MarcosAsh/protocol-emulator/docs/index.md

# protocol-emulator

A small chip that bit-bangs protocols from firmware, and a checker that proves the firmware's
timing before it ever runs. Written in Hardcaml for Jane Street's protocol emulator ASIC
competition, built on IHP CMOS5L through Tiny Tapeout, in 8 x 4 tiles at 48 MHz.

<!-- numbers from files the site already serves: info.yaml, the results page's tally, the
     corpus table; a missing source leaves its number out -->
<style>
  .stats { list-style: none; padding: 0; margin: 0 0 4px; }
  .stats li { display: inline; }
  .stats li + li::before { content: " \00b7\00a0"; color: var(--pst-color-text-muted); }
  .stats span::before { content: " "; }
</style>
<ul class="stats" id="stats" hidden></ul>
<p id="tally" hidden></p>
<script>
  (() => {
    const stats = document.getElementById("stats");
    const stat = (value, label) => {
      const li = document.createElement("li");
      const b = document.createElement("b");
      const span = document.createElement("span");
      b.textContent = value;
      span.textContent = label;
      li.append(b, span);
      stats.append(li);
      stats.hidden = false;
    };
    const text = (path) => fetch(path).then((r) => (r.ok ? r.text() : ""), () => "");
    const page = (path) => text(path).then((t) => new DOMParser().parseFromString(t, "text/html"));
    const results = page("results/").then((d) => {
      const tally = d.getElementById("tally");
      return tally ? tally.textContent.replace(/\.$/, "") : "";
    });
    const corpus = page("corpus/").then((d) => d.querySelectorAll('table a[href$=".html"]').length);
    Promise.all([text("info.yaml"), results, corpus]).then(([yaml, tally, protocols]) => {
      const hz = /^\s*clock_hz:\s*(\d+)/m.exec(yaml);
      const tiles = /^\s*tiles:\s*"?(\d+x\d+)/m.exec(yaml);
      const viewer = document.getElementById("viewer");
      const pdk = viewer ? new URL(viewer.href).searchParams.get("pdk") || "" : "";
      const proof = /(\d+) proved for all time/.exec(tally);
      if (protocols) stat(protocols, "in the corpus");
      if (proof) stat(proof[1], "claims proved for all time");
      if (hz) stat(Number(hz[1]) / 1e6, "MHz clock");
      if (tiles) stat(tiles[1], "tiles, IHP " + pdk.replace(/^ihp-sg13/, ""));
      if (tally) {
        const p = document.getElementById("tally");
        p.firstChild.textContent = tally;
        p.hidden = false;
      }
    });
  })();
</script>

from firmware to silicon

Two small cores drive the pins from firmware, much like the RP2040's PIO. The difference is
time. Each core has a 24-bit clock, a deadline register `t` and a period `p`. `wait t+`
releases on the exact cycle of the deadline and moves it on by one period, so a frame never
drifts. A UART bit or an I2C hold time is a deadline written in the program, not a count of
instructions you hope adds up.

A small kernel checks a certificate of each program's timing and refuses anything it can't
check. The kernel is proved against the RTL. If it accepts a program, that program never
misses a deadline on the chip, under the assumptions in
[What is not proved](verification.md#what-is-not-proved). The chip runs that check itself
and refuses to start an engine whose walk fails. If a deadline is ever missed anyway, the
engine lets go of its pins and halts, and that is proved too.

Start with [Getting started](getting-started.md), or paste firmware into the playground.

## Elsewhere on the site

<ul>
<li><a href="playground/">Firmware timing playground</a>: the assembler, the timing analyser and the kernel, compiled to JavaScript with js_of_ocaml.</li>
<li><a href="die/">Live die</a>: the hardened die, cells and wires lit as they switch.</li>
<!-- results -->
<li><a href="results/">Results</a>: the claims CI checks, the job that checks each, and its last run on main.</li>
<!-- /results -->
<!-- corpus -->
<li><a href="corpus/">Protocol corpus</a>: each protocol's limits, firmware, certificate and board runs, failures included.</li>
<!-- /corpus -->
<li><a id="viewer" href="https://gds-viewer.tinytapeout.com/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">3D viewer</a>: the last green gds run on main in Tiny Tapeout's GDS viewer, also as <a href="tinytapeout.gds">GDS</a> and <a href="tinytapeout.oas">OASIS</a>, and its <a href="gds_render.png">render</a>.</li>
</ul>

```{toctree}
:hidden:
:caption: Start
:maxdepth: 1

getting-started
```

```{toctree}
:hidden:
:caption: Design
:maxdepth: 1

architecture
datasheet
comparison
protocols
```

```{toctree}
:hidden:
:caption: Evidence
:maxdepth: 1

verification
flexibility
ai-use
```

```{toctree}
:hidden:
:caption: Hardware
:maxdepth: 1

hardware
lab
```

```{toctree}
:hidden:
:caption: Site
:maxdepth: 1

Playground <https://marcosash.github.io/protocol-emulator/playground/>
Results <https://marcosash.github.io/protocol-emulator/results/>
Live die <https://marcosash.github.io/protocol-emulator/die/>
Repository <https://github.com/MarcosAsh/protocol-emulator>
```
