MarcosAsh/protocol-emulator/test/board/kernel_vs_board/verdicts.tsv

uart_tx | 0 | 8 | 4 | 1 | accepted
uart_tx | 1 | 8 | 4 | 1 | accepted
uart_tx | 2 | 8 | 4 | 1 | accepted
uart_tx | 3 | 8 | 4 | 1 | accepted
uart_tx | 4 | 8 | 4 | 1 | accepted
uart_tx | 5 | 8 | 4 | 0 | refused: pc 9: in time
uart_tx | 6 | 8 | 4 | 0 | refused: pc 9: in time
uart_tx | 7 | 8 | 4 | 0 | refused: pc 9: in time
uart_tx16 | 0 | 8 | 12 | 1 | accepted
uart_tx16 | 1 | 8 | 12 | 1 | accepted
uart_tx16 | 2 | 8 | 12 | 1 | accepted
uart_tx16 | 3 | 8 | 12 | 1 | accepted
uart_tx16 | 4 | 8 | 12 | 1 | accepted
uart_tx16 | 5 | 8 | 12 | 1 | accepted
uart_tx16 | 6 | 8 | 12 | 1 | accepted
uart_tx16 | 7 | 8 | 12 | 1 | accepted
uart_tx16 | 8 | 8 | 12 | 1 | accepted
uart_tx16 | 9 | 8 | 12 | 1 | accepted
uart_tx16 | 10 | 8 | 12 | 1 | accepted
uart_tx16 | 11 | 8 | 12 | 1 | accepted
uart_tx16 | 12 | 8 | 12 | 1 | accepted
uart_tx16 | 13 | 8 | 12 | 0 | refused: pc 9: in time
uart_tx16 | 14 | 8 | 12 | 0 | refused: pc 9: in time
uart_tx16 | 15 | 8 | 12 | 0 | refused: pc 9: in time
uart_tx_host_rate | 0 | 10 | 430 | 1 | accepted
uart_tx_host_rate | 1 | 10 | 430 | 1 | accepted
uart_tx_host_rate | 2 | 10 | 430 | 1 | accepted
uart_tx_host_rate | 3 | 10 | 430 | 1 | accepted
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
