MarcosAsh/protocol-emulator/icepi/icepi_top.v

/*
 * Copyright (c) 2026 Marcos Ashton
 * SPDX-License-Identifier: Apache-2.0
 */

`default_nettype none

// The chip on an Icepi Zero. The 50 MHz oscillator goes through the PLL to MHZ (48, or 40
// for 10BASE-T, whose bit is four cycles) and the pins sit on the 40-pin header. With
// USB_UIO set, uio[1:0] are D+/D- on the first USB-C port, with the board's pull-up on D-
// for low speed or on D+ for full speed (FULL_SPEED). Their header pins mirror the bus so
// a host can see a bus reset. USB_PROBE moves the bus to header 8 (D+) and 12 (D-), in
// place of OUT0 and OUT2, where the bench carrier's analyser A reads D4 and D6. The
// button is reset.
module icepi_top #(
    parameter USB_UIO = 1,
    parameter MHZ = 48,
    parameter FULL_SPEED = 0,
    parameter USB_PROBE = 0
) (
    input  wire       clk,
    input  wire       button_n,
    input  wire [7:0] ui,
    output wire [7:0] uo,
    inout  wire [7:0] uio,
    inout  wire       usb_dp,
    inout  wire       usb_dn,
    output wire       usb_pull_dp,
    output wire       usb_pull_dn,
    input  wire       usb_detach
);

  wire clk_chip;
  wire clk_feedback;
  wire locked;

  // ecppll -i 50 -o 48 --highres: 50 / 5 = 10 MHz at the phase detector, VCO 480 MHz,
  // and CLKOS divides that by 10 for 48 MHz or 12 for 40.
  localparam CLKOS_MHZ = MHZ == 40 ? "40" : "48";
  (* FREQUENCY_PIN_CLKI = "50" *)
  (* FREQUENCY_PIN_CLKOS = CLKOS_MHZ *)
  (* ICP_CURRENT = "12" *)
  (* LPF_RESISTOR = "8" *)
  (* MFG_ENABLE_FILTEROPAMP = "1" *)
  (* MFG_GMCREF_SEL = "2" *)
  EHXPLLL #(
      .PLLRST_ENA("DISABLED"),
      .INTFB_WAKE("DISABLED"),
      .STDBY_ENABLE("DISABLED"),
      .DPHASE_SOURCE("DISABLED"),
      .OUTDIVIDER_MUXA("DIVA"),
      .OUTDIVIDER_MUXB("DIVB"),
      .OUTDIVIDER_MUXC("DIVC"),
      .OUTDIVIDER_MUXD("DIVD"),
      .CLKI_DIV(5),
      .CLKOP_ENABLE("ENABLED"),
      .CLKOP_DIV(48),
      .CLKOP_CPHASE(9),
      .CLKOP_FPHASE(0),
      .CLKOS_ENABLE("ENABLED"),
      .CLKOS_DIV(480 / MHZ),
      .CLKOS_CPHASE(0),
      .CLKOS_FPHASE(0),
      .FEEDBK_PATH("CLKOP"),
      .CLKFB_DIV(1)
  ) pll (
      .RST(1'b0),
      .STDBY(1'b0),
      .CLKI(clk),
      .CLKOP(clk_feedback),
      .CLKOS(clk_chip),
      .CLKFB(clk_feedback),
      .CLKINTFB(),
      .PHASESEL0(1'b0),
      .PHASESEL1(1'b0),
      .PHASEDIR(1'b1),
      .PHASESTEP(1'b1),
      .PHASELOADREG(1'b1),
      .PLLWAKESYNC(1'b0),
      .ENCLKOP(1'b0),
      .LOCK(locked)
  );

  wire [7:0] uio_in;
  wire [7:0] uio_out;
  wire [7:0] uio_oe;
  wire [7:0] uo_out;
  wire [7:0] header_in;
  wire [1:0] usb_in;

  wire [7:0] header_out = USB_UIO ? {uio_out[7:2], usb_in} : uio_out;
  wire [7:0] header_oe = USB_UIO ? {uio_oe[7:2], 2'b11} : uio_oe;
  wire [1:0] usb_oe = USB_UIO ? uio_oe[1:0] : 2'b00;

  BB uio_pad[7:0] (
      .B(uio),
      .I(header_out),
      .T(~header_oe),
      .O(header_in)
  );

  BB usb_pad[1:0] (
      .B({usb_dn, usb_dp}),
      .I(uio_out[1:0]),
      .T(~usb_oe),
      .O(usb_in)
  );

  assign uio_in = USB_UIO ? {header_in[7:2], usb_in} : header_in;

  // A pull pin driven high pulls its line up through a diode and 1.1 k. Floating, it
  // leaves the line alone. Driven low it would add a 15 k pull-down like the host's.
  OBZ pull_dp_pad (
      .I(1'b1),
      .T(!USB_UIO || !FULL_SPEED || usb_detach),
      .O(usb_pull_dp)
  );

  OBZ pull_dn_pad (
      .I(1'b1),
      .T(!USB_UIO || FULL_SPEED || usb_detach),
      .O(usb_pull_dn)
  );

  // no synchroniser here, the core does that itself
  assign uo = USB_PROBE ? {uo_out[7:4], usb_in[1], uo_out[2], usb_in[0], uo_out[0]} : uo_out;

  tt_um_marcosash_protocol_emulator chip (
      .ui_in(ui),
      .uo_out(uo_out),
      .uio_in(uio_in),
      .uio_out(uio_out),
      .uio_oe(uio_oe),
      .ena(1'b1),
      .clk(clk_chip),
      .rst_n(locked & button_n)
  );

endmodule
