MarcosAsh/protocol-emulator/python/learn_record.py

# SPDX-License-Identifier: Apache-2.0
# The chip records a transmitter it was never told about (MicroPython, Pico A). Each engine
# runs the edge logger on its line and stamps every edge with its own 16-bit clock. This
# script drains the stamps and reads the clock after each drain to extend every stamp to
# whole cycles, using the Pico's microseconds to count the clock's wraps between reads.
# If a drain finds stamps more than 65536 cycles (1.4 ms at 48 MHz) after the last, it marks
# the recording broken rather than guess. With two lines, engine 1 starts first and stamps
# the wire engine 0 raises as it starts, which puts both on one clock. record.json
# (demo/learn_prepare.py) has the loggers; record.edges and record.log are kept.

import array
import gc
import json
import os
import time

import micropython

import pico_board
import protocol_emulator as pe

CLOCK_HZ = 48_000_000
# cycles from engine 0 raising the wire to engine 1 stamping it: the same path as an edge
# on a pin, minus its two synchronizer flops
SYNC_CYCLES = 2
LATE_US = 1000


def load(host, engine):
    """Load and certify the logger. Every engine must be halted for the certificate."""
    host.select(engine["engine"])
    host.stop()
    host.flush()
    host.configure(dict(pe.DEFAULT_CONFIG, **engine["config"]))
    host.load(engine["words"])
    host.certify(engine["certificate"])


SELECTS = [bytes((0x80 | pe.SELECT, 0, engine)) for engine in range(2)]
# stamps an engine can hold, enough for a recording
MOST = 3000
NOW = array.array("i", [0])
# progress of a recording: the step of the loop, and the polls done
AT = array.array("i", [0, 0])


@micropython.native
def poll(spi, engine, words, count):
    """Select engine, put its waiting words in words from count, and return the new count.
    The low half of its clock, read after the drain, goes in NOW. Nothing here allocates,
    since the heap is locked while recording."""
    # one name per line, since assigning four names at once would build a tuple
    cs_n = spi.cs_n
    bus = spi.spi
    status = spi.status
    rx_in = spi.rx_in
    cs_n(0)
    bus.write(SELECTS[engine])
    cs_n(1)
    cs_n(0)
    bus.write_readinto(spi.reads[pe.STATUS], status)
    cs_n(1)
    level = (status[1] >> 2) & 15
    if level:
        out, into = spi.rx_frames[level]
        cs_n(0)
        bus.write_readinto(out, into)
        cs_n(1)
        for i in range(1, 1 + 2 * level, 2):
            if count < MOST:
                words[count] = rx_in[i] << 8 | rx_in[i + 1]
                count += 1
    cs_n(0)
    bus.write_readinto(spi.reads[pe.NOW_LO], status)
    cs_n(1)
    NOW[0] = status[1] << 8 | status[2]
    return count


def record(spi, host, engines, ms):
    # start engine 1 first if there are two; it waits for engine 0's wire
    for e in sorted(engines, key=lambda e: -e["engine"]):
        load(host, e)
    n = len(engines)
    ids = [e["engine"] for e in engines]
    words = [array.array("H", (0 for _ in range(MOST))) for _ in range(n)]
    times = [array.array("i", (0 for _ in range(MOST))) for _ in range(n)]
    counts = [0] * n
    last = [0] * n
    clock = [0] * n
    late = 0
    # a collection mid-recording would make a poll late
    gc.collect()
    # the clocks start here, so the first poll's wraps count from now and not from before
    # the arrays were made
    for e in sorted(engines, key=lambda e: -e["engine"]):
        host.select(e["engine"])
        host.start()
    then = [time.ticks_us()] * n
    start = time.ticks_ms()
    AT[0] = 0
    # a locked heap raises MemoryError at the first allocation instead of running out
    # seconds later
    micropython.heap_lock()
    try:
        while time.ticks_diff(time.ticks_ms(), start) < ms:
            for k in range(n):
                AT[0] = 1
                before = counts[k]
                count = poll(spi, ids[k], words[k], before)
                AT[0] = 2
                now = NOW[0]
                counts[k] = count
                t = time.ticks_us()
                gap = time.ticks_diff(t, then[k])
                then[k] = t
                AT[0] = 3
                # the whole 65536s of the clock come from the Pico's microseconds, the rest
                # from the clock itself
                low = (now - last[k]) & 0xFFFF
                wraps = (gap * (CLOCK_HZ // 1_000_000) - low + 32768) >> 16
                clock[k] += low + (wraps << 16 if wraps > 0 else 0)
                last[k] = now
                AT[0] = 4
                if count > before and gap > LATE_US:
                    # a stamp could be one wrap older than it reads
                    late += 1
                AT[0] = 5
                for i in range(before, count):
                    times[k][i] = clock[k] - ((now - words[k][i]) & 0xFFFF)
                AT[1] += 1
    finally:
        micropython.heap_unlock()
    words = [list(w[:c]) for w, c in zip(words, counts)]
    times = [list(t[:c]) for t, c in zip(times, counts)]
    faults = []
    for e in engines:
        host.select(e["engine"])
        faults.append(host.read(pe.STATUS)[0] & 0x3C)
        host.stop()
    return words, times, late, faults


def run(log=print):
    # drop any recording left by an earlier run
    try:
        os.remove("record.edges")
    except OSError:
        pass
    settings = json.load(open("record.json"))
    engines = settings["engines"]
    spi = pico_board.PicoSpi()
    host = pe.Host(spi.transfer)
    words, times, late, faults = record(spi, host, engines, settings["ms"])
    lines = []
    offset = 0
    for k, e in enumerate(engines):
        # the sync stamp, then the line's level, then one edge per word
        skip = 1 + (1 if e.get("sync") else 0)
        if e.get("sync"):
            offset = times[k][0] - SYNC_CYCLES
        lines.append((e, words[k][skip - 1] if len(words[k]) >= skip else None, times[k][skip:]))
    out = ["rate %d" % CLOCK_HZ]
    pins = []
    length = 0
    for e, level, edges in lines:
        # engine 0's clock started at its own start, which engine 1 saw at offset
        shift = 0 if e.get("sync") else offset
        edges = [t + shift for t in edges]
        if edges:
            length = max(length, edges[-1] + 1)
        pins.append("pin %s %d %s" % (e["name"], level or 0, " ".join(str(t) for t in edges)))
    out.append("length %d" % length)
    with open("record.edges", "w") as f:
        f.write("\n".join(out + pins) + "\n")
    for (e, _, edges), fault in zip(lines, faults):
        log("%s: %d edges stamped by engine %d, faults 0x%x" % (e["name"], len(edges), e["engine"], fault))
    log("drains with stamps more than %d us apart: %d" % (LATE_US, late))
    ok = not late and not any(faults) and all(len(edges) for _, _, edges in lines)
    log("PASS" if ok else "FAIL")
    return ok


if __name__ == "__main__":
    lines = []

    def log(text):
        print(text)
        lines.append(text)

    try:
        run(log)
    except Exception as e:
        log("stopped: %r at step %d of poll %d, %d bytes free" % (e, AT[0], AT[1], gc.mem_free()))
        log("FAIL")
    with open("record.log", "w") as f:
        f.write("\n".join(lines) + "\n")
