MarcosAsh/protocol-emulator/python/learn_replay.py

# SPDX-License-Identifier: Apache-2.0
# Pico B plays a transmitter the chip was never told about (MicroPython). Plays replay.json's
# segments, each giving which lines are pulled low and for how many microseconds, from a PIO
# machine at 1 MHz on GP2 (IO3) and GP3 (IO2). The pins are open drain against the
# carrier's pull-ups, like an IR receiver module's output. Segments come from public
# recordings (demo/learn_prepare.py).

import array
import json
import time

import rp2
from machine import Pin

# pull, out and out before the count's first pass, then the count's last pass
OVERHEAD = 4
# demo/capture.sh starts the analyser after mpremote returns, and that takes up to 3 s
START_MS = 3000
# the lines stay at the recording's idle level this long afterwards, past the end of the
# chip's recording, so a line that idles low is low at both ends of the recording
HOLD_MS = 5000


@rp2.asm_pio(set_init=(rp2.PIO.IN_LOW,) * 2, out_init=(rp2.PIO.IN_LOW,) * 2,
             out_shiftdir=rp2.PIO.SHIFT_RIGHT)
def segments():
    # pin values stay low, so pulling a line low only changes its direction
    set(pins, 0)  # noqa: F821
    wrap_target()  # noqa: F821
    pull(block)  # noqa: F821
    out(pindirs, 2)  # noqa: F821
    out(x, 30)  # noqa: F821
    label("count")  # noqa: F821
    jmp(x_dec, "count")  # noqa: F821
    wrap()  # noqa: F821


def words(segs):
    return [low | ((max(us, OVERHEAD + 1) - OVERHEAD) << 2) for low, us in segs]


def send(segs):
    sm = rp2.StateMachine(0, segments, freq=1_000_000, set_base=Pin(2), out_base=Pin(2))
    sm.active(1)
    sm.put(array.array("I", words(segs)))
    # the last segment is idle, so the lines are released when it starts
    total_ms = sum(us for _, us in segs) // 1000
    time.sleep_ms(total_ms + 20)
    sm.active(0)
    Pin(2, Pin.IN)
    Pin(3, Pin.IN)


if __name__ == "__main__":
    replay = json.load(open("replay.json"))
    segs = replay["segments"]
    send([[segs[0][0], START_MS * 1000]] + segs + [[segs[-1][0], HOLD_MS * 1000], [0, 1000]])
    print("sent %d segments" % len(replay["segments"]))
