MarcosAsh/protocol-emulator/formal/usb_roundtrip.sv

// Round trip: a host sends one packet (any PID byte) from any sampling phase, at exactly
// 8 samples a bit, into usb_frame_rx with may_write free. The packet is data of up to BYTES
// bytes with its CRC-16, a token with its CRC-5, or a handshake. Each word written is the
// bytes sent as the receiver packs them, at base + its index. At finished, the counts,
// half, aligned and CRC are right. With SEVEN, any bits after SYNC that contain seven 1s
// end in stuff_error. With TWICE, the receiver is armed once with rearm held, and a packet
// of its own follows the first once that has landed. finished falls as the second starts,
// its words land from base as the first's did, and the same checks hold for it.

`ifndef BYTES
`define BYTES 8
`endif

module usb_roundtrip (input clk);
  localparam N = `BYTES;
  localparam M = 8 * N + 24;
  localparam DATA = 2'd0, TOKEN = 2'd1, HANDSHAKE = 2'd2;
  localparam [1:0] J = 2'b10, K = 2'b01, SE0 = 2'b00;
  localparam GAP = 3'd0, SYNC = 3'd1, MESSAGE = 3'd2, EOP = 3'd3, DONE = 3'd4;
  localparam IDLE = 2'd0, HUNT = 2'd1, PACKET = 2'd2;

  (* anyconst *) wire [1:0] kind_1;
  (* anyconst *) wire [7:0] pid_1;
  (* anyconst *) wire [7:0] len_1;
  (* anyconst *) wire [8*N-1:0] payload_1;
  (* anyconst *) wire [10:0] token_1;
  // which packet is on the line: the first, or with TWICE the second once its gap starts
  reg round = 0;
`ifdef TWICE
  (* anyconst *) wire [1:0] kind_2;
  (* anyconst *) wire [7:0] pid_2;
  (* anyconst *) wire [7:0] len_2;
  (* anyconst *) wire [8*N-1:0] payload_2;
  (* anyconst *) wire [10:0] token_2;
  wire [1:0] kind = round ? kind_2 : kind_1;
  wire [7:0] pid = round ? pid_2 : pid_1;
  wire [7:0] len = round ? len_2 : len_1;
  wire [8*N-1:0] payload = round ? payload_2 : payload_1;
  wire [10:0] token = round ? token_2 : token_1;
  always @(*) assume(kind_2 != 3 && len_2 <= N);
  wire rearm = 1;
`else
  wire [1:0] kind = kind_1;
  wire [7:0] pid = pid_1;
  wire [7:0] len = len_1;
  wire [8*N-1:0] payload = payload_1;
  wire [10:0] token = token_1;
  wire rearm = 0;
`endif
  (* anyconst *) wire [2:0] offset;
  (* anyconst *) wire [1:0] gap;
  (* anyconst *) wire [8:0] base;
  (* anyseq *) wire may_write;
  // SEVEN: any bits after SYNC, unstuffed
  (* anyseq *) wire raw;

  always @(*) begin
    assume(kind_1 != 3);
    assume(len_1 <= N);
  end

`ifdef SHORT
  // a tooth's packet, short enough to fail fast
  always @(*) assume(gap == 0 && offset == 0 && len == 0);
`endif
`ifdef SHORT_TWICE
  // a tooth's two packets: a handshake, then a token
  always @(*) assume(gap == 0 && offset == 0 && kind_1 == HANDSHAKE && kind_2 == TOKEN);
`endif
`ifdef PINNED
  // each cover starts from the bus idle as soon as it can, with DATA0 and all 1s to stuff
  // the most, so the solver only has to choose the kind and may_write
  always @(*) begin
    assume(gap == 0 && offset == 0 && pid == 8'hc3);
    assume(payload == {8*N{1'b1}} && token == 11'h7ff);
`ifdef LONG
    assume(kind == DATA && len == N);
`else
    assume(len == 0);
`endif
  end
`endif

  // cleared, then armed, then left alone
  reg [1:0] age = 0;
  always @(posedge clk) if (age != 3) age <= age + 2'd1;
  wire clear = age == 0;
  wire arm = age == 1;

  // the message after SYNC, first bit lowest: the PID, then either the payload and its
  // CRC-16, or the address, endpoint and their CRC-5. Each CRC is complemented as USB sends it.
  reg [15:0] crc16 = 16'hffff;
  reg [4:0] crc5 = 5'h1f;
`ifdef CRC_RAW
  wire [15:0] crc16_sent = crc16;
  wire [4:0] crc5_sent = crc5;
`else
  wire [15:0] crc16_sent = ~crc16;
  wire [4:0] crc5_sent = ~crc5;
`endif
  wire [9:0] covered = kind == DATA ? {len, 3'd0} : kind == TOKEN ? 10'd11 : 10'd0;
  wire [9:0] message_bits = 10'd8 + covered
    + (kind == DATA ? 10'd16 : kind == TOKEN ? 10'd5 : 10'd0);
  wire [7:0] bytes = message_bits[9:3];
  wire [8*N-1:0] shown = payload & ~({8*N{1'b1}} << covered);
  wire [M-1:0] message = kind == DATA
      ? {{M-8*N-8{1'b0}}, shown, pid} | ({{M-16{1'b0}}, crc16_sent} << (covered + 10'd8))
    : kind == TOKEN ? {{M-24{1'b0}}, crc5_sent, token, pid} : {{M-8{1'b0}}, pid};

  reg [2:0] state = GAP;
  // cycles idle after the packet, until may_write comes
  reg [1:0] idle = 0;
  reg [9:0] count = 0;
  reg [2:0] ones = 0;
  reg seven = 0;
  reg stuffed = 0;
  reg [1:0] line = J;
  reg [2:0] sub = 0;

  wire [M-1:0] message_at = message >> count;
`ifdef SEVEN
  // chosen a bit ahead, so it holds while the bit is on the wire
  reg raw_bit = 0;
  always @(posedge clk) if (sub == 3 || sub == 4) raw_bit <= raw;
  wire data_bit = raw_bit;
`else
  wire data_bit = message_at[0];
`endif
`ifdef NO_STUFF
  wire stuff = 0;
`else
  wire stuff = ones == 6;
`endif
  wire [1:0] toggled = line == J ? K : J;

  // the encoder after one more bit, and that bit's line state
  reg [1:0] next_line;
  reg [2:0] next_state;
  reg [9:0] next_count;
  reg [2:0] next_ones;
  reg [15:0] next_crc16;
  reg [4:0] next_crc5;
  always @(*) begin
    next_line = line;
    next_state = state;
    next_count = count + 10'd1;
    next_ones = ones;
    next_crc16 = crc16;
    next_crc5 = crc5;
    case (state)
      GAP: begin
        next_line = J;
        if (count == gap) begin
          next_state = SYNC;
          next_count = 0;
        end
      end
      SYNC: begin
        // KJKJKJKK: seven 0s and a 1, which starts the run
        next_line = count == 7 ? line : toggled;
        if (count == 7) begin
          next_state = MESSAGE;
          next_count = 0;
          next_ones = 1;
        end
      end
      MESSAGE:
        if (stuff) begin
          next_line = toggled;
          next_count = count;
          next_ones = 0;
        end else if (count < message_bits) begin
          next_line = data_bit ? line : toggled;
          next_ones = data_bit ? (ones == 7 ? ones : ones + 3'd1) : 3'd0;
          if (count >= 8 && count < 8 + covered) begin
            next_crc16 = {1'b0, crc16[15:1]} ^ (crc16[0] ^ data_bit ? 16'ha001 : 16'd0);
            next_crc5 = {1'b0, crc5[4:1]} ^ (crc5[0] ^ data_bit ? 5'h14 : 5'd0);
          end
        end else begin
          next_line = SE0;
          next_state = EOP;
          next_count = 1;
        end
      EOP: begin
        next_line = count == 1 ? SE0 : J;
        if (count == 2) next_state = DONE;
      end
      default: begin
        next_line = J;
        next_count = count;
`ifdef TWICE
        if (!round && idle == 3) begin
          next_state = GAP;
          next_count = 0;
        end
`endif
      end
    endcase
  end

  // The bit on the wire is decided at its centre, sample 4 of 8. line and the state are
  // the encoder's as of the last bit decided. There are two samples per cycle; sub is the
  // place of the first.
  wire decide = sub == 3 || sub == 4;
  wire [1:0] first = sub <= 4 ? next_line : line;
  wire [1:0] second = sub == 5 || sub == 6 ? line : next_line;
  always @(posedge clk) begin
    sub <= clear ? offset : sub + 3'd2;
    if (!clear && decide) begin
      line <= next_line;
      state <= next_state;
      count <= next_count;
      ones <= next_ones;
      crc16 <= next_crc16;
      crc5 <= next_crc5;
      if (state == MESSAGE && !stuff && count < message_bits && ones == 6 && data_bit)
        seven <= 1;
      if (state == MESSAGE && stuff) stuffed <= 1;
      if (state == DONE && next_state == GAP) begin
        round <= 1;
        crc16 <= 16'hffff;
        crc5 <= 5'h1f;
      end
    end
  end

  wire write_valid;
  wire [8:0] write_addr;
  wire [15:0] write_data;
  wire [9:0] words;
  wire finished, crc5_ok, crc16_ok, half, aligned, stuff_error, dropped, receiving, armed;
  // the receiver's state, which the lemmas below tie to the encoder's
  wire [2:0] rx_phase, rx_ones, pid_bits;
  wire [1:0] rx_sm, rx_zeros;
  wire [15:0] rx_word, frame_crc16;
  wire [3:0] rx_word_bits;
  wire [4:0] frame_crc5;
  wire rx_last_dp, rx_was_low, pending, ended, past_pid;

  usb_frame_rx_top dut (
    .clock(clk), .clear(clear),
    .dp({second[1], first[1]}), .dm({second[0], first[0]}),
    .control$arm(arm), .control$base(base), .control$rearm(rearm),
    .may_write(may_write),
    .write$valid(write_valid), .write$addr(write_addr), .write$data(write_data),
    .status$words(words), .status$finished(finished), .status$crc5_ok(crc5_ok),
    .status$crc16_ok(crc16_ok), .status$half(half), .status$aligned(aligned),
    .status$stuff_error(stuff_error), .status$dropped(dropped),
    .status$receiving(receiving), .status$armed(armed),
    .rx_phase(rx_phase), .rx_last_dp(rx_last_dp), .rx_was_low(rx_was_low), .rx_sm(rx_sm),
    .rx_zeros(rx_zeros), .rx_ones(rx_ones), .rx_word(rx_word),
    .rx_word_bits(rx_word_bits), .pending(pending), .ended(ended), .pid_bits(pid_bits),
    .past_pid(past_pid), .frame_crc16(frame_crc16), .frame_crc5(frame_crc5));

  // the message packed two bytes to a word, as the receiver packs it; 0 past its end
  wire [9:0] expected_words = (message_bits + 10'd15) >> 4;
  wire [8:0] index = write_addr - base;
  wire [M+15:0] message_word = {16'd0, message} >> {index, 4'd0};
  wire [15:0] expected = message_word[15:0];

  reg [9:0] wrote = 0;
  always @(posedge clk)
    if (state == DONE && next_state == GAP && decide) wrote <= 0;
    else if (!clear && write_valid) wrote <= wrote + 10'd1;

  // may_write only comes once the line is idle, so the last word lands
  always @(posedge clk)
    if (state != DONE || (decide && next_state != DONE)) idle <= 0;
    else if (idle != 3) idle <= idle + 2'd1;
  always @(*) if (state == DONE) assume(may_write);

  always @(*) if (!clear) begin
`ifndef SEVEN
    if (write_valid) begin
      assert(index < expected_words);
      assert(write_data == expected);
      assert(dropped || index == wrote);
    end
    assert(!stuff_error);
    if (finished && (!round || state >= EOP)) begin
      assert(words == expected_words);
      assert(half == bytes[0]);
      assert(aligned);
      assert(dropped || wrote == expected_words);
      if (kind == DATA) assert(crc16_ok);
      if (kind == TOKEN) assert(crc5_ok);
    end
    if (idle >= 2) assert(finished);
`ifdef TWICE
    if (round) assert(armed);
    if (round && state == MESSAGE && count != 0) assert(!finished);
`endif
`else
    // seven 1s in a row is a stuffing error, never a good packet
    if (finished && seven) assert(stuff_error);
    if (idle >= 2 && seven) assert(finished && stuff_error);
`endif
  end

  // the CRC register after n of the bits sent, starting from its frozen value r
  function [15:0] crc16_tail(input [15:0] r, input [15:0] sent, input [4:0] n);
    integer i;
    reg [15:0] c;
    begin
      c = r;
      for (i = 0; i < 16; i = i + 1)
        if (i < n) c = {1'b0, c[15:1]} ^ (c[0] ^ sent[i] ? 16'ha001 : 16'd0);
      crc16_tail = c;
    end
  endfunction
  function [4:0] crc5_tail(input [4:0] r, input [4:0] sent, input [2:0] n);
    integer i;
    reg [4:0] c;
    begin
      c = r;
      for (i = 0; i < 5; i = i + 1)
        if (i < n) c = {1'b0, c[4:1]} ^ (c[0] ^ sent[i] ? 5'h14 : 5'd0);
      crc5_tail = c;
    end
  endfunction

  wire taking = sub == 5 || sub == 6;
  // until the frame takes its SYNC, the second packet's count is still the first's
  wire stale = round && (state < MESSAGE || (state == MESSAGE && count == 0 && taking));
  wire heard = state > SYNC || (state == SYNC && (count != 0 || (sub >= 1 && sub <= 4)));
  wire [M+15:0] received = {message, 16'd0} >> count;
  wire [15:0] known = count >= 16 ? 16'hffff : ~(16'hffff >> count);
  wire [9:0] crc_bits = count - 10'd8 - covered;

  // Lemmas that make the above inductive. The receiver keeps step with the encoder: it
  // decides each bit in the cycle the encoder does, and the frame takes the receiver's
  // outputs the cycle after, while sub is 5 or 6.
`ifndef NO_LEMMAS
  always @(*) begin
    assert(clear == (age == 0));
    assert(state <= DONE);
    if (age <= 1) assert(state == GAP && line == J);
    if (age == 0) assert(count == 0);
    if (state == GAP) assert(count <= gap && line == J);
    if (state == SYNC) assert(count <= 7 && line == (count[0] ? K : J));
    if (state == MESSAGE) assert(count <= message_bits && (line == J || line == K));
    if (state == EOP) assert((count == 1 || count == 2) && line == SE0);
    if (state == DONE) assert(line == J);
    if (state != DONE) assert(idle == 0);
    if (state < MESSAGE || (state == MESSAGE && count <= 8))
      assert(crc16 == 16'hffff && crc5 == 5'h1f);
`ifndef NO_STUFF
    assert(ones <= 6);
`endif
    if (!seven) assert(!(state == MESSAGE && ones == 7));
`ifndef TWICE
    assert(!round);
`endif
  end

  // the receiver
  always @(*) if (age >= 2) begin
    assert(rx_last_dp == (sub >= 1 && sub <= 4 ? next_line[1] : line[1]));
    assert(rx_was_low == !line[1]);
    if (heard) assert(rx_phase == sub - 3'd1);
    if (state == GAP || (state == SYNC && count == 0)) assert(rx_sm == IDLE);
    if (state == SYNC && count != 0)
      assert(rx_sm == HUNT && rx_zeros == (count >= 3 ? 2'd3 : count[1:0]));
    if (!seven) begin
      if (state == MESSAGE) assert(rx_sm == PACKET && rx_ones == ones);
      if (state >= EOP) assert(rx_sm == IDLE);
`ifndef SEVEN
      if (state == MESSAGE)
        assert(rx_word_bits == count[3:0] && ((rx_word ^ received[15:0]) & known) == 0);
`endif
    end
  end

  // the frame, as of the last bit decided
  always @(*) if (age >= 2 && !taking) begin
    if (rearm) assert(armed);
    else assert(armed == (!seven && state <= MESSAGE));
    assert(receiving == (!seven && state == MESSAGE));
    // the first packet's verdict holds until the second's SYNC
    assert(ended == (seven || state >= EOP || (round && state < MESSAGE)));
    if (state < MESSAGE) assert(!pending && wrote == 0);
    if (state < MESSAGE && !round) assert(words == 0 && !dropped);
    if (seven) assert(stuff_error);
`ifndef SEVEN
    if (state == MESSAGE) begin
      assert(pid_bits == count[2:0] && past_pid == count >= 8 && words == count >> 4);
      if (kind == DATA)
        assert(frame_crc16 == (count <= 8 + covered ? crc16
          : crc16_tail(crc16, crc16_sent, crc_bits)));
      if (kind == TOKEN)
        assert(frame_crc5 == (count <= 8 + covered ? crc5
          : crc5_tail(crc5, crc5_sent, crc_bits)));
    end
    if (state >= EOP) begin
      assert(words == expected_words && half == bytes[0] && aligned);
      if (kind == DATA) assert(crc16_ok);
      if (kind == TOKEN) assert(crc5_ok);
    end
`endif
  end

  // the word waiting for may_write
  always @(*) if (age >= 2) begin
`ifndef SEVEN
    if (pending) assert(index + 9'd1 == words && write_data == expected);
    if (!dropped && !stale) assert(wrote + pending == words);
`endif
    if (idle >= 1) assert(!pending);
  end
`endif

  always @(*) if (!clear) begin
`ifdef SEVEN
    cover(finished && seven && stuff_error);
`elsif TWICE
    cover(round && idle == 3 && kind == DATA && crc16_ok && !dropped);
    cover(round && idle == 3 && kind == TOKEN && crc5_ok && !dropped);
`elsif LONG
    cover(finished && stuffed && !dropped && crc16_ok);
`else
    cover(finished && kind == DATA && len == 0 && crc16_ok);
    cover(finished && kind == TOKEN && crc5_ok);
    cover(finished && kind == HANDSHAKE);
    cover(finished && dropped);
`endif
  end
endmodule
