MarcosAsh/protocol-emulator/python/protocol_emulator.py

# SPDX-License-Identifier: Apache-2.0
# Host side of the core over SPI. Works on CPython and MicroPython.

CONTROL = 0x00
STATUS = 0x01
PC = 0x02
NOW_LO = 0x03
NOW_HI = 0x04
CAPTURE_LO = 0x05
CAPTURE_HI = 0x06
TX = 0x07
RX = 0x08
PROGRAM_ADDR = 0x09
PROGRAM = 0x0A
SELECT = 0x0B
DATA_ADDR = 0x0C
DATA = 0x0D
CONFIG = 0x10
CHECK_BASE = 0x40
CHECK_LOADED = 0x41
CHECK_FLAGS = 0x42
CHECK_STATUS = 0x43
REJECT_PC = 0x44
REJECT_REASON = 0x45
LINE_ADDR = 0x46
LINE = 0x47
FRAME_CONTROL = 0x48
FRAME_BASE = 0x49
FRAME_STATUS = 0x4A
USB_STATUS = 0x4B
STAMP_MASK = 0x4C
STAMP_CONTROL = 0x4D
STAMP_TIME_LO = 0x4E
STAMP_TIME_HI = 0x4F
STAMP_PINS_LO = 0x50
STAMP_PINS_HI = 0x51

# the fault bits of the status word: underflow, overflow, missed deadline, bad decode,
# broken assumption
FAULTS = 0x403C
PROGRAM_WORDS = 512
STAMP_DEPTH = 4

# REJECT_REASON's codes: the first conjunct of the kernel's check that fails, in
# Kernel.Conjuncts order, or one of the checker's own. test/python/write_check_reasons.ml
# prints the same names from the OCaml.
_HOLDS = ["phase", "offset", "period", "x", "y", "arm", "captured", "awaiting", "edge_a",
          "edge_b"]
REASONS = dict(enumerate(["in time", "a spaced", "b spaced"] + ["next " + f for f in _HOLDS]
                         + ["target " + f for f in _HOLDS]))
REASONS.update({29: "aborted", 30: "a table entry out of order", 31: "a table entry left over"})


class Refused(Exception):
    """The chip's load check refused the program. args ends with the pc and the reason's
    code, which REASONS names."""

    def __str__(self):
        pc, reason = self.args[-2:]
        return "refused at pc %d: %s" % (pc, REASONS.get(reason, reason))

# Engine.Config order, the nth at CONFIG + n. None is a reserved register, kept so later
# fields stay where existing hosts write them.
CONFIG_FIELDS = [
    "side_set_count", "side_set_base", "side_set_pindirs", "in_base", "in_count", "out_base",
    "out_count", "set_base", "set_count", "jmp_pin", "capture_pin", "capture_rising",
    "in_shift_right", "out_shift_right", "autopush", "push_threshold", "autopull",
    "pull_threshold", "crc_width", "crc_poly", "crc_init", "crc_reflect",
    "stuff_threshold", "stuff_level", "wrap_bottom", "wrap_top", "period_fraction",
    None, None, "autopull_data", "manchester", "line_code", "route", "crc_poly_high",
    "crc_init_high", "crc_complement",
]

DEFAULT_CONFIG = {
    "side_set_base": 5, "in_count": 16, "out_base": 5, "out_count": 1, "set_base": 5, "set_count": 1,
    "in_shift_right": 1, "out_shift_right": 1, "push_threshold": 16, "pull_threshold": 16,
    "crc_width": 16, "crc_poly": 0xA001, "crc_init": 0xFFFF, "crc_reflect": 1,
    "crc_complement": 1, "stuff_level": 1, "wrap_top": 511,
}


def check_writes(base=0, loaded=None, single_edge=False, floor=False):
    """(register, words) that start the chip's check against the certificate at base."""
    flags = (loaded is not None) | (bool(single_edge) << 1) | (bool(floor) << 2)
    return [
        (CHECK_BASE, [base]),
        (CHECK_LOADED, [0 if loaded is None else loaded]),
        (CHECK_FLAGS, [flags]),
        (CONTROL, [0x10]),
    ]


def certify_writes(certificate, base=0, loaded=None, single_edge=False, floor=False):
    """check_writes after writing the certificate at base."""
    return [(DATA_ADDR, [base]), (DATA, list(certificate))] + check_writes(
        base, loaded, single_edge, floor)


def config_writes(config):
    """(register, word) for every config field, 0 for a field config leaves out."""
    return [(CONFIG + n, int(config.get(name, 0))) for n, name in enumerate(CONFIG_FIELDS) if name]


class Host:
    """transfer(data) exchanges one CS-framed list of bytes and returns the replies."""

    def __init__(self, transfer):
        self.transfer = transfer

    def write(self, reg, words):
        data = [0x80 | reg]
        for w in words:
            data += [(w >> 8) & 0xFF, w & 0xFF]
        self.transfer(data)

    def read(self, reg, count=1):
        reply = self.transfer([reg] + [0] * (2 * count))[1:]
        return [(reply[i] << 8) | reply[i + 1] for i in range(0, 2 * count, 2)]

    def select(self, engine):
        """Route every later call to that engine. A chip with one engine ignores this."""
        self.write(SELECT, [engine])

    def configure(self, config):
        """Write the config. A running core ignores it, so halt the core first."""
        for reg, word in config_writes(config):
            self.write(reg, [word])

    def load(self, words, address=0):
        """Zero-fill the memory after the program, since the kernel reads it as zero and
        the SRAM powers up with arbitrary contents."""
        self.write(PROGRAM_ADDR, [address])
        self.write(PROGRAM, list(words) + [0] * (PROGRAM_WORDS - address - len(words)))

    def load_data(self, words, address=0):
        """Write the shared data memory. Words only land while every core is halted."""
        self.write(DATA_ADDR, [address])
        self.write(DATA, words)

    def certify(self, certificate, base=0, loaded=None, single_edge=False, floor=False):
        """Write the selected engine's certificate at base and have the chip check its
        program against it, which a start requires. Every core must be halted for the
        write, and the certification lasts until the program or configuration changes.
        loaded is the period every run-time load of p is assumed to carry (with floor, it
        is the minimum). The core then faults if p or the capture pin breaks what the check
        assumed."""
        self.load_data(certificate, base)
        self.check(base, loaded, single_edge, floor)

    def check(self, base=0, loaded=None, single_edge=False, floor=False, polls=1000):
        """Like certify, but against a certificate the data memory already holds, e.g. after
        a patch while another core runs and no data write can land. Raises OSError if the
        check still reads busy after polls reads, as it does with MISO stuck high."""
        for reg, words in check_writes(base, loaded, single_edge, floor):
            self.write(reg, words)
        # the longest walk (usb_device, 30545 cycles) is under 200 reads at the fastest SCK
        for _ in range(polls):
            status = self.read(CHECK_STATUS)[0]
            if not status & 1:
                break
        else:
            raise OSError("the load check still reads busy")
        if not status & 4:
            raise Refused(self.read(REJECT_PC)[0], self.read(REJECT_REASON)[0])

    def start(self):
        """Run from address 0; ignored unless the core is halted. Only works once the
        program is certified; otherwise the core stays halted and check_status shows the
        refusal."""
        self.write(CONTROL, [1])

    def start_all(self):
        """Start every engine on the same cycle, whatever the select, but only if all are
        halted and certified."""
        self.write(CONTROL, [0x20])

    def load_line_table(self, words):
        """Load the selected engine's line code table, one word per state. Only while
        halted."""
        self.write(LINE_ADDR, [0])
        self.write(LINE, list(words))

    def stop(self):
        """Halt the core, which program writes require. It only resumes from a start, at 0."""
        self.write(CONTROL, [4])

    def flush(self):
        """Empty both fifos; ignored unless the core is halted."""
        self.write(CONTROL, [8])

    def clear_irq(self):
        self.write(CONTROL, [2])

    def push(self, words):
        self.write(TX, words)

    def pop(self, count=1):
        """Pop count words, padding with zeros past rx_level. Reading RX on an empty fifo
        returns 0 and drops any word the engine pushes meanwhile, so we never do that."""
        level = min(count, self.status()["rx_level"])
        return (self.read(RX, level) if level else []) + [0] * (count - level)

    def status(self):
        s = self.read(STATUS)[0]
        return {
            "halted": s & 1, "irq": (s >> 1) & 1, "underflow": (s >> 2) & 1,
            "overflow": (s >> 3) & 1, "missed_deadline": (s >> 4) & 1,
            "decode": (s >> 5) & 1, "tx_level": (s >> 6) & 15, "rx_level": (s >> 10) & 15,
            "assumption": (s >> 14) & 1, "other_irq": (s >> 15) & 1,
        }

    def arm_frame(self, pin, base=0, fifty=True, owner=0):
        """Capture the next 10BASE-T frame on pin into the data memory from base, sampling
        for a 50 MHz clock (else 40 MHz). One frame per arm. Its words land in engine
        owner's data turns, and only that engine reads the status pins 28-31."""
        for reg, words in arm_frame_writes(pin, base, fifty, owner):
            self.write(reg, words)

    def frame_status(self):
        return frame_fields(self.read(FRAME_STATUS)[0])

    def arm_usb(self, dp_pin, base=0, owner=0, rearm=False):
        """Capture the next USB full speed packet into the data memory from base, with D+ on
        dp_pin and D- on the next pin. One packet per arm, or with rearm every packet from
        base in turn. frame_status reports the last one, and its fcs_ok is the CRC-16. Its
        words land in engine owner's data turns, and only that engine reads the status pins
        28-31."""
        self.write(FRAME_BASE, [base])
        self.write(
            FRAME_CONTROL,
            [(owner << 8) | (1 << 7) | (dp_pin << 2) | (int(rearm) << 1) | 1],
        )

    def usb_status(self):
        s = self.read(USB_STATUS)[0]
        return {
            "crc5_ok": s & 1, "crc16_ok": (s >> 1) & 1, "stuff_error": (s >> 2) & 1,
            "aligned": (s >> 3) & 1,
        }

    def watch_edges(self, pins, engine=0):
        """Stamp edges on the pins (a mask of 20) with engine's time, and empty the queue."""
        self.write(STAMP_MASK, [pins & 0xFFFF])
        self.write(STAMP_CONTROL, [(engine << 4) | (pins >> 16)])

    def edge_stamps(self):
        """Pop the stamps queued when called, at most STAMP_DEPTH, as (time, pads), so a pin
        that keeps moving or a stuck MISO can't hold us here. Also returns whether one was
        lost to a full queue."""
        stamps = []
        hi = self.read(STAMP_TIME_HI)[0]
        for _ in range(min((hi >> 8) & 7, STAMP_DEPTH)):
            lo = self.read(STAMP_TIME_LO)[0]
            pins_lo = self.read(STAMP_PINS_LO)[0]
            pins_hi = self.read(STAMP_PINS_HI)[0]  # pops
            stamps.append((((hi & 0xFF) << 16) | lo, (pins_hi << 16) | pins_lo))
            hi = self.read(STAMP_TIME_HI)[0]
        return stamps, bool(hi >> 15)

    def now(self):
        """The two halves arrive in separate frames, so read the high half before and after
        the low half and retry if it moved."""
        hi = self.read(NOW_HI)[0]
        while True:
            lo = self.read(NOW_LO)[0]
            again = self.read(NOW_HI)[0]
            if again == hi:
                return (hi << 16) | lo
            hi = again


def arm_frame_writes(pin, base=0, fifty=True, owner=0):
    """Host.arm_frame's register writes, for a host that can't call it."""
    control = (owner << 8) | (pin << 2) | (int(fifty) << 1) | 1
    return [(FRAME_BASE, [base]), (FRAME_CONTROL, [control])]


def frame_fields(s):
    """FRAME_STATUS's fields."""
    return {
        "words": s & 0x3FF, "finished": (s >> 10) & 1, "fcs_ok": (s >> 11) & 1,
        "half": (s >> 12) & 1, "dropped": (s >> 13) & 1, "receiving": (s >> 14) & 1,
        "armed": (s >> 15) & 1,
    }


def hex_words(text):
    """Parse the assembler's output: one hex word per line."""
    return [int(line, 16) for line in text.split() if line]
