MarcosAsh/protocol-emulator/formal/edge_step.sv

// Edge lemma, on phase_step.sv's cycles; an entry is the first issue after a start or a
// completion. For any program and any config written while halted, pin_out and pin_dir
// only change the cycle after an entry whose word writes them, and then to its writes in
// order: a Manchester second half owed by the word before, side-set, then set, out or mov.
// A held wait reissues the same side-set and moves nothing. The second half shows (the
// out's delay + 1) after the first, whatever the next word is. A start or clear drops it,
// and a stop holds it until then. The only thing assumed of the host is the config's
// halted window (host_spacing.sv). Out and mov data is the core's value at issue;
// value_step.sv proves that value is the ISA's.

// the timer's width, narrower in the narrow tasks
`ifndef TIMER_BITS
`define TIMER_BITS 24
`endif

module edge_step (input clk);
  // The config as the host port holds it. A write only lands while the core is halted and
  // not in a start's second cycle (host_spacing.sv). Free at the clear. Every field is
  // here, in Engine.Config's order, first field highest.
  (* anyseq *) wire config_write;
  (* anyseq *) wire [176:0] config_value;
  reg [176:0] config_bits;
  wire [1:0] side_set_count = config_bits[176:175];
  wire [4:0] side_set_base = config_bits[174:170];
  wire side_set_pindirs = config_bits[169];
  wire [4:0] in_base = config_bits[168:164];
  wire [4:0] in_count = config_bits[163:159];
  wire [4:0] out_base = config_bits[158:154];
  wire [4:0] out_count = config_bits[153:149];
  wire [4:0] set_base = config_bits[148:144];
  wire [2:0] set_count = config_bits[143:141];
  wire [4:0] jmp_pin = config_bits[140:136];
  wire [4:0] capture_pin = config_bits[135:131];
  wire capture_rising = config_bits[130];
  wire in_shift_right = config_bits[129];
  wire out_shift_right = config_bits[128];
  wire autopush = config_bits[127];
  wire [4:0] push_threshold = config_bits[126:122];
  wire autopull = config_bits[121];
  wire [4:0] pull_threshold = config_bits[120:116];
  wire [5:0] crc_width = config_bits[115:110];
  wire [15:0] crc_poly = config_bits[109:94];
  wire [15:0] crc_init = config_bits[93:78];
  wire crc_reflect = config_bits[77];
  wire [4:0] stuff_threshold = config_bits[76:72];
  wire stuff_level = config_bits[71];
  wire [8:0] wrap_bottom = config_bits[70:62];
  wire [8:0] wrap_top = config_bits[61:53];
  wire [15:0] period_fraction = config_bits[52:37];
  wire autopull_data = config_bits[36];
  wire manchester = config_bits[35];
  wire line_code = config_bits[34];
  wire [15:0] crc_poly_high = config_bits[32:17];
  wire [15:0] crc_init_high = config_bits[16:1];
  wire crc_complement = config_bits[0];
  (* anyseq *) wire [15:0] data_word;
  (* anyseq *) wire stop, flush;
  (* anyseq *) wire start, program_write_valid, tx_valid, rx_pop, clear_irq;
  (* anyseq *) wire [8:0] program_write_addr;
  (* anyseq *) wire [15:0] program_write_data, tx_value;
  (* anyseq *) wire [31:0] inputs;

  // the top clears the engine at power-on and whenever reset comes again
  (* anyseq *) wire reset;
  reg clear = 1;
  always @(posedge clk) clear <= reset;

  wire [31:0] pin_out, pin_dir;
  wire [8:0] pc;
  wire [15:0] x, y, p, osr, isr, rx_head, instruction;
  wire [31:0] crc;
  wire crc_sending;
  wire [`TIMER_BITS-1:0] t, now, capture;
  wire [4:0] osr_count, isr_count, stall, stuff_run;
  wire halted, irq, underflow, overflow, missed_deadline, decode, capture_armed;
  wire flip_pending, flip_bit;
  wire [3:0] tx_level, rx_level;
  wire decode_ok;
  wire [7:0] opcode_onehot;
  wire [31:0] wait_select;
  wire jmp_go, advance;
  wire [15:0] out_value, mov_value;
  wire line_level;

  engine dut (
    .clock(clk), .clear(clear),
    .config$side_set_count(side_set_count), .config$side_set_base(side_set_base),
    .config$side_set_pindirs(side_set_pindirs), .config$in_base(in_base),
    .config$in_count(in_count), .config$out_base(out_base), .config$out_count(out_count),
    .config$set_base(set_base), .config$set_count(set_count), .config$jmp_pin(jmp_pin), .config$capture_pin(capture_pin),
    .config$capture_rising(capture_rising), .config$in_shift_right(in_shift_right),
    .config$out_shift_right(out_shift_right), .config$autopush(autopush),
    .config$push_threshold(push_threshold), .config$autopull(autopull),
    .config$pull_threshold(pull_threshold),
    .config$crc_width(crc_width), .config$crc_poly(crc_poly), .config$crc_init(crc_init),
    .config$crc_reflect(crc_reflect), .config$stuff_threshold(stuff_threshold),
    .config$stuff_level(stuff_level),
    .config$wrap_bottom(wrap_bottom), .config$wrap_top(wrap_top),
    .config$period_fraction(period_fraction),
    .config$autopull_data(autopull_data), .config$manchester(manchester),
    .config$line_code(line_code),
    .config$crc_poly_high(crc_poly_high), .config$crc_init_high(crc_init_high),
    .config$crc_complement(crc_complement),
    .stop(stop), .flush(flush),
    .start(start), .program_write$valid(program_write_valid),
    .program_write$addr(program_write_addr), .program_write$data(program_write_data),
    .data_word(data_word),
    .tx$valid(tx_valid), .tx$value(tx_value), .rx_pop(rx_pop), .clear_irq(clear_irq),
    .inputs(inputs),
    .pin_out(pin_out), .pin_dir(pin_dir), .pc(pc), .x(x), .y(y), .p(p), .t(t), .osr(osr),
    .osr_count(osr_count), .isr(isr), .isr_count(isr_count), .now(now), .stall(stall),
    .halted(halted), .irq(irq), .fault$underflow(underflow), .fault$overflow(overflow),
    .fault$missed_deadline(missed_deadline), .fault$decode(decode), .capture(capture),
    .capture_armed(capture_armed), .tx_level(tx_level), .rx_level(rx_level),
    .rx_head(rx_head), .instruction(instruction), .crc(crc), .crc_sending(crc_sending), .stuff_run(stuff_run),
    .decode_ok(decode_ok), .opcode_onehot(opcode_onehot), .wait_select(wait_select),
    .flip_pending(flip_pending), .flip_bit(flip_bit),
    .eng_jmp_go(jmp_go), .eng_advance(advance), .eng_out_value(out_value),
    .eng_mov_value(mov_value), .eng_line_level(line_level));
  // an instruction completes when a jump issues, or when anything else issues and goes on
  wire completes = jmp_go || advance;

  // an entry, as in phase_step.sv, after a start (which the core only takes while halted)
  wire start_taken = start && halted;
  reg started = 0;
  always @(posedge clk) started <= start_taken;
  always @(posedge clk)
    if (config_write && halted && !started) config_bits <= config_value;
  wire issue = !clear && !halted && stall == 0 && !started;
  reg fresh = 0;
  always @(posedge clk)
    if (clear || start_taken || completes) fresh <= 1;
    else if (issue) fresh <= 0;
  wire entry = issue && fresh;

  // the pin writers; a jump or an undecoded word writes nothing itself
  wire [2:0] opcode = instruction[15:13];
  wire [2:0] dest = instruction[7:5];
  wire [4:0] count = instruction[4:0];
  wire runs = decode_ok && opcode != 0;
  wire side_pins = runs && side_set_count != 0 && !side_set_pindirs;
  wire side_dirs = runs && side_set_count != 0 && side_set_pindirs;
  wire set_pins = runs && opcode == 5 && dest == 0;
  wire set_dirs = runs && opcode == 5 && dest == 3;
  wire out_pins = runs && opcode == 3 && dest == 0;
  wire out_dirs = runs && opcode == 3 && dest == 4;
  wire mov_pins = runs && opcode == 4 && dest == 0;
  wire mov_dirs = runs && opcode == 4 && dest == 3;
  wire manchester_bit = out_pins && manchester && count == 1;
  // a line-coded out drives the table's level, and its complement on the pin above
  wire line_bit = out_pins && line_code && !manchester && count == 1;
  wire writes_out = side_pins || set_pins || out_pins || mov_pins;
  wire writes_dir = side_dirs || set_dirs || out_dirs || mov_dirs;

  // a Manchester second half, owed from the out's entry to the next entry
  reg flip_owed = 0;
  always @(posedge clk)
    if (clear || started) flip_owed <= 0;
    else if (entry) flip_owed <= manchester_bit;
  // and the cycles since, next to the out's step (its delay plus one)
  wire [4:0] ds = instruction[12:8];
  wire [4:0] delay = side_set_count == 0 ? ds : side_set_count == 1 ? ds[3:0] : ds[2:0];
  reg [5:0] since_out = 0, out_step = 0;
  always @(posedge clk)
    if (entry && manchester_bit) begin
      since_out <= 1;
      out_step <= delay + 6'd1;
    end else if (since_out != 63) since_out <= since_out + 6'd1;

  // Pins.write: the low [n] bits of [v] from [base] up, wrapping at 32, on the pins that
  // take them (5 to 27 drive, 12 to 19 turn around)
  localparam [31:0] OUTPUTS = 32'h0fffffe0;
  localparam [31:0] BIDIRS = 32'h000ff000;
  function [31:0] place(input [15:0] v, input [4:0] base);
    reg [63:0] twice;
    begin
      twice = {16'd0, v, 16'd0, v} << base;
      place = twice[63:32];
    end
  endfunction
  function [15:0] mask(input [4:0] n);
    mask = n >= 16 ? 16'hffff : (16'd1 << n) - 16'd1;
  endfunction
  function [31:0] write
    (input [31:0] old, input [4:0] base, input [4:0] n, input [15:0] v, input [31:0] takes);
    reg [31:0] hit;
    begin
      hit = place(mask(n), base) & takes;
      write = old & ~hit | place(v, base) & hit;
    end
  endfunction

  wire [15:0] side_value =
    side_set_count == 1 ? {15'd0, instruction[12]} : {14'd0, instruction[12:11]};
  wire [15:0] set_value = {11'd0, count};
  // a Manchester out drives its bit on the pin above out_base and the complement on it
  wire [15:0] first_half = {14'd0, out_value[0], !out_value[0]};
  wire [31:0] pair = place(16'd3, out_base) & OUTPUTS;
  wire [15:0] line_pair = {14'd0, !line_level, line_level};
  wire [4:0] line_count = out_count >= 2 ? 5'd2 : out_count;

  // the pins the cycle after an entry
`ifdef NO_FLIP
  wire [31:0] flipped = pin_out;
`else
  wire [31:0] flipped = flip_owed ? pin_out ^ pair : pin_out;
`endif
  wire [31:0] sided_out =
      side_pins ? write(flipped, side_set_base, side_set_count, side_value, OUTPUTS)
    : flipped;
  wire [31:0] want_out =
      set_pins ? write(sided_out, set_base, set_count, set_value, OUTPUTS)
    : manchester_bit ? write(sided_out, out_base, 5'd2, first_half, OUTPUTS)
    : line_bit ? write(sided_out, out_base, line_count, line_pair, OUTPUTS)
    : out_pins ? write(sided_out, out_base, count, out_value, OUTPUTS)
    : mov_pins ? write(sided_out, out_base, out_count, mov_value, OUTPUTS)
    : sided_out;
  wire [31:0] sided_dir =
      side_dirs ? write(pin_dir, side_set_base, side_set_count, side_value, BIDIRS)
    : pin_dir;
  wire [31:0] want_dir =
      set_dirs ? write(sided_dir, set_base, set_count, set_value, BIDIRS)
    : out_dirs ? write(sided_dir, out_base, count, out_value, BIDIRS)
    : mov_dirs ? write(sided_dir, out_base, out_count, mov_value, BIDIRS)
    : sided_dir;

  reg last_clear = 1, last_entry = 0, last_flip_owed = 0;
  reg last_writes_out, last_writes_dir, last_side_pins, last_side_dirs;
  reg last_set_pins, last_set_dirs, last_out_pins, last_out_dirs;
  reg last_mov_pins, last_mov_dirs, last_manchester_bit;
  reg [31:0] last_out, last_dir, last_want_out, last_want_dir;
  always @(posedge clk) begin
    last_clear <= clear;
    last_entry <= entry;
    last_flip_owed <= flip_owed;
    last_writes_out <= writes_out;
    last_writes_dir <= writes_dir;
    last_side_pins <= side_pins;
    last_side_dirs <= side_dirs;
    last_set_pins <= set_pins;
    last_set_dirs <= set_dirs;
    last_out_pins <= out_pins;
    last_out_dirs <= out_dirs;
    last_mov_pins <= mov_pins;
    last_mov_dirs <= mov_dirs;
    last_manchester_bit <= manchester_bit;
    last_out <= pin_out;
    last_dir <= pin_dir;
    last_want_out <= want_out;
    last_want_dir <= want_dir;
  end

  // the entry whose writes the pins show now; each teeth task gets one part wrong
`ifdef ONE_CYCLE_LATER
  reg shown_entry = 0, shown_flip_owed = 0, shown_writes_out, shown_writes_dir;
  reg [31:0] shown_want_out, shown_want_dir;
  always @(posedge clk) begin
    shown_entry <= last_entry;
    shown_flip_owed <= last_flip_owed;
    shown_writes_out <= last_writes_out;
    shown_writes_dir <= last_writes_dir;
    shown_want_out <= last_want_out;
    shown_want_dir <= last_want_dir;
  end
`else
  wire shown_entry = last_entry, shown_flip_owed = last_flip_owed;
  wire shown_writes_out = last_writes_out, shown_writes_dir = last_writes_dir;
  wire [31:0] shown_want_out = last_want_out, shown_want_dir = last_want_dir;
`endif
`ifdef PINS_NEVER_CHANGE
  wire moves_out = 0;
  wire moves_dir = 0;
`elsif SIDE_SET_ONLY
  wire moves_out = shown_entry && last_side_pins;
  wire moves_dir = shown_entry && last_side_dirs;
`elsif NO_FLIP
  wire moves_out = shown_entry && shown_writes_out;
  wire moves_dir = shown_entry && shown_writes_dir;
`else
  wire moves_out = shown_entry && (shown_writes_out || shown_flip_owed);
  wire moves_dir = shown_entry && shown_writes_dir;
`endif

  // the lemma
  always @(posedge clk)
    if (!clear) begin
      if (last_clear) assert(pin_out == 0 && pin_dir == 0);
      else begin
        // when
        if (!moves_out) assert(pin_out == last_out);
        if (!moves_dir) assert(pin_dir == last_dir);
        // what
        if (shown_entry) assert(pin_out == shown_want_out && pin_dir == shown_want_dir);
      end
      // the second half comes one step of the out after the first
      if (entry && flip_owed) assert(since_out == out_step);
    end
`ifdef FLIP_OFF_ISSUE
  // teeth: the second half arrives by the clock, whether or not the core issues then
  reg [5:0] last_since_out = 0, last_out_step = 0;
  always @(posedge clk) begin
    last_since_out <= since_out;
    last_out_step <= out_step;
  end
  always @(posedge clk)
    if (!clear && !last_clear && last_flip_owed && last_since_out == last_out_step
        && pair != 0 && !(last_entry && last_writes_out))
      assert((pin_out & pair) == ((last_out & pair) ^ pair));
`endif

  // invariants for induction
  wire [31:0] first_half_held = place({14'd0, flip_bit, !flip_bit}, out_base) & OUTPUTS;
  always @(posedge clk)
    if (!clear) begin
      assert(opcode_onehot == 8'b1 << opcode);
      assert(flip_pending == flip_owed);
      // a stop can leave the half owed, and the start drops it before the next entry
      if (flip_owed && !halted) begin
        assert((pin_out & pair) == first_half_held);
        assert(since_out <= out_step && stall == out_step - since_out);
      end
      if (!fresh && !halted) begin
        assert(opcode == 1 && decode_ok && stall == 0 && !started);
        if (side_pins) assert(sided_out == pin_out);
        if (side_dirs) assert(sided_dir == pin_dir);
      end
    end

  // each writer moves a pin on its own, so no part of the lemma is vacuous
  wire flipless = !last_flip_owed;
  wire moved_out = pin_out != last_out;
  wire moved_dir = pin_dir != last_dir;
  always @(posedge clk)
    if (!clear && !last_clear && last_entry) begin
      cover(last_set_pins && !last_side_pins && flipless && moved_out);
      cover(last_set_dirs && !last_side_dirs && moved_dir);
      cover(last_out_pins && !last_manchester_bit && !last_side_pins && flipless
            && moved_out);
      cover(last_manchester_bit && !last_side_pins && flipless && moved_out);
      cover(last_out_dirs && !last_side_dirs && moved_dir);
      cover(last_mov_pins && !last_side_pins && flipless && moved_out);
      cover(last_mov_dirs && !last_side_dirs && moved_dir);
      cover(last_side_pins && !last_set_pins && !last_out_pins && !last_mov_pins && flipless
            && moved_out);
      cover(last_side_dirs && !last_set_dirs && !last_out_dirs && !last_mov_dirs
            && moved_dir);
      // the second half, at the entry of a word that writes no pins
      cover(last_flip_owed && !last_writes_out && moved_out);
    end
  // the second half after an out with a delay
  always @(posedge clk) cover(entry && flip_owed && out_step >= 3);
  // and a wait that holds does issue again, driving its side-set
  always @(posedge clk) cover(issue && !entry && (side_pins || side_dirs));
endmodule
