MarcosAsh/protocol-emulator/python/bench_firmware.py

# Written by test/python/write_bench_firmware.ml; `dune promote` after a change.
# The outside chip demos' firmware as words and the configuration it runs under,
# at the bench's 48 MHz but for 10BASE-T's 40.

# Uart.tx_host_rate: the host sends the bit period, 5000 cycles for 9.6 kbaud, on OUT0
UART_TX_9600 = {
    "config": {
        "side_set_count": 0,
        "side_set_base": 5,
        "side_set_pindirs": 0,
        "in_base": 0,
        "in_count": 16,
        "out_base": 5,
        "out_count": 1,
        "set_base": 5,
        "set_count": 1,
        "jmp_pin": 0,
        "capture_pin": 0,
        "capture_rising": 1,
        "in_shift_right": 1,
        "out_shift_right": 1,
        "autopush": 0,
        "push_threshold": 16,
        "autopull": 0,
        "pull_threshold": 16,
        "crc_width": 16,
        "crc_poly": 40961,
        "crc_init": 65535,
        "crc_reflect": 1,
        "stuff_threshold": 0,
        "stuff_level": 1,
        "wrap_bottom": 0,
        "wrap_top": 511,
        "period_fraction": 0,
        "autopull_data": 0,
        "manchester": 0,
        "line_code": 0,
        "route": 0,
        "crc_poly_high": 0,
        "crc_init_high": 0,
        "crc_complement": 1,
    },
    "words": [
        0x20E0, 0xE004, 0x80C5, 0xA001, 0x20E0, 0xE004, 0xA027, 0x80E6,
        0xA000, 0xC0CA, 0x20C0, 0x6001, 0x020A, 0x20C0, 0xA001, 0x2040,
        0x0004,
    ],
    "certificate": [
        0x0002, 0x0001, 0x0200, 0x0001, 0x0000, 0x0500, 0x4001, 0x0400,
        0xFF00, 0x0400, 0x0000, 0x0004, 0xFFFF, 0x0000, 0x0007,
    ],
    "loaded": 4,
    "floor": 1,
    "single_edge": 0,
}

# Uart.tx_host_rate: the host sends the bit period, 2500 cycles for 19.2 kbaud, on OUT0
UART_TX_19200 = {
    "config": {
        "side_set_count": 0,
        "side_set_base": 5,
        "side_set_pindirs": 0,
        "in_base": 0,
        "in_count": 16,
        "out_base": 5,
        "out_count": 1,
        "set_base": 5,
        "set_count": 1,
        "jmp_pin": 0,
        "capture_pin": 0,
        "capture_rising": 1,
        "in_shift_right": 1,
        "out_shift_right": 1,
        "autopush": 0,
        "push_threshold": 16,
        "autopull": 0,
        "pull_threshold": 16,
        "crc_width": 16,
        "crc_poly": 40961,
        "crc_init": 65535,
        "crc_reflect": 1,
        "stuff_threshold": 0,
        "stuff_level": 1,
        "wrap_bottom": 0,
        "wrap_top": 511,
        "period_fraction": 0,
        "autopull_data": 0,
        "manchester": 0,
        "line_code": 0,
        "route": 0,
        "crc_poly_high": 0,
        "crc_init_high": 0,
        "crc_complement": 1,
    },
    "words": [
        0x20E0, 0xE004, 0x80C5, 0xA001, 0x20E0, 0xE004, 0xA027, 0x80E6,
        0xA000, 0xC0CA, 0x20C0, 0x6001, 0x020A, 0x20C0, 0xA001, 0x2040,
        0x0004,
    ],
    "certificate": [
        0x0002, 0x0001, 0x0200, 0x0001, 0x0000, 0x0500, 0x4001, 0x0400,
        0xFF00, 0x0400, 0x0000, 0x0004, 0xFFFF, 0x0000, 0x0007,
    ],
    "loaded": 4,
    "floor": 1,
    "single_edge": 0,
}

# Uart.tx_host_rate: the host sends the bit period, 1250 cycles for 38.4 kbaud, on OUT0
UART_TX_38400 = {
    "config": {
        "side_set_count": 0,
        "side_set_base": 5,
        "side_set_pindirs": 0,
        "in_base": 0,
        "in_count": 16,
        "out_base": 5,
        "out_count": 1,
        "set_base": 5,
        "set_count": 1,
        "jmp_pin": 0,
        "capture_pin": 0,
        "capture_rising": 1,
        "in_shift_right": 1,
        "out_shift_right": 1,
        "autopush": 0,
        "push_threshold": 16,
        "autopull": 0,
        "pull_threshold": 16,
        "crc_width": 16,
        "crc_poly": 40961,
        "crc_init": 65535,
        "crc_reflect": 1,
        "stuff_threshold": 0,
        "stuff_level": 1,
        "wrap_bottom": 0,
        "wrap_top": 511,
        "period_fraction": 0,
        "autopull_data": 0,
        "manchester": 0,
        "line_code": 0,
        "route": 0,
        "crc_poly_high": 0,
        "crc_init_high": 0,
        "crc_complement": 1,
    },
    "words": [
        0x20E0, 0xE004, 0x80C5, 0xA001, 0x20E0, 0xE004, 0xA027, 0x80E6,
        0xA000, 0xC0CA, 0x20C0, 0x6001, 0x020A, 0x20C0, 0xA001, 0x2040,
        0x0004,
    ],
    "certificate": [
        0x0002, 0x0001, 0x0200, 0x0001, 0x0000, 0x0500, 0x4001, 0x0400,
        0xFF00, 0x0400, 0x0000, 0x0004, 0xFFFF, 0x0000, 0x0007,
    ],
    "loaded": 4,
    "floor": 1,
    "single_edge": 0,
}

# Uart.tx_host_rate: the host sends the bit period, 833 cycles for 57.62 kbaud, on OUT0
UART_TX_57600 = {
    "config": {
        "side_set_count": 0,
        "side_set_base": 5,
        "side_set_pindirs": 0,
        "in_base": 0,
        "in_count": 16,
        "out_base": 5,
        "out_count": 1,
        "set_base": 5,
        "set_count": 1,
        "jmp_pin": 0,
        "capture_pin": 0,
        "capture_rising": 1,
        "in_shift_right": 1,
        "out_shift_right": 1,
        "autopush": 0,
        "push_threshold": 16,
        "autopull": 0,
        "pull_threshold": 16,
        "crc_width": 16,
        "crc_poly": 40961,
        "crc_init": 65535,
        "crc_reflect": 1,
        "stuff_threshold": 0,
        "stuff_level": 1,
        "wrap_bottom": 0,
        "wrap_top": 511,
        "period_fraction": 0,
        "autopull_data": 0,
        "manchester": 0,
        "line_code": 0,
        "route": 0,
        "crc_poly_high": 0,
        "crc_init_high": 0,
        "crc_complement": 1,
    },
    "words": [
        0x20E0, 0xE004, 0x80C5, 0xA001, 0x20E0, 0xE004, 0xA027, 0x80E6,
        0xA000, 0xC0CA, 0x20C0, 0x6001, 0x020A, 0x20C0, 0xA001, 0x2040,
        0x0004,
    ],
    "certificate": [
        0x0002, 0x0001, 0x0200, 0x0001, 0x0000, 0x0500, 0x4001, 0x0400,
        0xFF00, 0x0400, 0x0000, 0x0004, 0xFFFF, 0x0000, 0x0007,
    ],
    "loaded": 4,
    "floor": 1,
    "single_edge": 0,
}

# Uart.tx_host_rate: the host sends the bit period, 417 cycles for 115.1 kbaud, on OUT0
UART_TX_115200 = {
    "config": {
        "side_set_count": 0,
        "side_set_base": 5,
        "side_set_pindirs": 0,
        "in_base": 0,
        "in_count": 16,
        "out_base": 5,
        "out_count": 1,
        "set_base": 5,
        "set_count": 1,
        "jmp_pin": 0,
        "capture_pin": 0,
        "capture_rising": 1,
        "in_shift_right": 1,
        "out_shift_right": 1,
        "autopush": 0,
        "push_threshold": 16,
        "autopull": 0,
        "pull_threshold": 16,
        "crc_width": 16,
        "crc_poly": 40961,
        "crc_init": 65535,
        "crc_reflect": 1,
        "stuff_threshold": 0,
        "stuff_level": 1,
        "wrap_bottom": 0,
        "wrap_top": 511,
        "period_fraction": 0,
        "autopull_data": 0,
        "manchester": 0,
        "line_code": 0,
        "route": 0,
        "crc_poly_high": 0,
        "crc_init_high": 0,
        "crc_complement": 1,
    },
    "words": [
        0x20E0, 0xE004, 0x80C5, 0xA001, 0x20E0, 0xE004, 0xA027, 0x80E6,
        0xA000, 0xC0CA, 0x20C0, 0x6001, 0x020A, 0x20C0, 0xA001, 0x2040,
        0x0004,
    ],
    "certificate": [
        0x0002, 0x0001, 0x0200, 0x0001, 0x0000, 0x0500, 0x4001, 0x0400,
        0xFF00, 0x0400, 0x0000, 0x0004, 0xFFFF, 0x0000, 0x0007,
    ],
    "loaded": 4,
    "floor": 1,
    "single_edge": 0,
}

# Uart.tx_host_rate: the host sends the bit period, 208 cycles for 230.8 kbaud, on OUT0
UART_TX_230400 = {
    "config": {
        "side_set_count": 0,
        "side_set_base": 5,
        "side_set_pindirs": 0,
        "in_base": 0,
        "in_count": 16,
        "out_base": 5,
        "out_count": 1,
        "set_base": 5,
        "set_count": 1,
        "jmp_pin": 0,
        "capture_pin": 0,
        "capture_rising": 1,
        "in_shift_right": 1,
        "out_shift_right": 1,
        "autopush": 0,
        "push_threshold": 16,
        "autopull": 0,
        "pull_threshold": 16,
        "crc_width": 16,
        "crc_poly": 40961,
        "crc_init": 65535,
        "crc_reflect": 1,
        "stuff_threshold": 0,
        "stuff_level": 1,
        "wrap_bottom": 0,
        "wrap_top": 511,
        "period_fraction": 0,
        "autopull_data": 0,
        "manchester": 0,
        "line_code": 0,
        "route": 0,
        "crc_poly_high": 0,
        "crc_init_high": 0,
        "crc_complement": 1,
    },
    "words": [
        0x20E0, 0xE004, 0x80C5, 0xA001, 0x20E0, 0xE004, 0xA027, 0x80E6,
        0xA000, 0xC0CA, 0x20C0, 0x6001, 0x020A, 0x20C0, 0xA001, 0x2040,
        0x0004,
    ],
    "certificate": [
        0x0002, 0x0001, 0x0200, 0x0001, 0x0000, 0x0500, 0x4001, 0x0400,
        0xFF00, 0x0400, 0x0000, 0x0004, 0xFFFF, 0x0000, 0x0007,
    ],
    "loaded": 4,
    "floor": 1,
    "single_edge": 0,
}

# I2c.master_host_rate: the host sends the quarter, 48 cycles for 250 kHz, SCL on IO2, SDA on IO3
I2C_MASTER = {
    "config": {
        "side_set_count": 1,
        "side_set_base": 14,
        "side_set_pindirs": 1,
        "in_base": 15,
        "in_count": 16,
        "out_base": 15,
        "out_count": 1,
        "set_base": 15,
        "set_count": 1,
        "jmp_pin": 15,
        "capture_pin": 0,
        "capture_rising": 1,
        "in_shift_right": 0,
        "out_shift_right": 0,
        "autopush": 0,
        "push_threshold": 16,
        "autopull": 0,
        "pull_threshold": 16,
        "crc_width": 16,
        "crc_poly": 40961,
        "crc_init": 65535,
        "crc_reflect": 1,
        "stuff_threshold": 0,
        "stuff_level": 1,
        "wrap_bottom": 0,
        "wrap_top": 511,
        "period_fraction": 0,
        "autopull_data": 0,
        "manchester": 0,
        "line_code": 0,
        "route": 0,
        "crc_poly_high": 0,
        "crc_init_high": 0,
        "crc_complement": 1,
    },
    "words": [
        0x20E0, 0xE004, 0x80C5, 0xA028, 0x80E6, 0xC0CA, 0x080E, 0x20C0,
        0xF000, 0x30C0, 0x30C0, 0xE000, 0x20C0, 0x0206, 0x20C0, 0xA061,
        0x20C0, 0xF000, 0x005D, 0x20E0, 0xE004, 0x80E6, 0xC0CA, 0xC0CA,
        0x6021, 0x0223, 0x0031, 0x30E0, 0xF004, 0x90E6, 0xD0CA, 0xD0CA,
        0x7021, 0x0229, 0x0031, 0x20C0, 0xA061, 0x20C0, 0xF000, 0xD0CA,
        0x0031, 0xB060, 0x30C0, 0xE000, 0x20C0, 0xA061, 0x20C0, 0xF000,
        0xD0CA, 0x7041, 0xB027, 0x0447, 0x30C0, 0x7041, 0x906A, 0x30C0,
        0xE000, 0x20C0, 0x20C0, 0xF000, 0x0234, 0x30C0, 0xB060, 0x30C0,
        0xE000, 0x20C0, 0x4001, 0x20C0, 0xF000, 0x7021, 0x005A, 0xB060,
        0x30C0, 0x30C0, 0xE000, 0x20C0, 0x4001, 0x20C0, 0xF000, 0x0248,
        0x7068, 0x7021, 0x30C0, 0x9069, 0x30C0, 0xE000, 0x20C0, 0x20C0,
        0xF000, 0xB060, 0xF003, 0x025D, 0x001B, 0x30C0, 0xB061, 0x30C0,
        0xE000, 0x20C0, 0xA060, 0x20C0, 0x0013,
    ],
    "certificate": [
        0x000C, 0x000A, 0x0300, 0x4002, 0x0200, 0x0700, 0x8002, 0x0000,
        0x0980, 0xC002, 0x0000, 0x0D81, 0x0002, 0x0600, 0x1181, 0x4002,
        0x0000, 0x1481, 0x4002, 0x0000, 0x1881, 0x8002, 0x0000, 0x1A01,
        0xC002, 0x0800, 0x2382, 0x0002, 0x0C14, 0x2402, 0x4002, 0x0814,
        0x2D00, 0x8002, 0x0000, 0x2E82, 0x8002, 0x0000, 0xFF00, 0x03FF,
        0xFFE4, 0xFF00, 0x04FF, 0xFFE6, 0xFF00, 0x04FF, 0xFFE4, 0xFF00,
        0x09FF, 0xFFEB, 0xFE00, 0x08FF, 0xFFC8, 0xFE00, 0x05FF, 0xFFCA,
        0xFE00, 0x09FF, 0xFFE5, 0xFE00, 0x09FF, 0xFFCE, 0xFE00, 0x0AFF,
        0xFFE5, 0xFF00, 0x05FF, 0xFFE9, 0x0000, 0x0008, 0x001F, 0xFFFF,
        0xFFFF, 0xFFFF, 0x0000, 0x0007, 0x0000, 0xFFFE, 0x0007, 0x0007,
    ],
    "loaded": 31,
    "floor": 1,
    "single_edge": 0,
}

# I2c.master_stretch_host_rate: I2c.master waiting on SCL, SCL on IO2, SDA on IO3
I2C_MASTER_STRETCH = {
    "config": {
        "side_set_count": 1,
        "side_set_base": 14,
        "side_set_pindirs": 1,
        "in_base": 15,
        "in_count": 1,
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
        0xFFD0, 0xFE00, 0x0AFF, 0xFFE5, 0xFF00, 0x04FF, 0xFFE6, 0xFF00,
        0x07FF, 0xFFE9, 0x0000, 0x0008, 0x001F, 0xFFFF, 0xFFFF, 0xFFFF,
        0x0000, 0x0007, 0x0000, 0xFFFE, 0x0007, 0x0007,
    ],
    "loaded": 31,
    "floor": 1,
    "single_edge": 0,
}

# I2c.start_hold for engine 1: each START's hold in cycles, SCL on IO2, SDA on IO3, both only listened to
START_HOLD = {
    "config": {
        "side_set_count": 0,
        "side_set_base": 5,
        "side_set_pindirs": 0,
        "in_base": 0,
        "in_count": 16,
        "out_base": 5,
        "out_count": 1,
        "set_base": 5,
        "set_count": 1,
        "jmp_pin": 14,
        "capture_pin": 0,
        "capture_rising": 1,
        "in_shift_right": 1,
        "out_shift_right": 1,
        "autopush": 1,
        "push_threshold": 16,
        "autopull": 0,
        "pull_threshold": 16,
        "crc_width": 16,
        "crc_poly": 40961,
        "crc_init": 65535,
        "crc_reflect": 1,
        "stuff_threshold": 0,
        "stuff_level": 1,
        "wrap_bottom": 0,
        "wrap_top": 511,
        "period_fraction": 0,
        "autopull_data": 0,
        "manchester": 0,
        "line_code": 0,
        "route": 0,
        "crc_poly_high": 0,
        "crc_init_high": 0,
        "crc_complement": 1,
    },
    "words": [
        0x202F, 0x8026, 0x0A00, 0x200E, 0x8046, 0x1600, 0xC058, 0x4050,
        0x0000,
    ],
    "certificate": [
        0x0000, 0x0000,
    ],
    "loaded": None,
    "floor": 0,
    "single_edge": 0,
}

# I2c.master_host_rate_held ~quarters:3: the host sends the quarter, 121 cycles for 99.17 kHz, SCL on IO2, SDA on IO3
I2C_STANDARD = {
    "config": {
        "side_set_count": 1,
        "side_set_base": 14,
        "side_set_pindirs": 1,
        "in_base": 15,
        "in_count": 16,
        "out_base": 15,
        "out_count": 1,
        "set_base": 15,
        "set_count": 1,
        "jmp_pin": 15,
        "capture_pin": 0,
        "capture_rising": 1,
        "in_shift_right": 0,
        "out_shift_right": 0,
        "autopush": 0,
        "push_threshold": 16,
        "autopull": 0,
        "pull_threshold": 16,
        "crc_width": 16,
        "crc_poly": 40961,
        "crc_init": 65535,
        "crc_reflect": 1,
        "stuff_threshold": 0,
        "stuff_level": 1,
        "wrap_bottom": 0,
        "wrap_top": 511,
        "period_fraction": 0,
        "autopull_data": 0,
        "manchester": 0,
        "line_code": 0,
        "route": 0,
        "crc_poly_high": 0,
        "crc_init_high": 0,
        "crc_complement": 1,
    },
    "words": [
        0x20E0, 0xE004, 0x80C5, 0xA028, 0x80E6, 0xC0CA, 0x080E, 0x20C0,
        0xF000, 0x30C0, 0x30C0, 0xE000, 0x20C0, 0x0206, 0x20C0, 0x20C0,
        0x20C0, 0xA061, 0x20C0, 0x20C0, 0x20C0, 0xF000, 0x0067, 0x20E0,
        0xE004, 0x80E6, 0xC0CA, 0xC0CA, 0x6021, 0x0227, 0x003B, 0x30E0,
        0xF004, 0x90E6, 0xD0CA, 0xD0CA, 0x7021, 0x022F, 0x003B, 0x20C0,
        0xA061, 0x20C0, 0x20C0, 0x20C0, 0xF000, 0xD0CA, 0x003B, 0xB060,
        0x30C0, 0xE000, 0x20C0, 0x20C0, 0x20C0, 0xA061, 0x20C0, 0x20C0,
        0x20C0, 0xF000, 0xD0CA, 0x7041, 0xB027, 0x0451, 0x30C0, 0x7041,
        0x906A, 0x30C0, 0xE000, 0x20C0, 0x20C0, 0xF000, 0x023E, 0x30C0,
        0xB060, 0x30C0, 0xE000, 0x20C0, 0x4001, 0x20C0, 0xF000, 0x7021,
        0x0064, 0xB060, 0x30C0, 0x30C0, 0xE000, 0x20C0, 0x4001, 0x20C0,
        0xF000, 0x0252, 0x7068, 0x7021, 0x30C0, 0x9069, 0x30C0, 0xE000,
        0x20C0, 0x20C0, 0xF000, 0xB060, 0xF003, 0x0267, 0x001F, 0x30C0,
        0xB061, 0x30C0, 0xE000, 0x20C0, 0x20C0, 0x20C0, 0xA060, 0x20C0,
        0x0017,
    ],
    "certificate": [
        0x000C, 0x000A, 0x0300, 0x4002, 0x0200, 0x0700, 0x8002, 0x0000,
        0x0B80, 0xC002, 0x0000, 0x0F81, 0x0002, 0x0600, 0x1381, 0x4002,
        0x0000, 0x1781, 0x4002, 0x0000, 0x1D81, 0x8002, 0x0000, 0x1F01,
        0xC002, 0x0800, 0x2882, 0x0002, 0x0C14, 0x2902, 0x4002, 0x0814,
        0x3200, 0x8002, 0x0000, 0x3382, 0x8002, 0x0000, 0xFF00, 0x03FF,
        0xFFE4, 0xFF00, 0x04FF, 0xFFE6, 0xFF00, 0x04FF, 0xFFE4, 0xFF00,
        0x09FF, 0xFFEB, 0xFE00, 0x08FF, 0xFFC8, 0xFE00, 0x05FF, 0xFFCA,
        0xFE00, 0x09FF, 0xFFE5, 0xFE00, 0x09FF, 0xFFCE, 0xFE00, 0x0AFF,
        0xFFE5, 0xFF00, 0x05FF, 0xFFE9, 0x0000, 0x0008, 0x001F, 0xFFFF,
        0xFFFF, 0xFFFF, 0x0000, 0x0007, 0x0000, 0xFFFE, 0x0007, 0x0007,
    ],
    "loaded": 31,
    "floor": 1,
    "single_edge": 0,
}

# I2c.master_host_rate_held ~quarters:2: the host sends the quarter, 32 cycles for 375 kHz, SCL on IO2, SDA on IO3
I2C_FAST = {
    "config": {
        "side_set_count": 1,
        "side_set_base": 14,
        "side_set_pindirs": 1,
        "in_base": 15,
        "in_count": 16,
        "out_base": 15,
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
        0xFFFF, 0xF1FF, 0xFFF2, 0xFFFF, 0xF2FF, 0xFFF3, 0xFFFF, 0xEDFF,
        0xFFF5, 0xFFFF, 0xF0FF, 0xFFF0, 0x0011, 0x0011, 0x0000, 0x0003,
        0x0000, 0x001F, 0x0007, 0xFFFF, 0x000F, 0xFFFF, 0x0007, 0x000F,
        0x000F, 0x000F,
    ],
    "loaded": None,
    "floor": 0,
    "single_edge": 0,
}

# Ethernet.firmware at the Icepi's 40 MHz: the host sends a tenth of the link pulse interval, 64000 cycles for 16 ms, TD+ on IO6, TD- on IO7
ETHERNET = {
    "config": {
        "side_set_count": 0,
        "side_set_base": 5,
        "side_set_pindirs": 0,
        "in_base": 0,
        "in_count": 16,
        "out_base": 18,
        "out_count": 1,
        "set_base": 18,
        "set_count": 2,
        "jmp_pin": 0,
        "capture_pin": 0,
        "capture_rising": 1,
        "in_shift_right": 1,
        "out_shift_right": 1,
        "autopush": 0,
        "push_threshold": 16,
        "autopull": 1,
        "pull_threshold": 16,
        "crc_width": 32,
        "crc_poly": 33568,
        "crc_init": 65535,
        "crc_reflect": 1,
        "stuff_threshold": 0,
        "stuff_level": 1,
        "wrap_bottom": 0,
        "wrap_top": 511,
        "period_fraction": 0,
        "autopull_data": 1,
        "manchester": 1,
        "line_code": 0,
        "route": 0,
        "crc_poly_high": 60856,
        "crc_init_high": 65535,
        "crc_complement": 1,
    },
    "words": [
        0xE004, 0x80C5, 0xA063, 0x80E6, 0xC0CA, 0xA029, 0x20C0, 0x100C,
        0x0206, 0xA301, 0xA000, 0x0005, 0xE004, 0x8045, 0xA020, 0xE008,
        0x6070, 0xA03E, 0x6101, 0x0212, 0x6101, 0xA13E, 0x6101, 0x0216,
        0x6101, 0xE105, 0x6101, 0x041A, 0x6101, 0xE009, 0xA03F, 0x6101,
        0x021F, 0xAA01, 0xA000, 0x80E6, 0xC0CA, 0x0005,
    ],
    "certificate": [
        0x0007, 0x0003, 0x0280, 0x4001, 0x0000, 0x0300, 0x8001, 0x0400,
        0x0600, 0xC001, 0x0400, 0x0900, 0x0001, 0x0600, 0x0B00, 0x0001,
        0x0600, 0x0D00, 0x0001, 0x0800, 0x0F80, 0x0001, 0x0A10, 0xFF06,
        0x02FF, 0x060C, 0xFF06, 0x03FF, 0x060D, 0xFF06, 0x03FF, 0x0603,
        0xFA00, 0xFA00, 0x0000, 0x0009, 0x0000, 0x001E, 0xFFFF, 0xFFFF,
        0x0000, 0x001F,
    ],
    "loaded": 64000,
    "floor": 0,
    "single_edge": 0,
}

# One_wire.firmware with a reset of 84 units: the host sends the unit, 288 cycles for 6 us, so 504 us, on IO4
ONE_WIRE = {
    "config": {
        "side_set_count": 0,
        "side_set_base": 5,
        "side_set_pindirs": 0,
        "in_base": 16,
        "in_count": 16,
        "out_base": 16,
        "out_count": 1,
        "set_base": 16,
        "set_count": 1,
        "jmp_pin": 0,
        "capture_pin": 0,
        "capture_rising": 1,
        "in_shift_right": 1,
        "out_shift_right": 1,
        "autopush": 0,
        "push_threshold": 16,
        "autopull": 0,
        "pull_threshold": 16,
        "crc_width": 16,
        "crc_poly": 40961,
        "crc_init": 65535,
        "crc_reflect": 1,
        "stuff_threshold": 0,
        "stuff_level": 1,
        "wrap_bottom": 0,
        "wrap_top": 511,
        "period_fraction": 0,
        "autopull_data": 0,
        "manchester": 0,
        "line_code": 0,
        "route": 0,
        "crc_poly_high": 0,
        "crc_init_high": 0,
        "crc_complement": 1,
    },
    "words": [
        0x20E0, 0xE004, 0x80C5, 0x20E0, 0xE004, 0x6041, 0x80E6, 0xC0CA,
        0x041A, 0xA027, 0x20C0, 0xA061, 0x6041, 0x20C0, 0x806A, 0x20C0,
        0x4001, 0xA047, 0x20C0, 0x0412, 0x20C0, 0xA060, 0x020A, 0x4068,
        0xE003, 0x0003, 0x20C0, 0xA061, 0xA034, 0x20C0, 0x20C0, 0x20C0,
        0x20C0, 0x021D, 0xA060, 0xA02B, 0x20C0, 0x0224, 0x4001, 0xA030,
        0x20C0, 0x20C0, 0x20C0, 0x20C0, 0x0228, 0x406F, 0xE003, 0x0003,
    ],
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
        0x0000, 0xFF00, 0x06FF, 0xFFFF, 0xFF00, 0x0400, 0x0000, 0x0007,
        0xFFFF, 0x0000, 0x001F, 0x0000, 0x0008, 0x0000, 0x000E, 0xFFFF,
        0xFFFF, 0x0000, 0x000A, 0x0000, 0x0010, 0x0000, 0x0007, 0x0000,
        0x0019, 0x0000, 0x0006, 0x0000, 0x000F,
    ],
    "loaded": 7,
    "floor": 1,
    "single_edge": 0,
}

# Spi_cs.master in mode 0, half period 8: SCK at 3 MHz on OUT5, MOSI on OUT4, MISO on IN0, CS on OUT6 4 cycles before the first edge and 8 after the last, and high 3 us between frames
SPI_CS_MODE0 = {
    "config": {
        "side_set_count": 2,
        "side_set_base": 10,
        "side_set_pindirs": 0,
        "in_base": 0,
        "in_count": 16,
        "out_base": 9,
        "out_count": 1,
        "set_base": 9,
        "set_count": 1,
        "jmp_pin": 0,
        "capture_pin": 0,
        "capture_rising": 1,
        "in_shift_right": 0,
        "out_shift_right": 0,
        "autopush": 1,
        "push_threshold": 8,
        "autopull": 0,
        "pull_threshold": 16,
        "crc_width": 16,
        "crc_poly": 40961,
        "crc_init": 65535,
        "crc_reflect": 1,
        "stuff_threshold": 0,
        "stuff_level": 1,
        "wrap_bottom": 0,
        "wrap_top": 511,
        "period_fraction": 0,
        "autopull_data": 0,
        "manchester": 0,
        "line_code": 0,
        "route": 0,
        "crc_poly_high": 0,
        "crc_init_high": 0,
        "crc_complement": 1,
    },
    "words": [
        0xB088, 0x9083, 0x30E0, 0xF004, 0x7048, 0xB025, 0x90E6, 0xD0C8,
        0x6001, 0xA026, 0x20C0, 0x4801, 0x28C0, 0x6001, 0x020A, 0x20C0,
        0x4801, 0x28C0, 0xE000, 0xA023, 0x041D, 0x20E0, 0xE004, 0x6048,
        0x6001, 0xA026, 0x80E6, 0xC0CA, 0x000A, 0x80E6, 0xC0C8, 0x2040,
        0xF000, 0x90E6, 0xB03C, 0xD0C8, 0xD0C8, 0xD0C8, 0xD0C8, 0xD0C8,
        0xD0C4, 0x3040, 0x0002,
    ],
    "certificate": [
        0x0003, 0x0002, 0x0100, 0x0001, 0x0000, 0x0500, 0x4001, 0x0400,
        0x0E80, 0x8001, 0x080C, 0xFFFF, 0xFCFF, 0xFFFF, 0xFFFF, 0xFDFF,
        0xFFFD, 0x0008, 0x0008, 0x0000, 0x0006, 0x0000, 0xFFFE, 0x0003,
        0x0003,
    ],
    "loaded": None,
    "floor": 0,
    "single_edge": 0,
}

# Spi_cs.master in mode 1, half period 8: SCK at 3 MHz on OUT5, MOSI on OUT4, MISO on IN0, CS on OUT6 4 cycles before the first edge and 8 after the last, and high 3 us between frames
SPI_CS_MODE1 = {
    "config": {
        "side_set_count": 2,
        "side_set_base": 10,
        "side_set_pindirs": 0,
        "in_base": 0,
        "in_count": 16,
        "out_base": 9,
        "out_count": 1,
        "set_base": 9,
        "set_count": 1,
        "jmp_pin": 0,
        "capture_pin": 0,
        "capture_rising": 1,
        "in_shift_right": 0,
        "out_shift_right": 0,
        "autopush": 1,
        "push_threshold": 8,
        "autopull": 0,
        "pull_threshold": 16,
        "crc_width": 16,
        "crc_poly": 40961,
        "crc_init": 65535,
        "crc_reflect": 1,
        "stuff_threshold": 0,
        "stuff_level": 1,
        "wrap_bottom": 0,
        "wrap_top": 511,
        "period_fraction": 0,
        "autopull_data": 0,
        "manchester": 0,
        "line_code": 0,
        "route": 0,
        "crc_poly_high": 0,
        "crc_init_high": 0,
        "crc_complement": 1,
    },
    "words": [
        0xB088, 0x9083, 0x30E0, 0xF004, 0x7048, 0xB025, 0x90E6, 0xD0C8,
        0xE000, 0xA026, 0x20C0, 0x6801, 0x28C0, 0x4001, 0x020A, 0x20C0,
        0x6801, 0x28C0, 0x4001, 0xA023, 0x041D, 0x20E0, 0xE004, 0x6048,
        0xE000, 0xA026, 0x80E6, 0xC0CA, 0x000A, 0x80E6, 0xC0C8, 0x2040,
        0xF000, 0x90E6, 0xB03C, 0xD0C8, 0xD0C8, 0xD0C8, 0xD0C8, 0xD0C8,
        0xD0C4, 0x3040, 0x0002,
    ],
    "certificate": [
        0x0003, 0x0002, 0x0100, 0x0001, 0x0000, 0x0500, 0x4001, 0x0400,
        0x0E80, 0x8001, 0x080C, 0xFFFF, 0xFCFF, 0xFFFF, 0xFFFF, 0xFDFF,
        0xFFFD, 0x0008, 0x0008, 0x0000, 0x0006, 0x0000, 0xFFFE, 0x0003,
        0x0003,
    ],
    "loaded": None,
    "floor": 0,
    "single_edge": 0,
}

# Spi_cs.master in mode 2, half period 8: SCK at 3 MHz on OUT5, MOSI on OUT4, MISO on IN0, CS on OUT6 4 cycles before the first edge and 8 after the last, and high 3 us between frames
SPI_CS_MODE2 = {
    "config": {
        "side_set_count": 2,
        "side_set_base": 10,
        "side_set_pindirs": 0,
        "in_base": 0,
        "in_count": 16,
        "out_base": 9,
        "out_count": 1,
        "set_base": 9,
        "set_count": 1,
        "jmp_pin": 0,
        "capture_pin": 0,
        "capture_rising": 1,
        "in_shift_right": 0,
        "out_shift_right": 0,
        "autopush": 1,
        "push_threshold": 8,
        "autopull": 0,
        "pull_threshold": 16,
        "crc_width": 16,
        "crc_poly": 40961,
        "crc_init": 65535,
        "crc_reflect": 1,
        "stuff_threshold": 0,
        "stuff_level": 1,
        "wrap_bottom": 0,
        "wrap_top": 511,
        "period_fraction": 0,
        "autopull_data": 0,
        "manchester": 0,
        "line_code": 0,
        "route": 0,
        "crc_poly_high": 0,
        "crc_init_high": 0,
        "crc_complement": 1,
    },
    "words": [
        0xB888, 0x9883, 0x38E0, 0xF804, 0x7848, 0xB825, 0x98E6, 0xD8C8,
        0x6801, 0xA826, 0x28C0, 0x4001, 0x20C0, 0x6801, 0x020A, 0x28C0,
        0x4001, 0x20C0, 0xE800, 0xA823, 0x041D, 0x28E0, 0xE804, 0x6848,
        0x6801, 0xA826, 0x88E6, 0xC8CA, 0x000A, 0x88E6, 0xC8C8, 0x2840,
        0xF800, 0x98E6, 0xB83C, 0xD8C8, 0xD8C8, 0xD8C8, 0xD8C8, 0xD8C8,
        0xD8C4, 0x3840, 0x0002,
    ],
    "certificate": [
        0x0003, 0x0002, 0x0100, 0x0001, 0x0000, 0x0500, 0x4001, 0x0400,
        0x0E80, 0x8001, 0x080C, 0xFFFF, 0xFCFF, 0xFFFF, 0xFFFF, 0xFDFF,
        0xFFFD, 0x0008, 0x0008, 0x0000, 0x0006, 0x0000, 0xFFFE, 0x0003,
        0x0003,
    ],
    "loaded": None,
    "floor": 0,
    "single_edge": 0,
}

# Spi_cs.master in mode 3, half period 8: SCK at 3 MHz on OUT5, MOSI on OUT4, MISO on IN0, CS on OUT6 4 cycles before the first edge and 8 after the last, and high 3 us between frames
SPI_CS_MODE3 = {
    "config": {
        "side_set_count": 2,
        "side_set_base": 10,
        "side_set_pindirs": 0,
        "in_base": 0,
        "in_count": 16,
        "out_base": 9,
        "out_count": 1,
        "set_base": 9,
        "set_count": 1,
        "jmp_pin": 0,
        "capture_pin": 0,
        "capture_rising": 1,
        "in_shift_right": 0,
        "out_shift_right": 0,
        "autopush": 1,
        "push_threshold": 8,
        "autopull": 0,
        "pull_threshold": 16,
        "crc_width": 16,
        "crc_poly": 40961,
        "crc_init": 65535,
        "crc_reflect": 1,
        "stuff_threshold": 0,
        "stuff_level": 1,
        "wrap_bottom": 0,
        "wrap_top": 511,
        "period_fraction": 0,
        "autopull_data": 0,
        "manchester": 0,
        "line_code": 0,
        "route": 0,
        "crc_poly_high": 0,
        "crc_init_high": 0,
        "crc_complement": 1,
    },
    "words": [
        0xB888, 0x9883, 0x38E0, 0xF804, 0x7848, 0xB825, 0x98E6, 0xD8C8,
        0xE800, 0xA826, 0x28C0, 0x6001, 0x20C0, 0x4801, 0x020A, 0x28C0,
        0x6001, 0x20C0, 0x4801, 0xA823, 0x041D, 0x28E0, 0xE804, 0x6848,
        0xE800, 0xA826, 0x88E6, 0xC8CA, 0x000A, 0x88E6, 0xC8C8, 0x2840,
        0xF800, 0x98E6, 0xB83C, 0xD8C8, 0xD8C8, 0xD8C8, 0xD8C8, 0xD8C8,
        0xD8C4, 0x3840, 0x0002,
    ],
    "certificate": [
        0x0003, 0x0002, 0x0100, 0x0001, 0x0000, 0x0500, 0x4001, 0x0400,
        0x0E80, 0x8001, 0x080C, 0xFFFF, 0xFCFF, 0xFFFF, 0xFFFF, 0xFDFF,
        0xFFFD, 0x0008, 0x0008, 0x0000, 0x0006, 0x0000, 0xFFFE, 0x0003,
        0x0003,
    ],
    "loaded": None,
    "floor": 0,
    "single_edge": 0,
}

# Swd.firmware: the host sends the half period, 24 cycles for a 1 MHz SWCLK, SWCLK on OUT2, SWDIO on IO5
SWD = {
    "config": {
        "side_set_count": 1,
        "side_set_base": 7,
        "side_set_pindirs": 0,
        "in_base": 17,
        "in_count": 1,
        "out_base": 17,
        "out_count": 1,
        "set_base": 17,
        "set_count": 1,
        "jmp_pin": 0,
        "capture_pin": 0,
        "capture_rising": 1,
        "in_shift_right": 1,
        "out_shift_right": 1,
        "autopush": 0,
        "push_threshold": 16,
        "autopull": 0,
        "pull_threshold": 16,
        "crc_width": 1,
        "crc_poly": 1,
        "crc_init": 0,
        "crc_reflect": 1,
        "stuff_threshold": 0,
        "stuff_level": 1,
        "wrap_bottom": 0,
        "wrap_top": 511,
        "period_fraction": 0,
        "autopull_data": 0,
        "manchester": 0,
        "line_code": 0,
        "route": 0,
        "crc_poly_high": 0,
        "crc_init_high": 0,
        "crc_complement": 1,
    },
    "words": [
        0xA060, 0xA000, 0x20E0, 0xE004, 0x80C5, 0x80E6, 0xC0CA, 0xA03F,
        0x20C0, 0x0208, 0x4001, 0x406F, 0xE003, 0x20E0, 0xE004, 0xA061,
        0x80E6, 0xC0CA, 0x2040, 0x0016, 0x30E0, 0xF004, 0x7041, 0x042E,
        0x704E, 0x7021, 0x022C, 0x90E6, 0xD0CA, 0x1227, 0xF004, 0xB02F,
        0x30C0, 0x6001, 0x20C0, 0xF000, 0x0220, 0x041D, 0x0014, 0x30E0,
        0xF004, 0x90E6, 0xD0CA, 0x001F, 0xA060, 0x000D, 0x90E6, 0xD0CA,
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
        0x04FF, 0xFFFA, 0xFF00, 0x05FF, 0xFFF9, 0x000B, 0xFFFF, 0x0000,
        0x000E, 0x0000, 0x0006, 0xFFFF, 0xFFFF, 0x0000, 0x0002, 0x0000,
        0x0009, 0x0000, 0x0010,
    ],
    "loaded": 11,
    "floor": 1,
    "single_edge": 0,
}

# Nec.rx: frames and repeat codes read at 13500 cycles a half unit, on IO3, where Pico B's GP2 can send them
NEC_RX = {
    "config": {
        "side_set_count": 0,
        "side_set_base": 5,
        "side_set_pindirs": 0,
        "in_base": 15,
        "in_count": 16,
        "out_base": 5,
        "out_count": 1,
        "set_base": 5,
        "set_count": 1,
        "jmp_pin": 15,
        "capture_pin": 15,
        "capture_rising": 0,
        "in_shift_right": 1,
        "out_shift_right": 1,
        "autopush": 1,
        "push_threshold": 16,
        "autopull": 0,
        "pull_threshold": 16,
        "crc_width": 16,
        "crc_poly": 40961,
        "crc_init": 65535,
        "crc_reflect": 1,
        "stuff_threshold": 0,
        "stuff_level": 1,
        "wrap_bottom": 0,
        "wrap_top": 511,
        "period_fraction": 0,
        "autopull_data": 0,
        "manchester": 0,
        "line_code": 0,
        "route": 0,
        "crc_poly_high": 0,
        "crc_init_high": 0,
        "crc_complement": 1,
    },
    "words": [
        0x20E0, 0xE004, 0x80C5, 0x208F, 0xE007, 0x200F, 0x80E7, 0xC0CA,
        0xA02F, 0x20C0, 0x0209, 0x0803, 0x208F, 0x80E6, 0xC0CA, 0xA028,
        0x20C0, 0x0210, 0x0816, 0x808B, 0xE003, 0x0003, 0xA03F, 0xE007,
        0x200F, 0x80E7, 0xC0CA, 0xC0CA, 0xC0CA, 0x20C0, 0xE007, 0xC0CA,
        0x2040, 0x4001, 0x200F, 0x0219, 0x0003,
    ],
    "certificate": [
        0x0005, 0x0004, 0x0180, 0x0001, 0x0000, 0x04C0, 0x4001, 0x0400,
        0x0840, 0x8001, 0x0600, 0x0B40, 0xC001, 0x0800, 0x0CC0, 0x0201,
        0x0A00, 0xFFCB, 0x47FF, 0xCB48, 0xFFCB, 0x47FF, 0xCB47, 0xFFCB,
        0x49FF, 0xCB49, 0x0000, 0x0100, 0x697C, 0x34BC, 0x34BC, 0x0000,
        0x000F, 0x0000, 0x0008, 0xFFFF, 0xFFFF, 0x0000, 0x001F,
    ],
    "loaded": 13500,
    "floor": 0,
    "single_edge": 1,
}

# Snorble.firmware: SIG on OUT0, sync 8.0 us, lows 1.208 and 3.0 us, gaps 2.0 us, frames 214 us apart at least
SNORBLE = {
    "config": {
        "side_set_count": 0,
        "side_set_base": 5,
        "side_set_pindirs": 0,
        "in_base": 0,
        "in_count": 16,
        "out_base": 5,
        "out_count": 1,
        "set_base": 5,
        "set_count": 1,
        "jmp_pin": 0,
        "capture_pin": 0,
        "capture_rising": 1,
        "in_shift_right": 0,
        "out_shift_right": 0,
        "autopush": 0,
        "push_threshold": 16,
        "autopull": 0,
        "pull_threshold": 16,
        "crc_width": 1,
        "crc_poly": 1,
        "crc_init": 1,
        "crc_reflect": 0,
        "stuff_threshold": 0,
        "stuff_level": 1,
        "wrap_bottom": 0,
        "wrap_top": 511,
        "period_fraction": 0,
        "autopull_data": 0,
        "manchester": 0,
        "line_code": 0,
        "route": 0,
        "crc_poly_high": 0,
        "crc_init_high": 0,
        "crc_complement": 1,
    },
    "words": [
        0xA001, 0xA098, 0x80E6, 0xC0C2, 0xA03F, 0xC0CA, 0xC0CA, 0xC0CA,
        0xC0CA, 0xC0CA, 0xC0CA, 0xC0CA, 0xC0CA, 0xC0CA, 0xC0CA, 0xC0CA,
        0x2040, 0x0205, 0x20E0, 0xE004, 0xE005, 0x8083, 0x40A8, 0x6068,
        0x6061, 0x6061, 0x6061, 0x6061, 0x6061, 0x6061, 0x6061, 0x6061,
        0x40C1, 0x4067, 0x80A4, 0x80E6, 0xC0C2, 0x2040, 0xA000, 0xC0CA,
        0xC0CA, 0xC0CA, 0xC0CA, 0xC0CA, 0xC0CA, 0xC0CA, 0xC0CA, 0xC0CA,
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
        0x0010, 0xFFFF, 0x0000, 0x0008, 0xFFFF, 0xFFFF, 0x0000, 0x000F,
        0x0000, 0x0007, 0x0000, 0x0012, 0x0000, 0x0009, 0x0000, 0x000E,
        0x0000, 0x0006,
    ],
    "loaded": 16,
    "floor": 1,
    "single_edge": 0,
}

# Xy2_100.firmware: SENDCK at 2 MHz on OUT3, SYNC on OUT4 and DATA on OUT6, a 20-bit word every 10 us
XY2_100 = {
    "config": {
        "side_set_count": 2,
        "side_set_base": 8,
        "side_set_pindirs": 0,
        "in_base": 0,
        "in_count": 16,
        "out_base": 11,
        "out_count": 1,
        "set_base": 11,
        "set_count": 1,
        "jmp_pin": 0,
        "capture_pin": 0,
        "capture_rising": 1,
        "in_shift_right": 1,
        "out_shift_right": 0,
        "autopush": 0,
        "push_threshold": 16,
        "autopull": 0,
        "pull_threshold": 16,
        "crc_width": 1,
        "crc_poly": 1,
        "crc_init": 1,
        "crc_reflect": 0,
        "stuff_threshold": 0,
        "stuff_level": 1,
        "wrap_bottom": 0,
        "wrap_top": 511,
        "period_fraction": 0,
        "autopull_data": 0,
        "manchester": 0,
        "line_code": 0,
        "route": 0,
        "crc_poly_high": 0,
        "crc_init_high": 0,
        "crc_complement": 1,
    },
    "words": [
        0xA08C, 0x20E0, 0xE004, 0x80E6, 0xC0CA, 0x8045, 0xE005, 0xA02F,
        0x20C0, 0xB800, 0x38C0, 0xF000, 0x30C0, 0xB800, 0x38C0, 0xF000,
        0x30C0, 0xB801, 0x38C0, 0xF000, 0x30C0, 0x7801, 0x38C0, 0xF000,
        0x0214, 0x50D0, 0x30C0, 0x8804, 0x28C0, 0xE000, 0x1021, 0x80A2,
        0x0005, 0xE004, 0x0005,
    ],
    "certificate": [
        0x0003, 0x0003, 0x0280, 0x4001, 0x0000, 0x0A00, 0x8001, 0x0400,
        0x1080, 0xC001, 0x0600, 0xFFFF, 0xF6FF, 0xFFFB, 0xFFFF, 0xF6FF,
        0xFFF8, 0xFFFF, 0xF8FF, 0xFFF8, 0x000C, 0x000C, 0x0000, 0x000F,
        0xFFFF, 0xFFFF,
    ],
    "loaded": None,
    "floor": 0,
    "single_edge": 0,
}

# Lfast.firmware: LFAST frames at 4.8 Mb/s, a payload byte each, on OUT0
LFAST = {
    "config": {
        "side_set_count": 0,
        "side_set_base": 5,
        "side_set_pindirs": 0,
        "in_base": 0,
        "in_count": 16,
        "out_base": 5,
        "out_count": 1,
        "set_base": 5,
        "set_count": 1,
        "jmp_pin": 0,
        "capture_pin": 0,
        "capture_rising": 1,
        "in_shift_right": 1,
        "out_shift_right": 0,
        "autopush": 0,
        "push_threshold": 16,
        "autopull": 0,
        "pull_threshold": 16,
        "crc_width": 16,
        "crc_poly": 40961,
        "crc_init": 65535,
        "crc_reflect": 1,
        "stuff_threshold": 0,
        "stuff_level": 1,
        "wrap_bottom": 0,
        "wrap_top": 511,
        "period_fraction": 0,
        "autopull_data": 0,
        "manchester": 0,
        "line_code": 0,
        "route": 0,
        "crc_poly_high": 0,
        "crc_init_high": 0,
        "crc_complement": 1,
    },
    "words": [
        0xA08A, 0xA000, 0x20E0, 0xE004, 0x6068, 0x80E6, 0xC0CA, 0x20C0,
        0xA001, 0x20C0, 0xA000, 0x20C0, 0xA001, 0x20C0, 0xA000, 0x20C0,
        0xA001, 0x20C0, 0xA000, 0x20C0, 0xA000, 0x20C0, 0xA000, 0x20C0,
        0xA000, 0x20C0, 0xA001, 0x20C0, 0xA000, 0x20C0, 0xA000, 0x20C0,
        0xA001, 0x20C0, 0xA000, 0x20C0, 0xA001, 0x20C0, 0xA001, 0x20C0,
        0xA000, 0x20C0, 0xA000, 0x20C0, 0xA000, 0x20C0, 0xA000, 0x20C0,
        0xA001, 0x20C0, 0xA000, 0x20C0, 0xA000, 0x20C0, 0xA001, 0xA027,
        0x20C0, 0x6001, 0x0238, 0x20C0, 0xA001, 0x20C0, 0xA000, 0x0002,
    ],
    "certificate": [
        0x0002, 0x0001, 0x0100, 0x0001, 0x0000, 0x1C00, 0x4001, 0x0400,
        0xFFFF, 0xF9FF, 0xFFFA, 0x000A, 0x000A, 0x0000, 0x0007,
    ],
    "loaded": None,
    "floor": 0,
    "single_edge": 0,
}

# Tdm_audio.firmware: SCLK at 8 MHz on OUT3, FSYNC on OUT4 and SDATA on OUT6, eight 32-bit channel blocks every 32 us
TDM_AUDIO = {
    "config": {
        "side_set_count": 2,
        "side_set_base": 8,
        "side_set_pindirs": 0,
        "in_base": 0,
        "in_count": 16,
        "out_base": 11,
        "out_count": 1,
        "set_base": 11,
        "set_count": 1,
        "jmp_pin": 0,
        "capture_pin": 0,
        "capture_rising": 1,
        "in_shift_right": 1,
        "out_shift_right": 0,
        "autopush": 0,
        "push_threshold": 16,
        "autopull": 0,
        "pull_threshold": 16,
        "crc_width": 16,
        "crc_poly": 40961,
        "crc_init": 65535,
        "crc_reflect": 1,
        "stuff_threshold": 0,
        "stuff_level": 1,
        "wrap_bottom": 0,
        "wrap_top": 511,
        "period_fraction": 0,
        "autopull_data": 0,
        "manchester": 0,
        "line_code": 0,
        "route": 0,
        "crc_poly_high": 0,
        "crc_init_high": 0,
        "crc_complement": 1,
    },
    "words": [
        0xA000, 0x20E0, 0xB22F, 0xFA04, 0x6201, 0xE800, 0x0204, 0xA000,
        0xA12D, 0xEA00, 0xE200, 0xE800, 0x020A, 0xA02F, 0x1011, 0x88A3,
        0x0012, 0xEA04, 0x6201, 0xE800, 0x0212, 0xA000, 0xA12D, 0xEA00,
        0xE200, 0xE800, 0x0218, 0xA02F, 0x101F, 0x88A3, 0x0020, 0xEA04,
        0x6201, 0xE800, 0x0220, 0xA000, 0xA12D, 0xEA00, 0xE200, 0xE800,
        0x0226, 0xA02F, 0x102D, 0x88A3, 0x002E, 0xEA04, 0x6201, 0xE800,
        0x022E, 0xA000, 0xA12D, 0xEA00, 0xE200, 0xE800, 0x0234, 0xA02F,
        0x103B, 0x88A3, 0x003C, 0xEA04, 0x6201, 0xE800, 0x023C, 0xA000,
        0xA12D, 0xEA00, 0xE200, 0xE800, 0x0242, 0xA02F, 0x1049, 0x88A3,
        0x004A, 0xEA04, 0x6201, 0xE800, 0x024A, 0xA000, 0xA12D, 0xEA00,
        0xE200, 0xE800, 0x0250, 0xA02F, 0x1057, 0x88A3, 0x0058, 0xEA04,
        0x6201, 0xE800, 0x0258, 0xA000, 0xA12D, 0xEA00, 0xE200, 0xE800,
        0x025E, 0xA02F, 0x1065, 0x88A3, 0x0066, 0xEA04, 0x6201, 0xE800,
        0x0266, 0xA000, 0xA12D, 0xEA00, 0xE200, 0xE800, 0x026C, 0xB02F,
        0x1073, 0x98A3, 0x0004, 0xF804, 0x0004,
    ],
    "certificate": [
        0x0018, 0x0000, 0x0200, 0x0000, 0x0200, 0x0500, 0x0000, 0x0400,
        0x0880, 0x0000, 0x0600, 0x0900, 0x0000, 0x0200, 0x0C00, 0x0000,
        0x0400, 0x0F80, 0x0000, 0x0600, 0x1000, 0x0000, 0x0200, 0x1300,
        0x0000, 0x0400, 0x1680, 0x0000, 0x0600, 0x1700, 0x0000, 0x0200,
        0x1A00, 0x0000, 0x0400, 0x1D80, 0x0000, 0x0600, 0x1E00, 0x0000,
        0x0200, 0x2100, 0x0000, 0x0400, 0x2480, 0x0000, 0x0600, 0x2500,
        0x0000, 0x0200, 0x2800, 0x0000, 0x0400, 0x2B80, 0x0000, 0x0600,
        0x2C00, 0x0000, 0x0200, 0x2F00, 0x0000, 0x0400, 0x3280, 0x0000,
        0x0600, 0x3300, 0x0000, 0x0200, 0x3600, 0x0000, 0x0400, 0x3980,
        0x0000, 0x0600, 0x0000, 0x000F, 0x0000, 0x000D, 0x000F, 0x000F,
    ],
    "loaded": None,
    "floor": 0,
    "single_edge": 0,
}

# Dali.firmware: forward and backward frames at 1200 bit/s, 20000 cycles a half bit, the line high when idle, on OUT0
DALI = {
    "config": {
        "side_set_count": 0,
        "side_set_base": 5,
        "side_set_pindirs": 0,
        "in_base": 0,
        "in_count": 16,
        "out_base": 5,
        "out_count": 1,
        "set_base": 5,
        "set_count": 1,
        "jmp_pin": 0,
        "capture_pin": 0,
        "capture_rising": 1,
        "in_shift_right": 1,
        "out_shift_right": 0,
        "autopush": 0,
        "push_threshold": 16,
        "autopull": 0,
        "pull_threshold": 16,
        "crc_width": 16,
        "crc_poly": 40961,
        "crc_init": 65535,
        "crc_reflect": 1,
        "stuff_threshold": 0,
        "stuff_level": 1,
        "wrap_bottom": 0,
        "wrap_top": 511,
        "period_fraction": 0,
        "autopull_data": 0,
        "manchester": 0,
        "line_code": 0,
        "route": 0,
        "crc_poly_high": 0,
        "crc_init_high": 0,
        "crc_complement": 1,
    },
    "words": [
        0xA001, 0x20E0, 0xE004, 0x80C5, 0x20E0, 0xE004, 0x8045, 0x20E0,
        0xE004, 0x80E6, 0xC0CA, 0x20C0, 0xA000, 0x20C0, 0xA001, 0x6021,
        0x0217, 0x20C0, 0xA001, 0x20C0, 0xA000, 0x040F, 0x001C, 0x20C0,
        0xA000, 0x20C0, 0xA001, 0x040F, 0x20C0, 0xA001, 0xA039, 0x20C0,
        0x021F, 0x0004,
    ],
    "certificate": [
        0x0005, 0x0004, 0x0200, 0x0001, 0x0000, 0x0780, 0x4001, 0x0000,
        0x0B80, 0x8001, 0x0000, 0x0E00, 0xC001, 0x0008, 0x0F81, 0x0001,
        0x0608, 0xFF00, 0x03FF, 0xFFFC, 0xFF00, 0x06FF, 0xFFFF, 0xFF00,
        0x05FF, 0xFFFE, 0xFF00, 0x04FF, 0xFFFB, 0x0008, 0xFFFF, 0xFFFF,
        0xFFFF, 0x0000, 0x0019,
    ],
    "loaded": 8,
    "floor": 1,
    "single_edge": 0,
}

# Lin.firmware: a master's header, 1250 cycles a half bit for 19.2 kbaud, on IO5
LIN = {
    "config": {
        "side_set_count": 0,
        "side_set_base": 5,
        "side_set_pindirs": 0,
        "in_base": 17,
        "in_count": 1,
        "out_base": 17,
        "out_count": 1,
        "set_base": 17,
        "set_count": 1,
        "jmp_pin": 17,
        "capture_pin": 0,
        "capture_rising": 1,
        "in_shift_right": 1,
        "out_shift_right": 1,
        "autopush": 0,
        "push_threshold": 16,
        "autopull": 0,
        "pull_threshold": 16,
        "crc_width": 16,
        "crc_poly": 40961,
        "crc_init": 65535,
        "crc_reflect": 1,
        "stuff_threshold": 0,
        "stuff_level": 1,
        "wrap_bottom": 0,
        "wrap_top": 511,
        "period_fraction": 0,
        "autopull_data": 0,
        "manchester": 0,
        "line_code": 0,
        "route": 0,
        "crc_poly_high": 0,
        "crc_init_high": 0,
        "crc_complement": 1,
    },
    "words": [
        0x20E0, 0xE004, 0x80C5, 0xA000, 0xA060, 0x20E0, 0xE004, 0x8045,
        0x20E0, 0xE004, 0x80AD, 0x80E6, 0xC0CA, 0x20C0, 0xA061, 0xA039,
        0x20C0, 0x0210, 0x20C0, 0xA060, 0x20C0, 0x20C0, 0xA024, 0x20C0,
        0xA061, 0x20C0, 0x20C0, 0xA060, 0x20C0, 0x0217, 0x20C0, 0xA061,
        0x20C0, 0xA027, 0x20C0, 0x6081, 0x20C0, 0x0222, 0x20C0, 0xA060,
        0x2040, 0x2011, 0x80E6, 0xC0CA, 0xC0CA, 0xC0CA, 0xC0D2, 0xA027,
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
        0x0800, 0x1500, 0xC001, 0x0600, 0xFFFF, 0x43FF, 0xFF44, 0x0000,
        0x0100, 0x0003, 0xFFFF, 0x44FF, 0xFF44, 0x00C0, 0x00C0, 0x0000,
        0x0017, 0x0000, 0x0007, 0xFFFF, 0xFFFF,
    ],
    "loaded": 192,
    "floor": 0,
    "single_edge": 0,
}

# Wiegand.firmware: a 26-bit card read, DATA0 on OUT0 and DATA1 on OUT1, pulses of 50 us every 500 us
WIEGAND = {
    "config": {
        "side_set_count": 0,
        "side_set_base": 5,
        "side_set_pindirs": 0,
        "in_base": 0,
        "in_count": 16,
        "out_base": 5,
        "out_count": 2,
        "set_base": 5,
        "set_count": 2,
        "jmp_pin": 0,
        "capture_pin": 0,
        "capture_rising": 1,
        "in_shift_right": 1,
        "out_shift_right": 0,
        "autopush": 0,
        "push_threshold": 16,
        "autopull": 0,
        "pull_threshold": 16,
        "crc_width": 16,
        "crc_poly": 40961,
        "crc_init": 65535,
        "crc_reflect": 1,
        "stuff_threshold": 0,
        "stuff_level": 1,
        "wrap_bottom": 0,
        "wrap_top": 511,
        "period_fraction": 0,
        "autopull_data": 0,
        "manchester": 0,
        "line_code": 0,
        "route": 0,
        "crc_poly_high": 0,
        "crc_init_high": 0,
        "crc_complement": 1,
    },
    "words": [
        0xA003, 0x20E0, 0xE004, 0x80C5, 0x20E0, 0xE004, 0x8025, 0xC013,
        0x8081, 0x20E0, 0xE004, 0x8045, 0x20E0, 0xE004, 0x80E6, 0xC0CA,
        0x0C12, 0xE004, 0x6021, 0x0217, 0x20C0, 0xA002, 0x0019, 0x20C0,
        0xA001, 0x20C0, 0xA003, 0x8024, 0x20C0, 0x021C, 0x0410, 0x0009,
    ],
    "certificate": [
        0x0006, 0x0005, 0x0480, 0x0001, 0x0000, 0x0800, 0x4001, 0x0000,
        0x0900, 0x8001, 0x0000, 0x0B80, 0xC001, 0x0000, 0x0C81, 0x0001,
        0x0000, 0x0E01, 0x4001, 0x0000, 0xFF00, 0x03FF, 0xFFF5, 0xFF00,
        0x05FF, 0xFFF8, 0xFF00, 0x08FF, 0xFFFB, 0xFF00, 0x03FF, 0xFFF4,
        0xFF00, 0x04FF, 0xFFF3, 0x0010, 0xFFFF,
    ],
    "loaded": 16,
    "floor": 1,
    "single_edge": 0,
}

# Swd_blind.firmware: SWCLK at 1 MHz on OUT2 and SWDIO on IO5, the RP2040's; the select sequences, TARGETSEL, the DPIDR and an AP read, 745 clocks
SWD_BLIND = {
    "config": {
        "side_set_count": 1,
        "side_set_base": 7,
        "side_set_pindirs": 0,
        "in_base": 17,
        "in_count": 16,
        "out_base": 17,
        "out_count": 1,
        "set_base": 17,
        "set_count": 1,
        "jmp_pin": 0,
        "capture_pin": 0,
        "capture_rising": 1,
        "in_shift_right": 1,
        "out_shift_right": 1,
        "autopush": 0,
        "push_threshold": 16,
        "autopull": 0,
        "pull_threshold": 16,
        "crc_width": 16,
        "crc_poly": 40961,
        "crc_init": 65535,
        "crc_reflect": 1,
        "stuff_threshold": 0,
        "stuff_level": 1,
        "wrap_bottom": 0,
        "wrap_top": 511,
        "period_fraction": 0,
        "autopull_data": 0,
        "manchester": 0,
        "line_code": 0,
        "route": 0,
        "crc_poly_high": 0,
        "crc_init_high": 0,
        "crc_complement": 1,
    },
    "words": [
        0x20E0, 0xE004, 0x80C5, 0x20E0, 0xE004, 0xA027, 0x80E6, 0xC0CA,
        0x6001, 0x6041, 0x040D, 0xA060, 0x000F, 0xE100, 0xA061, 0x20C0,
        0xF000, 0x30C0, 0x4001, 0x0208, 0xE003, 0x0003,
    ],
    "certificate": [
        0x0004, 0x0003, 0x0180, 0x0001, 0x0000, 0x0400, 0x4001, 0x0400,
        0x0680, 0x8001, 0x040C, 0x0780, 0xC001, 0x0400, 0xFF00, 0x03FF,
        0xFFF8, 0xFF00, 0x07FF, 0xFFFC, 0xFF00, 0x0AFF, 0xFFFF, 0x000C,
        0xFFFF, 0x0000, 0x0007, 0x0000, 0xFFFE,
    ],
    "loaded": 12,
    "floor": 1,
    "single_edge": 0,
}

# Ir_nec.firmware: an NEC frame then repeat codes, 422 cycles a third of the 38 kHz carrier, the line high for the carrier's on third, on OUT0
IR_NEC = {
    "config": {
        "side_set_count": 0,
        "side_set_base": 5,
        "side_set_pindirs": 0,
        "in_base": 0,
        "in_count": 16,
        "out_base": 5,
        "out_count": 1,
        "set_base": 5,
        "set_count": 1,
        "jmp_pin": 0,
        "capture_pin": 0,
        "capture_rising": 1,
        "in_shift_right": 1,
        "out_shift_right": 1,
        "autopush": 0,
        "push_threshold": 16,
        "autopull": 0,
        "pull_threshold": 16,
        "crc_width": 16,
        "crc_poly": 40961,
        "crc_init": 65535,
        "crc_reflect": 1,
        "stuff_threshold": 0,
        "stuff_level": 1,
        "wrap_bottom": 0,
        "wrap_top": 511,
        "period_fraction": 0,
        "autopull_data": 0,
        "manchester": 0,
        "line_code": 0,
        "route": 0,
        "crc_poly_high": 0,
        "crc_init_high": 0,
        "crc_complement": 1,
    },
    "words": [
        0x20E0, 0xE004, 0x80C5, 0xA000, 0x20E0, 0xE004, 0x6030, 0x8083,
        0x0217, 0x20E0, 0xE004, 0x8045, 0x6068, 0x40A8, 0x80AD, 0x40A8,
        0x8024, 0x80A2, 0x40A8, 0x80AD, 0x40A8, 0x80A4, 0x8081, 0x80E6,
        0xC0CA, 0xA051, 0xA032, 0x20C0, 0xA001, 0x20C0, 0xA000, 0x20C0,
        0x021B, 0x041A, 0x20C0, 0xA001, 0x20C0, 0xA000, 0xA047, 0xA03F,
        0x20C0, 0x0228, 0x0427, 0x0C2E, 0xA040, 0x0034, 0xA047, 0xA03F,
        0x20C0, 0x0230, 0x042F, 0xA041, 0xA034, 0x20C0, 0xA001, 0x20C0,
        0xA000, 0x20C0, 0x0235, 0x20C0, 0xA001, 0x20C0, 0xA000, 0x0C5D,
        0x80A4, 0x045D, 0x8024, 0x0250, 0xA05E, 0xA039, 0x20C0, 0x20C0,
        0x20C0, 0x20C0, 0x20C0, 0x20C0, 0x20C0, 0x20C0, 0x0246, 0x0445,
        0xA056, 0xA039, 0x20C0, 0x20C0, 0x20C0, 0x20C0, 0x20C0, 0x20C0,
        0x20C0, 0x20C0, 0x0252, 0x0451, 0x0004, 0x6021, 0x0260, 0x0066,
        0xA03F, 0x20C0, 0x20C0, 0x20C0, 0x20C0, 0x0261, 0xA03F, 0x20C0,
        0x20C0, 0x0267, 0x0034,
    ],
    "certificate": [
        0x0015, 0x000C, 0x0200, 0x0001, 0x0000, 0x0B80, 0x0001, 0x0000,
        0x0D00, 0x4001, 0x0008, 0x0D80, 0x8001, 0x0608, 0x1380, 0x4001,
        0x0A10, 0x1400, 0x8001, 0x0C10, 0x1700, 0xC001, 0x0A14, 0x1781,
        0x0001, 0x0A10, 0x1801, 0x4001, 0x0C10, 0x1A01, 0x8001, 0x0A1C,
        0x1A81, 0xC001, 0x101C, 0x2282, 0x0001, 0x0A24, 0x2302, 0x4001,
        0x1424, 0x2801, 0x8001, 0x0014, 0x2882, 0x0001, 0x002C, 0x2902,
        0x4001, 0x142C, 0x2E82, 0x8001, 0x0A1C, 0x3002, 0xC001, 0x001C,
        0x3081, 0xC001, 0x0C1C, 0x3302, 0x4001, 0x0A1C, 0x3383, 0x0001,
        0x0C1C, 0xFF00, 0x04FF, 0xFFF5, 0xFF00, 0x04FF, 0xFFF6, 0xFF00,
        0x08FF, 0xFFF7, 0xFF00, 0x06FF, 0xFFF8, 0xFF00, 0x04FF, 0xFFF9,
        0xFF00, 0x06FF, 0xFFFA, 0xFF00, 0x04FF, 0xFFFB, 0xFF00, 0x06FF,
        0xFFFB, 0xFF00, 0x04FF, 0xFFFC, 0xFF00, 0x05FF, 0xFFF7, 0xFF00,
        0x08FF, 0xFFFA, 0xFF00, 0x04FF, 0xFFFD, 0x0010, 0xFFFF, 0x0000,
        0x0011, 0x0000, 0x0012, 0x0000, 0x0007, 0xFFFF, 0xFFFF, 0x0000,
        0x001F, 0x0000, 0x0001, 0x0000, 0x0014, 0x0000, 0x001E, 0x0000,
        0x0019, 0x0000, 0x0016,
    ],
    "loaded": 16,
    "floor": 1,
    "single_edge": 0,
}
