MarcosAsh/protocol-emulator/formal/powerup.sv

// Power-up is deterministic. Two copies of the chip start from independent arbitrary states
// (every flop and fifo word) and see the same pins every cycle, with rst_n low at the first
// edge and free after it. From the cycle after that edge on, their pins and their three SRAM
// macros' inputs are equal forever.
//
// Premise: the two copies' macros hold the same words after the first edge. A macro is its
// output register. A read takes a value, which is the same in both copies when both read the
// same way after the first edge, and a free one in each otherwise. The copies' writes are
// equal from then on, which is asserted, so the premise holds afterwards if it holds then.
// With COLD, a program macro's words are its own in each copy until its engine is first
// started or lent to the load checker. The cores reset halted, and Host.load fills all 512
// words before a check or a start. The data memory keeps the premise, because nothing fills
// it. The havoc tasks' RTL (powerup_havoc.awk) gives the words and read buffers of the host
// fifos and the edge stamps any value while the fifo is cleared.
//
// By induction on an invariant, which is also asserted. The copies agree on:
//   - every flop outside the fifos and the load checker
//   - each macro's output from the second edge on
//   - the words each fifo holds, the host's and the edge stamps' (fifo_pair)
//   - the checker's state and the words its walk has written (load_checker_pair)
//   - Both_edges' falling flops from the falling edge after the first, which the clear reaches
// powerup.tcl brings the flops out. Each clock edge is a step (multiclock). The teeth set
// NO_INVARIANT, so they fail on the claim alone, from reset.

`include "pairs.sv"

module powerup (input clk);
  (* anyseq *) wire rst_n, ena;
  (* anyseq *) wire [7:0] ui_in, uio_in;

  reg first = 1, warm = 0;
  always @(posedge clk) begin
    first <= 0;
    warm <= !first;
  end
`ifndef NO_RESET
  always @* if (first) assume (!rst_n);
`endif

  wire [7:0] uo_out_a, uio_out_a, uio_oe_a, uo_out_b, uio_out_b, uio_oe_b;
  wire [2:0] men_a, wen_a, ren_a, bist_a, men_b, wen_b, ren_b, bist_b;
  wire [8:0] addr_a[0:2], addr_b[0:2];
  wire [15:0] din_a[0:2], din_b[0:2], bm_a[0:2], bm_b[0:2], dout_a[0:2], dout_b[0:2];
  wire [`STATE_BITS - 1:0] state_a, state_b;
  wire [`FALLING_BITS - 1:0] falling_a, falling_b;
  wire reset_done_a, reset_done_b, reset_late_a, reset_late_b;
  wire [1:0] start_a, start_b, halted_a, halted_b, started_a, started_b, refill_a, refill_b;
  wire [1:0] lent_a, lent_b;
  fifo_t rx_0_a, tx_0_a, rx_1_a, tx_1_a, rx_0_b, tx_0_b, rx_1_b, tx_1_b;
  // four stamps, each the 24-bit timer and the 20 pads
  localparam STAMP = 44;
  wire [7 * STAMP + 6 + 4 + 9 - 1:0] stamps_a, stamps_b;
  load_checker_t load_checker_a, load_checker_b;
  wire [`WORD_CLASS_BITS - 1:0] word_class_a, word_class_b;

`define CHIP(side) \
  tt_um_marcosash_protocol_emulator side ( \
    .clk(clk), .rst_n(rst_n), .ena(ena), .ui_in(ui_in), .uio_in(uio_in), \
    .uo_out(uo_out_``side), .uio_out(uio_out_``side), .uio_oe(uio_oe_``side), \
    `PORTS(side, 0) `PORTS(side, 1) `PORTS(side, 2) \
    .state(state_``side), .falling(falling_``side), \
    .reset_done(reset_done_``side), .reset_late(reset_late_``side), \
    .start(start_``side), .halted(halted_``side), \
    .started(started_``side), .refill(refill_``side), .lent(lent_``side), \
    .rx_0(rx_0_``side), .tx_0(tx_0_``side), \
    .rx_1(rx_1_``side), .tx_1(tx_1_``side), .stamps(stamps_``side), \
    .load_checker(load_checker_``side), .word_class(word_class_``side) \
  );
`define PORTS(side, n) \
    .m``n``_men(men_``side[n]), .m``n``_wen(wen_``side[n]), .m``n``_ren(ren_``side[n]), \
    .m``n``_addr(addr_``side[n]), .m``n``_din(din_``side[n]), .m``n``_bm(bm_``side[n]), \
    .m``n``_bist_en(bist_``side[n]), .m``n``_dout(dout_``side[n]),
`define FIFO(name) fifo_pair name (.check(!first), .a(name``_a), .b(name``_b));

  `CHIP(a)
  `CHIP(b)
`ifdef HOST_SCRIPT
  // the stale tooth's host, which a bmc from reset can reach: a bit every two cycles, a
  // write of 1 to register 0 that starts engine 0, then a read of its rx fifo, register 8,
  // two words long; engine 0 pushes no word while the fifo holds one, so none is stored
  reg [7:0] cycle = 0;
  always @(posedge clk) if (cycle != 255) cycle <= cycle + 1;
  wire frame_1 = cycle >= 4 && cycle < 54;
  wire frame_2 = cycle >= 58 && cycle < 162;
  wire [7:0] bit_1 = (cycle - 8'd5) >> 1, bit_2 = (cycle - 8'd59) >> 1;
  wire [23:0] write_start = 24'h800001;
  wire [7:0] read_rx = 8'h08;
  wire mosi = frame_1 && cycle >= 5 && cycle < 53 ? write_start[5'd23 - bit_1[4:0]]
    : frame_2 && cycle >= 59 && bit_2 < 8 ? read_rx[3'd7 - bit_2[2:0]] : 1'b0;
  always @* if (!first) begin
    assume (rst_n);
    assume (ui_in[2] == !(frame_1 || frame_2));
    assume (ui_in[0] == (((frame_1 && cycle >= 6) || (frame_2 && cycle >= 60)) && !cycle[0]));
    assume (ui_in[1] == mosi);
    assume (rx_0_a.counters.used <= 1);
  end
`endif
`ifndef NO_INVARIANT
  `FIFO(rx_0)
  `FIFO(tx_0)
  `FIFO(rx_1)
  `FIFO(tx_1)
  fifo_pair #(.WORD(STAMP), .ADDR(2), .USED(3), .NEARLY(4)) stamps (
    .check(!first), .a(stamps_a), .b(stamps_b));
  load_checker_pair load_checker (.check(!first), .a(load_checker_a), .b(load_checker_b));
  // the classes registered from the word, a cycle behind it, so they are the same from
  // Target on, just as the word is from Head on, and only Word moves it
  always @* if (!first && load_checker_a.sm > 3) assert (word_class_a == word_class_b);
`endif

  // which macros hold the host's words, the same in both copies (all of them unless COLD),
  // and whether a macro's output holds a read of them
  reg [2:0] read_loaded = 0;
`ifdef COLD
  // started (ran, running) is tracked apart from lent to the checker (borrowed, read_by),
  // because only a start lets an engine fetch
  reg [1:0] ran = 0, borrowed = 0;
  wire [1:0] running = ran | (first ? 2'b00 : start_a);
  wire [1:0] read_by = borrowed | (first ? 2'b00 : lent_a);
  wire [2:0] loaded = {1'b1, running | read_by};
  always @(posedge clk) begin
    ran <= running;
    borrowed <= read_by;
  end
`else
  wire [2:0] loaded = 3'b111;
`endif
  always @(posedge clk) read_loaded <= loaded;

  genvar n;
  generate
    for (n = 0; n < 3; n = n + 1) begin : macro
      sram_pair pair (
        .clk(clk), .first(first),
        .ports_a({men_a[n], wen_a[n], ren_a[n], loaded[n] && addr_a[n] == addr_b[n],
                  din_a[n] == din_b[n], bm_a[n] == bm_b[n]}),
        .ports_b({men_b[n], wen_b[n], ren_b[n], loaded[n] && addr_a[n] == addr_b[n],
                  din_a[n] == din_b[n], bm_a[n] == bm_b[n]}),
        .dout_a(dout_a[n]), .dout_b(dout_b[n])
      );
    end
  endgenerate

  always @* if (!first) begin
    assert (uo_out_a == uo_out_b);
    assert (uio_out_a == uio_out_b);
    assert (uio_oe_a == uio_oe_b);
    assert (men_a == men_b && wen_a == wen_b && ren_a == ren_b);
    assert (addr_a[0] == addr_b[0] && addr_a[1] == addr_b[1] && addr_a[2] == addr_b[2]);
    assert (din_a[0] == din_b[0] && din_a[1] == din_b[1] && din_a[2] == din_b[2]);
    assert (bm_a[0] == bm_b[0] && bm_a[1] == bm_b[1] && bm_a[2] == bm_b[2]);
  end
  // the model above is the macro with BIST off, as the RTL ties it
  always @* assert (bist_a == 0 && bist_b == 0);

`ifndef NO_INVARIANT
  // the invariant beside fifo_pair. Each macro reads every cycle, so from the second edge
  // on its output holds a word that the premise makes the same
  always @* if (!first) assert (state_a == state_b);
  // the clear holds until the second edge, and the falling flops' own clear, a cycle behind
  // it, holds from the first, so the falling edge between them clears the falling flops in both
  reg fell = 0;
  always @(negedge clk) if (!first) fell <= 1;
  always @* if (first) assert (!fell);
  always @* if (!first && !warm) assert (!reset_done_a && !reset_done_b);
  always @* if (!first && !warm) assert (!reset_late_a && !reset_late_b);
  always @* if (!first && !clk || warm) assert (fell);
  always @* if (fell) assert (falling_a == falling_b);
  generate
    for (n = 0; n < 3; n = n + 1) begin : settled
      always @* if (warm && read_loaded[n]) assert (dout_a[n] == dout_b[n]);
    end
  endgenerate
  // the flags only ever rise, and read_loaded is loaded as of the last edge; otherwise an
  // induction over half cycles (multiclock) would take it as anything
`ifdef COLD
  always @* if (!first) assert (read_loaded == {1'b1, ran | borrowed});
`else
  always @* if (!first) assert (read_loaded == 3'b111);
`endif
  always @* begin
    assert (!warm || !first);
    assert ((read_loaded | loaded) == loaded);
`ifdef COLD
    // an engine only leaves halted, and fetches, on a start
    if (!first) begin
      assert ((running | halted_a) == 2'b11);
      assert ((running | started_a | refill_a) == running);
    end
`endif
  end
`endif
endmodule
