MarcosAsh/protocol-emulator/python/clock_cliffs.py

# Written by test/python/write_clock_cliffs.ml; `dune promote` after a change, then
# reseal: sha256sum python/clock_cliffs.py > test/clock_cliffs.sha256.
# The clocks each bench firmware stays certified at, image and load unchanged
# (test/clock_window.ml). The certificate is in cycles; only the ns move. LIMITS has
# each datasheet limit's cliff: a least holds up to highest_hz, a most from
# lowest_hz, exact to the hertz. A kernel bound may sit below the widths a run
# shows, so a wire can pass past its cliff; a run bound is the run's own width.
# WINDOWS is each firmware's intersection, the limit that fails a hertz past each
# end. words_md5 is md5 of the image's words, then its load if any, each as %04X.

LIMITS = [
    {"firmware": "uart_tx_9600", "limit": "bit >= 102083 ns", "bound": "kernel", "cycles": 5000, "lowest_hz": None, "highest_hz": 48969796},
    {"firmware": "uart_tx_9600", "limit": "bit <= 106250 ns", "bound": "run", "cycles": 5000, "lowest_hz": 47068236, "highest_hz": None},
    {"firmware": "uart_tx_19200", "limit": "bit >= 51041.7 ns", "bound": "kernel", "cycles": 2500, "lowest_hz": None, "highest_hz": 48959999},
    {"firmware": "uart_tx_19200", "limit": "bit <= 53125 ns", "bound": "run", "cycles": 2500, "lowest_hz": 47077648, "highest_hz": None},
    {"firmware": "uart_tx_38400", "limit": "bit >= 25520.8 ns", "bound": "kernel", "cycles": 1250, "lowest_hz": None, "highest_hz": 48940408},
    {"firmware": "uart_tx_38400", "limit": "bit <= 26562.5 ns", "bound": "run", "cycles": 1250, "lowest_hz": 47096471, "highest_hz": None},
    {"firmware": "uart_tx_57600", "limit": "bit >= 17013.9 ns", "bound": "kernel", "cycles": 833, "lowest_hz": None, "highest_hz": 48901224},
    {"firmware": "uart_tx_57600", "limit": "bit <= 17708.3 ns", "bound": "run", "cycles": 833, "lowest_hz": 47096472, "highest_hz": None},
    {"firmware": "uart_tx_115200", "limit": "bit >= 8506.94 ns", "bound": "kernel", "cycles": 417, "lowest_hz": None, "highest_hz": 48901227},
    {"firmware": "uart_tx_115200", "limit": "bit <= 8854.17 ns", "bound": "run", "cycles": 417, "lowest_hz": 47209410, "highest_hz": None},
    {"firmware": "uart_tx_230400", "limit": "bit >= 4253.47 ns", "bound": "kernel", "cycles": 208, "lowest_hz": None, "highest_hz": 48666124},
    {"firmware": "uart_tx_230400", "limit": "bit <= 4427.08 ns", "bound": "run", "cycles": 208, "lowest_hz": 47209416, "highest_hz": None},
    {"firmware": "i2c_master", "limit": "THIGH >= 600 ns", "bound": "kernel", "cycles": 96, "lowest_hz": None, "highest_hz": 106666666},
    {"firmware": "i2c_master", "limit": "TLOW >= 1300 ns", "bound": "kernel", "cycles": 96, "lowest_hz": None, "highest_hz": 73076923},
    {"firmware": "i2c_master", "limit": "THD:STA >= 600 ns", "bound": "kernel", "cycles": 48, "lowest_hz": None, "highest_hz": 78333333},
    {"firmware": "i2c_master", "limit": "TSU:STA >= 600 ns", "bound": "kernel", "cycles": 48, "lowest_hz": None, "highest_hz": 53333333},
    {"firmware": "i2c_master", "limit": "TSU:DAT >= 100 ns", "bound": "kernel", "cycles": 47, "lowest_hz": None, "highest_hz": 117500000},
    {"firmware": "i2c_master", "limit": "TSU:STO >= 600 ns", "bound": "kernel", "cycles": 48, "lowest_hz": None, "highest_hz": 53333333},
    {"firmware": "i2c_master", "limit": "TBUF >= 1300 ns", "bound": "kernel", "cycles": 149, "lowest_hz": None, "highest_hz": 93125000},
    {"firmware": "i2c_master_stretch", "limit": "THIGH >= 600 ns", "bound": "kernel", "cycles": 96, "lowest_hz": None, "highest_hz": 106666666},
    {"firmware": "i2c_master_stretch", "limit": "TLOW >= 1300 ns", "bound": "kernel", "cycles": 96, "lowest_hz": None, "highest_hz": 73076923},
    {"firmware": "i2c_master_stretch", "limit": "THD:STA >= 600 ns", "bound": "kernel", "cycles": 48, "lowest_hz": None, "highest_hz": 78333333},
    {"firmware": "i2c_master_stretch", "limit": "TSU:STA >= 600 ns", "bound": "kernel", "cycles": 48, "lowest_hz": None, "highest_hz": 53333333},
    {"firmware": "i2c_master_stretch", "limit": "TSU:DAT >= 100 ns", "bound": "kernel", "cycles": 47, "lowest_hz": None, "highest_hz": 117500000},
    {"firmware": "i2c_master_stretch", "limit": "TSU:STO >= 600 ns", "bound": "kernel", "cycles": 48, "lowest_hz": None, "highest_hz": 53333333},
    {"firmware": "i2c_master_stretch", "limit": "TBUF >= 1300 ns", "bound": "kernel", "cycles": 105, "lowest_hz": None, "highest_hz": 65625000},
    {"firmware": "i2c_standard", "limit": "THIGH >= 4000 ns", "bound": "kernel", "cycles": 242, "lowest_hz": None, "highest_hz": 48400000},
    {"firmware": "i2c_standard", "limit": "TLOW >= 4700 ns", "bound": "kernel", "cycles": 242, "lowest_hz": None, "highest_hz": 51276595},
    {"firmware": "i2c_standard", "limit": "THD:STA >= 4000 ns", "bound": "kernel", "cycles": 362, "lowest_hz": None, "highest_hz": 90250000},
    {"firmware": "i2c_standard", "limit": "TSU:STA >= 4700 ns", "bound": "kernel", "cycles": 363, "lowest_hz": None, "highest_hz": 63684210},
    {"firmware": "i2c_standard", "limit": "TSU:DAT >= 250 ns", "bound": "kernel", "cycles": 120, "lowest_hz": None, "highest_hz": 96000000},
    {"firmware": "i2c_standard", "limit": "TSU:STO >= 4000 ns", "bound": "kernel", "cycles": 363, "lowest_hz": None, "highest_hz": 72600000},
    {"firmware": "i2c_standard", "limit": "TBUF >= 4700 ns", "bound": "kernel", "cycles": 368, "lowest_hz": None, "highest_hz": 64561403},
    {"firmware": "i2c_standard", "limit": "1/fSCL >= 10000 ns", "bound": "run", "cycles": 484, "lowest_hz": None, "highest_hz": 48300000},
    {"firmware": "i2c_fast", "limit": "THIGH >= 600 ns", "bound": "kernel", "cycles": 64, "lowest_hz": None, "highest_hz": 71111111},
    {"firmware": "i2c_fast", "limit": "TLOW >= 1300 ns", "bound": "kernel", "cycles": 64, "lowest_hz": None, "highest_hz": 48461538},
    {"firmware": "i2c_fast", "limit": "THD:STA >= 600 ns", "bound": "kernel", "cycles": 64, "lowest_hz": None, "highest_hz": 105000000},
    {"firmware": "i2c_fast", "limit": "TSU:STA >= 600 ns", "bound": "kernel", "cycles": 64, "lowest_hz": None, "highest_hz": 71111111},
    {"firmware": "i2c_fast", "limit": "TSU:DAT >= 100 ns", "bound": "kernel", "cycles": 31, "lowest_hz": None, "highest_hz": 77500000},
    {"firmware": "i2c_fast", "limit": "TSU:STO >= 600 ns", "bound": "kernel", "cycles": 64, "lowest_hz": None, "highest_hz": 71111111},
    {"firmware": "i2c_fast", "limit": "TBUF >= 1300 ns", "bound": "kernel", "cycles": 101, "lowest_hz": None, "highest_hz": 63125000},
    {"firmware": "i2c_fast", "limit": "1/fSCL >= 2500 ns", "bound": "run", "cycles": 128, "lowest_hz": None, "highest_hz": 50800000},
    {"firmware": "i2c_standard_asym", "limit": "THIGH >= 4000 ns", "bound": "kernel", "cycles": 254, "lowest_hz": None, "highest_hz": 50800000},
    {"firmware": "i2c_standard_asym", "limit": "TLOW >= 4700 ns", "bound": "kernel", "cycles": 227, "lowest_hz": None, "highest_hz": 48085106},
    {"firmware": "i2c_standard_asym", "limit": "THD:STA >= 4000 ns", "bound": "kernel", "cycles": 380, "lowest_hz": None, "highest_hz": 94750000},
    {"firmware": "i2c_standard_asym", "limit": "TSU:STA >= 4700 ns", "bound": "kernel", "cycles": 381, "lowest_hz": None, "highest_hz": 66842105},
    {"firmware": "i2c_standard_asym", "limit": "TSU:DAT >= 250 ns", "bound": "kernel", "cycles": 126, "lowest_hz": None, "highest_hz": 100800000},
    {"firmware": "i2c_standard_asym", "limit": "TSU:STO >= 4000 ns", "bound": "kernel", "cycles": 381, "lowest_hz": None, "highest_hz": 76200000},
    {"firmware": "i2c_standard_asym", "limit": "TBUF >= 4700 ns", "bound": "kernel", "cycles": 386, "lowest_hz": None, "highest_hz": 67719298},
    {"firmware": "i2c_standard_asym", "limit": "1/fSCL >= 10000 ns", "bound": "run", "cycles": 481, "lowest_hz": None, "highest_hz": 48000000},
    {"firmware": "i2c_fast_asym", "limit": "THIGH >= 600 ns", "bound": "kernel", "cycles": 57, "lowest_hz": None, "highest_hz": 63333333},
    {"firmware": "i2c_fast_asym", "limit": "TLOW >= 1300 ns", "bound": "kernel", "cycles": 64, "lowest_hz": None, "highest_hz": 48461538},
    {"firmware": "i2c_fast_asym", "limit": "THD:STA >= 600 ns", "bound": "kernel", "cycles": 64, "lowest_hz": None, "highest_hz": 105000000},
    {"firmware": "i2c_fast_asym", "limit": "TSU:STA >= 600 ns", "bound": "kernel", "cycles": 64, "lowest_hz": None, "highest_hz": 71111111},
    {"firmware": "i2c_fast_asym", "limit": "TSU:DAT >= 100 ns", "bound": "kernel", "cycles": 31, "lowest_hz": None, "highest_hz": 77500000},
    {"firmware": "i2c_fast_asym", "limit": "TSU:STO >= 600 ns", "bound": "kernel", "cycles": 64, "lowest_hz": None, "highest_hz": 71111111},
    {"firmware": "i2c_fast_asym", "limit": "TBUF >= 1300 ns", "bound": "kernel", "cycles": 101, "lowest_hz": None, "highest_hz": 63125000},
    {"firmware": "i2c_fast_asym", "limit": "1/fSCL >= 2500 ns", "bound": "run", "cycles": 121, "lowest_hz": None, "highest_hz": 48000000},
    {"firmware": "sk6812", "limit": "T0H >= 250 ns", "bound": "kernel", "cycles": 17, "lowest_hz": None, "highest_hz": 64000000},
    {"firmware": "sk6812", "limit": "T0H <= 400 ns", "bound": "run", "cycles": 17, "lowest_hz": 45000000, "highest_hz": None},
    {"firmware": "sk6812", "limit": "T1H >= 650 ns", "bound": "run", "cycles": 34, "lowest_hz": None, "highest_hz": 50769230},
    {"firmware": "sk6812", "limit": "T1H <= 1000 ns", "bound": "run", "cycles": 34, "lowest_hz": 35000000, "highest_hz": None},
    {"firmware": "sk6812", "limit": "T0L >= 800 ns", "bound": "run", "cycles": 42, "lowest_hz": None, "highest_hz": 51250000},
    {"firmware": "sk6812", "limit": "T1L >= 200 ns", "bound": "kernel", "cycles": 25, "lowest_hz": None, "highest_hz": 120000000},
    {"firmware": "sk6812", "limit": "T >= 1200 ns", "bound": "run", "cycles": 59, "lowest_hz": None, "highest_hz": 48333333},
    {"firmware": "sk6812", "limit": "reset >= 200000 ns", "bound": "run", "cycles": 10907, "lowest_hz": None, "highest_hz": 54530000},
    {"firmware": "one_wire", "limit": "tLOW1 >= 1000 ns", "bound": "kernel", "cycles": 288, "lowest_hz": None, "highest_hz": 287000000},
    {"firmware": "one_wire", "limit": "tLOW1 <= 15000 ns", "bound": "run", "cycles": 288, "lowest_hz": 19266667, "highest_hz": None},
    {"firmware": "one_wire", "limit": "tLOW0 >= 60000 ns", "bound": "run", "cycles": 3168, "lowest_hz": None, "highest_hz": 52783333},
    {"firmware": "one_wire", "limit": "tLOW0 <= 120000 ns", "bound": "run", "cycles": 3168, "lowest_hz": 26408334, "highest_hz": None},
    {"firmware": "one_wire", "limit": "tREC >= 1000 ns", "bound": "kernel", "cycles": 288, "lowest_hz": None, "highest_hz": 287000000},
    {"firmware": "one_wire", "limit": "tSLOT + tREC >= 61000 ns", "bound": "run", "cycles": 3456, "lowest_hz": None, "highest_hz": 56639344},
    {"firmware": "one_wire", "limit": "tRSTL >= 480000 ns", "bound": "run", "cycles": 24194, "lowest_hz": None, "highest_hz": 50402083},
    {"firmware": "one_wire", "limit": "tRSTH >= 480000 ns", "bound": "run", "cycles": 23336, "lowest_hz": None, "highest_hz": 48614583},
    {"firmware": "ps2", "limit": "data to CLK fall >= 5000 ns", "bound": "kernel", "cycles": 957, "lowest_hz": None, "highest_hz": 191200000},
    {"firmware": "ps2", "limit": "CLK rise to data >= 5000 ns", "bound": "kernel", "cycles": 960, "lowest_hz": None, "highest_hz": 191800000},
    {"firmware": "ps2", "limit": "CLK low >= 30000 ns", "bound": "kernel", "cycles": 1920, "lowest_hz": None, "highest_hz": 63966666},
    {"firmware": "ps2", "limit": "CLK low <= 50000 ns", "bound": "run", "cycles": 1920, "lowest_hz": 38420000, "highest_hz": None},
    {"firmware": "ps2", "limit": "CLK high >= 30000 ns", "bound": "run", "cycles": 1920, "lowest_hz": None, "highest_hz": 63966666},
    {"firmware": "ps2", "limit": "CLK high <= 50000 ns", "bound": "run", "cycles": 1920, "lowest_hz": 38420000, "highest_hz": None},
    {"firmware": "can", "limit": "recessive >= 1000 ns", "bound": "kernel", "cycles": 96, "lowest_hz": None, "highest_hz": 95000000},
    {"firmware": "can", "limit": "dominant >= 1000 ns", "bound": "kernel", "cycles": 96, "lowest_hz": None, "highest_hz": 95000000},
    {"firmware": "can", "limit": "idle to SOF >= 22000 ns", "bound": "run", "cycles": 1165, "lowest_hz": None, "highest_hz": 52909090},
    {"firmware": "can_sender", "limit": "recessive >= 1000 ns", "bound": "kernel", "cycles": 96, "lowest_hz": None, "highest_hz": 95000000},
    {"firmware": "can_sender", "limit": "dominant >= 1000 ns", "bound": "kernel", "cycles": 96, "lowest_hz": None, "highest_hz": 95000000},
    {"firmware": "can_sender", "limit": "idle to SOF >= 22000 ns", "bound": "run", "cycles": 1165, "lowest_hz": None, "highest_hz": 52909090},
    {"firmware": "can_receiver", "limit": "ACK >= 1000 ns", "bound": "kernel", "cycles": 96, "lowest_hz": None, "highest_hz": 95000000},
    {"firmware": "cec", "limit": "start low >= 3.5e+06 ns", "bound": "run", "cycles": 177600, "lowest_hz": None, "highest_hz": 50742571},
    {"firmware": "cec", "limit": "start low <= 3.9e+06 ns", "bound": "run", "cycles": 177600, "lowest_hz": 45538718, "highest_hz": None},
    {"firmware": "cec", "limit": "start bit >= 4.3e+06 ns", "bound": "run", "cycles": 216000, "lowest_hz": None, "highest_hz": 50232325},
    {"firmware": "cec", "limit": "start bit <= 4.7e+06 ns", "bound": "run", "cycles": 216000, "lowest_hz": 45957660, "highest_hz": None},
    {"firmware": "cec", "limit": "one low, T1 >= 400000 ns", "bound": "run", "cycles": 28800, "lowest_hz": None, "highest_hz": 71997500},
    {"firmware": "cec", "limit": "one low, T2 <= 800000 ns", "bound": "run", "cycles": 28800, "lowest_hz": 36001250, "highest_hz": None},
    {"firmware": "cec", "limit": "zero low, T5 >= 1.3e+06 ns", "bound": "run", "cycles": 72000, "lowest_hz": None, "highest_hz": 55383846},
    {"firmware": "cec", "limit": "zero low, T6 <= 1.7e+06 ns", "bound": "run", "cycles": 72000, "lowest_hz": 42353530, "highest_hz": None},
    {"firmware": "cec", "limit": "bit, T7 >= 2.05e+06 ns", "bound": "run", "cycles": 115200, "lowest_hz": None, "highest_hz": 56194634},
    {"firmware": "cec", "limit": "bit, T8 <= 2.75e+06 ns", "bound": "run", "cycles": 115200, "lowest_hz": 41891273, "highest_hz": None},
    {"firmware": "spi_cs_mode0", "limit": "tCLH >= 9 ns", "bound": "kernel", "cycles": 8, "lowest_hz": None, "highest_hz": 777777777},
    {"firmware": "spi_cs_mode0", "limit": "tCLL >= 9 ns", "bound": "kernel", "cycles": 8, "lowest_hz": None, "highest_hz": 777777777},
    {"firmware": "spi_cs_mode0", "limit": "tSLCH >= 3 ns", "bound": "kernel", "cycles": 4, "lowest_hz": None, "highest_hz": 1000000000},
    {"firmware": "spi_cs_mode0", "limit": "tCHSH >= 3 ns", "bound": "kernel", "cycles": 8, "lowest_hz": None, "highest_hz": 2333333333},
    {"firmware": "spi_cs_mode0", "limit": "tSHSL2 >= 50 ns", "bound": "kernel", "cycles": 154, "lowest_hz": None, "highest_hz": 3060000000},
    {"firmware": "spi_cs_mode0", "limit": "tRES1 >= 3000 ns", "bound": "kernel", "cycles": 154, "lowest_hz": None, "highest_hz": 51000000},
    {"firmware": "spi_cs_mode1", "limit": "tCLH >= 9 ns", "bound": "kernel", "cycles": 8, "lowest_hz": None, "highest_hz": 777777777},
    {"firmware": "spi_cs_mode1", "limit": "tCLL >= 9 ns", "bound": "kernel", "cycles": 8, "lowest_hz": None, "highest_hz": 777777777},
    {"firmware": "spi_cs_mode1", "limit": "tSLCH >= 3 ns", "bound": "kernel", "cycles": 4, "lowest_hz": None, "highest_hz": 1000000000},
    {"firmware": "spi_cs_mode1", "limit": "tCHSH >= 3 ns", "bound": "kernel", "cycles": 8, "lowest_hz": None, "highest_hz": 2333333333},
    {"firmware": "spi_cs_mode1", "limit": "tSHSL2 >= 50 ns", "bound": "kernel", "cycles": 154, "lowest_hz": None, "highest_hz": 3060000000},
    {"firmware": "spi_cs_mode1", "limit": "tRES1 >= 3000 ns", "bound": "kernel", "cycles": 154, "lowest_hz": None, "highest_hz": 51000000},
    {"firmware": "spi_cs_mode2", "limit": "tCLH >= 9 ns", "bound": "kernel", "cycles": 8, "lowest_hz": None, "highest_hz": 777777777},
    {"firmware": "spi_cs_mode2", "limit": "tCLL >= 9 ns", "bound": "kernel", "cycles": 8, "lowest_hz": None, "highest_hz": 777777777},
    {"firmware": "spi_cs_mode2", "limit": "tSLCH >= 3 ns", "bound": "kernel", "cycles": 4, "lowest_hz": None, "highest_hz": 1000000000},
    {"firmware": "spi_cs_mode2", "limit": "tCHSH >= 3 ns", "bound": "kernel", "cycles": 8, "lowest_hz": None, "highest_hz": 2333333333},
    {"firmware": "spi_cs_mode2", "limit": "tSHSL2 >= 50 ns", "bound": "kernel", "cycles": 154, "lowest_hz": None, "highest_hz": 3060000000},
    {"firmware": "spi_cs_mode2", "limit": "tRES1 >= 3000 ns", "bound": "kernel", "cycles": 154, "lowest_hz": None, "highest_hz": 51000000},
    {"firmware": "spi_cs_mode3", "limit": "tCLH >= 9 ns", "bound": "kernel", "cycles": 8, "lowest_hz": None, "highest_hz": 777777777},
    {"firmware": "spi_cs_mode3", "limit": "tCLL >= 9 ns", "bound": "kernel", "cycles": 8, "lowest_hz": None, "highest_hz": 777777777},
    {"firmware": "spi_cs_mode3", "limit": "tSLCH >= 3 ns", "bound": "kernel", "cycles": 4, "lowest_hz": None, "highest_hz": 1000000000},
    {"firmware": "spi_cs_mode3", "limit": "tCHSH >= 3 ns", "bound": "kernel", "cycles": 8, "lowest_hz": None, "highest_hz": 2333333333},
    {"firmware": "spi_cs_mode3", "limit": "tSHSL2 >= 50 ns", "bound": "kernel", "cycles": 154, "lowest_hz": None, "highest_hz": 3060000000},
    {"firmware": "spi_cs_mode3", "limit": "tRES1 >= 3000 ns", "bound": "kernel", "cycles": 154, "lowest_hz": None, "highest_hz": 51000000},
    {"firmware": "swd", "limit": "SWCLK high >= 20.8333 ns", "bound": "kernel", "cycles": 7, "lowest_hz": None, "highest_hz": 288004608},
    {"firmware": "swd", "limit": "SWCLK low >= 20.8333 ns", "bound": "kernel", "cycles": 24, "lowest_hz": None, "highest_hz": 1104017664},
    {"firmware": "snorble", "limit": "tSYN >= 7500 ns", "bound": "run", "cycles": 384, "lowest_hz": None, "highest_hz": 51066666},
    {"firmware": "snorble", "limit": "tSYN <= 8500 ns", "bound": "run", "cycles": 384, "lowest_hz": 45294118, "highest_hz": None},
    {"firmware": "snorble", "limit": "tL0 >= 1100 ns", "bound": "kernel", "cycles": 58, "lowest_hz": None, "highest_hz": 51818181},
    {"firmware": "snorble", "limit": "tL0 <= 1300 ns", "bound": "run", "cycles": 58, "lowest_hz": 45384616, "highest_hz": None},
    {"firmware": "snorble", "limit": "tL1 >= 2900 ns", "bound": "run", "cycles": 144, "lowest_hz": None, "highest_hz": 49310344},
    {"firmware": "snorble", "limit": "tL1 <= 3100 ns", "bound": "run", "cycles": 144, "lowest_hz": 46774194, "highest_hz": None},
    {"firmware": "snorble", "limit": "tH >= 1800 ns", "bound": "kernel", "cycles": 96, "lowest_hz": None, "highest_hz": 52777777},
    {"firmware": "snorble", "limit": "tH <= 4000 ns", "bound": "run", "cycles": 96, "lowest_hz": 24250000, "highest_hz": None},
    {"firmware": "snorble", "limit": "tIFG >= 20000 ns", "bound": "run", "cycles": 8566, "lowest_hz": None, "highest_hz": 428250000},
    {"firmware": "snorble", "limit": "frame rate >= 200000 ns", "bound": "run", "cycles": 10422, "lowest_hz": None, "highest_hz": 52105000},
    {"firmware": "microwire", "limit": "SK clock range >= 1600 ns", "bound": "run", "cycles": 310, "lowest_hz": None, "highest_hz": 193125000},
    {"firmware": "microwire", "limit": "Write data DI setup >= 300 ns", "bound": "kernel", "cycles": 113, "lowest_hz": None, "highest_hz": 373333333},
    {"firmware": "microwire", "limit": "Write data DI hold >= 800 ns", "bound": "kernel", "cycles": 42, "lowest_hz": None, "highest_hz": 51250000},
    {"firmware": "microwire", "limit": "Chip enable setup >= 300 ns", "bound": "kernel", "cycles": 312, "lowest_hz": None, "highest_hz": 1036666666},
    {"firmware": "microwire", "limit": "Chip enable hold >= 800 ns", "bound": "kernel", "cycles": 155, "lowest_hz": None, "highest_hz": 192500000},
    {"firmware": "microwire", "limit": "SK clock range >= 2000 ns", "bound": "run", "cycles": 310, "lowest_hz": None, "highest_hz": 154500000},
    {"firmware": "microwire", "limit": "Write data DI setup >= 300 ns", "bound": "kernel", "cycles": 113, "lowest_hz": None, "highest_hz": 373333333},
    {"firmware": "microwire", "limit": "Chip enable setup >= 400 ns", "bound": "kernel", "cycles": 312, "lowest_hz": None, "highest_hz": 777500000},
    {"firmware": "microwire", "limit": "SK clock range >= 4000 ns", "bound": "run", "cycles": 310, "lowest_hz": None, "highest_hz": 77250000},
    {"firmware": "microwire", "limit": "SK clock range <= 250000 ns", "bound": "run", "cycles": 310, "lowest_hz": 1244000, "highest_hz": None},
    {"firmware": "microwire", "limit": "Write data DI setup >= 1000 ns", "bound": "kernel", "cycles": 113, "lowest_hz": None, "highest_hz": 112000000},
    {"firmware": "microwire", "limit": "Write data DI hold >= 100 ns", "bound": "kernel", "cycles": 42, "lowest_hz": None, "highest_hz": 410000000},
    {"firmware": "microwire", "limit": "Chip enable setup >= 1000 ns", "bound": "kernel", "cycles": 312, "lowest_hz": None, "highest_hz": 311000000},
    {"firmware": "microwire", "limit": "Chip enable hold >= 1000 ns", "bound": "kernel", "cycles": 155, "lowest_hz": None, "highest_hz": 154000000},
    {"firmware": "microwire", "limit": "SK clock range >= 5000 ns", "bound": "run", "cycles": 310, "lowest_hz": None, "highest_hz": 61800000},
    {"firmware": "microwire", "limit": "SK clock range <= 100000 ns", "bound": "run", "cycles": 310, "lowest_hz": 3110000, "highest_hz": None},
    {"firmware": "microwire", "limit": "Write data DI setup >= 200 ns", "bound": "kernel", "cycles": 113, "lowest_hz": None, "highest_hz": 560000000},
    {"firmware": "microwire", "limit": "Write data DI hold >= 200 ns", "bound": "kernel", "cycles": 42, "lowest_hz": None, "highest_hz": 205000000},
    {"firmware": "microwire", "limit": "Chip enable setup >= 200 ns", "bound": "kernel", "cycles": 312, "lowest_hz": None, "highest_hz": 1555000000},
    {"firmware": "microwire", "limit": "Chip enable hold >= 200 ns", "bound": "kernel", "cycles": 155, "lowest_hz": None, "highest_hz": 770000000},
    {"firmware": "microwire", "limit": "SK clock range >= 4000 ns", "bound": "run", "cycles": 310, "lowest_hz": None, "highest_hz": 77250000},
    {"firmware": "microwire", "limit": "Write data DI setup >= 400 ns", "bound": "kernel", "cycles": 113, "lowest_hz": None, "highest_hz": 280000000},
    {"firmware": "microwire", "limit": "Write data DI hold >= 400 ns", "bound": "kernel", "cycles": 42, "lowest_hz": None, "highest_hz": 102500000},
    {"firmware": "microwire", "limit": "Chip enable setup >= 200 ns", "bound": "kernel", "cycles": 312, "lowest_hz": None, "highest_hz": 1555000000},
    {"firmware": "microwire", "limit": "SK clock frequency >= 4000 ns", "bound": "run", "cycles": 310, "lowest_hz": None, "highest_hz": 77250000},
    {"firmware": "microwire", "limit": "SK clock high time >= 1000 ns", "bound": "kernel", "cycles": 155, "lowest_hz": None, "highest_hz": 154000000},
    {"firmware": "microwire", "limit": "instruction cycle time >= 4000 ns", "bound": "run", "cycles": 310, "lowest_hz": None, "highest_hz": 77250000},
    {"firmware": "microwire", "limit": "instruction cycle time <= 10000 ns", "bound": "run", "cycles": 310, "lowest_hz": 31100000, "highest_hz": None},
    {"firmware": "microwire", "limit": "CS low period following an E/W instruction >= 1e+07 ns", "bound": "run", "cycles": 1245217, "lowest_hz": None, "highest_hz": 124521600},
    {"firmware": "microwire", "limit": "CS low period following an E/W instruction <= 3e+07 ns", "bound": "run", "cycles": 1245217, "lowest_hz": 41507267, "highest_hz": None},
    {"firmware": "microwire", "limit": "TWE, VPP width >= 2e+07 ns", "bound": "run", "cycles": 1245217, "lowest_hz": None, "highest_hz": 62260800},
    {"firmware": "caliper", "limit": "clock high at 90 kHz >= 5555.5 ns", "bound": "kernel", "cycles": 270, "lowest_hz": None, "highest_hz": 48420484},
    {"firmware": "caliper", "limit": "clock low at 90 kHz >= 5555.5 ns", "bound": "kernel", "cycles": 270, "lowest_hz": None, "highest_hz": 48420484},
    {"firmware": "caliper", "limit": "pause before the first word >= 55000 ns", "bound": "run", "cycles": 2705, "lowest_hz": None, "highest_hz": 49163636},
    {"firmware": "caliper", "limit": "pause between the words >= 110000 ns", "bound": "run", "cycles": 5400, "lowest_hz": None, "highest_hz": 49081818},
    {"firmware": "caliper", "limit": "pause after the last word >= 55000 ns", "bound": "run", "cycles": 5408, "lowest_hz": None, "highest_hz": 98309090},
    {"firmware": "xy2_100", "limit": "tDS >= 50 ns", "bound": "kernel", "cycles": 12, "lowest_hz": None, "highest_hz": 220000000},
    {"firmware": "xy2_100", "limit": "tDH >= 100 ns", "bound": "kernel", "cycles": 12, "lowest_hz": None, "highest_hz": 110000000},
    {"firmware": "lfast", "limit": "data rate, shortest high bit (3.125 ns) >= 3.125 ns", "bound": "kernel", "cycles": 10, "lowest_hz": None, "highest_hz": 2880000000},
    {"firmware": "lfast", "limit": "data rate, shortest low bit (3.125 ns) >= 3.125 ns", "bound": "kernel", "cycles": 10, "lowest_hz": None, "highest_hz": 2880000000},
    {"firmware": "dali", "limit": "idle after a frame >= 2.45e+06 ns", "bound": "run", "cycles": 540010, "lowest_hz": None, "highest_hz": 220411836},
    {"firmware": "dali", "limit": "40 commands a second, forward frames 25 ms apart >= 2.5e+07 ns", "bound": "run", "cycles": 1220010, "lowest_hz": None, "highest_hz": 48800360},
    {"firmware": "lin", "limit": "break field >= 677083 ns", "bound": "run", "cycles": 33750, "lowest_hz": None, "highest_hz": 49844676},
    {"firmware": "lin", "limit": "break delimiter >= 52083.3 ns", "bound": "run", "cycles": 3750, "lowest_hz": None, "highest_hz": 71980800},
    {"firmware": "lin", "limit": "break field length (dominant + delimiter) >= 729167 ns", "bound": "run", "cycles": 37500, "lowest_hz": None, "highest_hz": 51427199},
    {"firmware": "lin", "limit": "THeader_Maximum, 1.4 * THeader_Nominal of 34 TBit <= 2.47917e+06 ns", "bound": "run", "cycles": 87500, "lowest_hz": 35294522, "highest_hz": None},
    {"firmware": "lin", "limit": "FTOL_RES_MASTER, bit >= 51822.9 ns", "bound": "run", "cycles": 2500, "lowest_hz": None, "highest_hz": 48221909},
    {"firmware": "lin", "limit": "FTOL_RES_MASTER, bit <= 52343.8 ns", "bound": "run", "cycles": 2500, "lowest_hz": 47780299, "highest_hz": None},
    {"firmware": "lin", "limit": "bit rate, 20 kbit/s >= 50000 ns", "bound": "run", "cycles": 2500, "lowest_hz": None, "highest_hz": 49980000},
    {"firmware": "lin", "limit": "bit rate, 1 kbit/s <= 1e+06 ns", "bound": "run", "cycles": 2500, "lowest_hz": 2501000, "highest_hz": None},
    {"firmware": "spdif", "limit": "a block of 192 frames, 44.1 kHz and 1100 ppm >= 4.34896e+06 ns", "bound": "run", "cycles": 208979, "lowest_hz": None, "highest_hz": 48052433},
    {"firmware": "spdif", "limit": "a block of 192 frames, 44.1 kHz less 1100 ppm <= 4.35854e+06 ns", "bound": "run", "cycles": 208979, "lowest_hz": 47947294, "highest_hz": None},
    {"firmware": "spdif", "limit": "a frame, Mode 0's 192 kHz at most >= 5208.33 ns", "bound": "run", "cycles": 1088, "lowest_hz": None, "highest_hz": 208704013},
    {"firmware": "usb_power_delivery", "limit": "fBitRate max 330 kbps: each bit cell >= 3030.3 ns", "bound": "run", "cycles": 160, "lowest_hz": None, "highest_hz": 52470000},
    {"firmware": "usb_power_delivery", "limit": "fBitRate min 270 kbps: each bit cell <= 3703.7 ns", "bound": "run", "cycles": 160, "lowest_hz": 43469997, "highest_hz": None},
    {"firmware": "usb_power_delivery", "limit": "tUnitInterval min >= 3030 ns", "bound": "run", "cycles": 160, "lowest_hz": None, "highest_hz": 52475247},
    {"firmware": "usb_power_delivery", "limit": "tUnitInterval max <= 3700 ns", "bound": "run", "cycles": 160, "lowest_hz": 43513514, "highest_hz": None},
    {"firmware": "usb_power_delivery", "limit": "pBitRate 0.25 %: 32 bits against the preamble's last 32, of 32 UI at 300 kbps <= 266.667 ns", "bound": "run", "cycles": 0, "lowest_hz": 3749996, "highest_hz": None},
    {"firmware": "usb_power_delivery", "limit": "tHoldLowBMC: every low >= 1000 ns", "bound": "kernel", "cycles": 80, "lowest_hz": None, "highest_hz": 79000000},
    {"firmware": "usb_power_delivery", "limit": "tInterFrameGap: each idle low >= 25000 ns", "bound": "run", "cycles": 1367, "lowest_hz": None, "highest_hz": 54640000},
    {"firmware": "dmx512", "limit": "bit at 250 kbit/s, shortest low >= 4000 ns", "bound": "kernel", "cycles": 192, "lowest_hz": None, "highest_hz": 48000000},
    {"firmware": "dmx512", "limit": "bit at 250 kbit/s, shortest high >= 4000 ns", "bound": "kernel", "cycles": 192, "lowest_hz": None, "highest_hz": 48000000},
    {"firmware": "dmx512", "limit": "bit at 250 kbit/s, longest channel low <= 4000 ns", "bound": "run", "cycles": 192, "lowest_hz": 48000000, "highest_hz": None},
    {"firmware": "dmx512", "limit": "BREAK transmitted >= 92000 ns", "bound": "run", "cycles": 4800, "lowest_hz": None, "highest_hz": 52163043},
    {"firmware": "dmx512", "limit": "BREAK receiver recognized >= 88000 ns", "bound": "run", "cycles": 4800, "lowest_hz": None, "highest_hz": 54534090},
    {"firmware": "dmx512", "limit": "MAB transmitted >= 12000 ns", "bound": "run", "cycles": 768, "lowest_hz": None, "highest_hz": 63916666},
    {"firmware": "dmx512", "limit": "MAB receiver recognized >= 8000 ns", "bound": "run", "cycles": 768, "lowest_hz": None, "highest_hz": 95875000},
    {"firmware": "dmx512", "limit": "MAB since 1990 >= 8000 ns", "bound": "run", "cycles": 768, "lowest_hz": None, "highest_hz": 95875000},
    {"firmware": "dmx512", "limit": "break to break transmitted >= 1.204e+06 ns", "bound": "run", "cycles": 1092101, "lowest_hz": None, "highest_hz": 907059800},
    {"firmware": "dmx512", "limit": "break to break receivers handle >= 1.196e+06 ns", "bound": "run", "cycles": 1092101, "lowest_hz": None, "highest_hz": 913127090},
    {"firmware": "dmx512", "limit": "refresh rate of 512 channels, at most 44 Hz >= 2.27273e+07 ns", "bound": "run", "cycles": 1092101, "lowest_hz": None, "highest_hz": 48052400},
    {"firmware": "swd_blind", "limit": "Trn >= 1000 ns", "bound": "kernel", "cycles": 50, "lowest_hz": None, "highest_hz": 49000000},
    {"firmware": "swd_blind", "limit": "line reset >= 50000 ns", "bound": "run", "cycles": 2910, "lowest_hz": None, "highest_hz": 58180000},
    {"firmware": "swd_blind", "limit": "idle cycles >= 2000 ns", "bound": "run", "cycles": 394, "lowest_hz": None, "highest_hz": 196500000},
    {"firmware": "swd_blind", "limit": "JTAG-to-SWD >= 50000 ns", "bound": "run", "cycles": 2758, "lowest_hz": None, "highest_hz": 55140000},
    {"firmware": "swd_blind", "limit": "JTAG-to-DS >= 5000 ns", "bound": "run", "cycles": 548, "lowest_hz": None, "highest_hz": 109400000},
    {"firmware": "swd_blind", "limit": "SWD-to-DS >= 50000 ns", "bound": "run", "cycles": 2758, "lowest_hz": None, "highest_hz": 55140000},
    {"firmware": "swd_blind", "limit": "DS-to-SWD >= 50000 ns", "bound": "run", "cycles": 2758, "lowest_hz": None, "highest_hz": 55140000},
    {"firmware": "ir_nec", "limit": "Carrier frequency, as its period >= 26315.8 ns", "bound": "run", "cycles": 1266, "lowest_hz": None, "highest_hz": 48070000},
    {"firmware": "ir_nec", "limit": "Bit time, logical 0 >= 1.125e+06 ns", "bound": "run", "cycles": 54438, "lowest_hz": None, "highest_hz": 48388444},
    {"firmware": "ir_nec", "limit": "Bit time, logical 1 >= 2.25e+06 ns", "bound": "run", "cycles": 108454, "lowest_hz": None, "highest_hz": 48201333},
    {"firmware": "ir_nec", "limit": "Carrier burst length >= 560000 ns", "bound": "run", "cycles": 27008, "lowest_hz": None, "highest_hz": 48226785},
    {"firmware": "ir_nec", "limit": "AGC burst, message start >= 9e+06 ns", "bound": "run", "cycles": 433394, "lowest_hz": None, "highest_hz": 48154777},
    {"firmware": "ir_nec", "limit": "Space after AGC burst, message start >= 4.5e+06 ns", "bound": "run", "cycles": 216486, "lowest_hz": None, "highest_hz": 48107777},
    {"firmware": "ir_nec", "limit": "Extra burst at end of message >= 560000 ns", "bound": "run", "cycles": 27008, "lowest_hz": None, "highest_hz": 48226785},
    {"firmware": "ir_nec", "limit": "AGC pulse, repeat code >= 9e+06 ns", "bound": "run", "cycles": 433394, "lowest_hz": None, "highest_hz": 48154777},
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
