MarcosAsh/protocol-emulator/(commit log)

2026-09-16 pin out the host port
2026-09-17 add assembler
2026-09-17 add uart rx firmware
2026-09-17 rearm capture before the stop bit in uart rx
2026-09-17 add spi master firmware
2026-09-17 let side-set drive pin directions
2026-09-17 add i2c master firmware
2026-09-19 configure the flow for the sram macro
2026-09-19 add the host spi byte layer
2026-09-19 test the spi byte layer
2026-09-19 run firmware through the top over spi
2026-09-19 add top and assemble commands
2026-09-19 rename the spi bit counter
2026-09-19 wire the top into the tiny tapeout wrapper
2026-09-19 test the wrapper over spi
2026-09-19 name the macro instance for the flow
2026-09-19 prove issue timing with symbiyosys
    [issue_timing.sv]
2026-09-19 add the demo board transport
2026-09-19 give the i2c start a quarter of slack
2026-09-19 switch the flow to cmos5l
2026-09-19 share the rtl printer
2026-09-19 share the pin ranges
2026-09-19 drive the host tests from the spi master model
2026-09-19 name the printed values
2026-09-19 write the spi byte layer with registers
2026-09-19 add the sram power stripe step
2026-09-19 power the sram from the metal4 stripes
2026-09-19 run the uart at 115200 baud
2026-09-20 let random programs keep to input pin waits
2026-09-20 add a pin side spi master model
2026-09-20 add the spi slave firmware
2026-09-20 run the spi slave against the master model
2026-09-20 run the spi slave in lockstep
2026-09-20 add a pin side i2c master model
2026-09-20 add the i2c slave firmware
2026-09-20 run the i2c slave against the master model
2026-09-20 run the i2c slave in lockstep
2026-09-20 format the spi slave tests
2026-09-20 report pin edges and samples with their jitter
2026-09-20 track the crc and the stuff run in the model
2026-09-20 log i2c reads over uart from one core
2026-09-20 document the spi byte layer ports
2026-09-20 comment the spi edge sampling
2026-09-20 print a waveform of one spi byte
2026-09-20 print a waveform of a control write
2026-09-20 print a waveform of reset and the first command
2026-09-20 model usb low speed on the wire
2026-09-20 place at fifty percent density
    The router crashed on a clock delay buffer net that spanned the SRAM macro. A
    different placement avoids the net; antenna repair stays on.
2026-09-20 make the fifos four deep
    A showahead Fifo holds capacity + 1 words, so full never rose at four and wait rx
    never blocked. Found through a mutant that no test killed.
2026-09-20 let the host clear the interrupt in lockstep
2026-09-21 move the uart model tests into their own file
2026-09-21 move the uart lockstep tests next to the model tests
2026-09-21 move the spi model tests into their own file
2026-09-21 move the spi lockstep tests next to the model tests
2026-09-21 move the i2c lockstep tests next to the model tests
2026-09-21 toggle a pin every two cycles with a wrapped loop
2026-09-21 add wrap directives to the assembler
2026-09-21 run a wrapped loop over spi
2026-09-21 rotate the pin runs instead of indexing every pin
2026-09-21 prove the rotated pins against a pin by pin reference
2026-09-21 test the fifos from a jump without stalling
2026-09-21 reassemble the uart words for the cocotb test
2026-09-21 add a usb device that answers an in token with nak
2026-09-21 talk to the usb device over a shared bus in the model
2026-09-21 run the usb device in lockstep
2026-09-21 assemble the cocotb firmware from source files
2026-09-21 read the cocotb firmware words from the assembled files
2026-09-21 test that the committed firmware words are current
2026-09-21 fail the host timing proof once for every part taken away
    [host_timing.sv]
2026-09-21 fail the fifo order proof when a pop is forgotten
    [fifo_order.sv]
2026-09-21 print the chip's numbers as a csv row
2026-09-21 take setup and out data in the usb device and acknowledge it
2026-09-21 send the usb device a setup, a bad crc, a status packet and a stranger's data
2026-09-21 measure how long the usb device takes to reply
2026-09-21 analyse the usb device
2026-09-21 queue replies for the usb device and check their crc and stuffing
2026-09-21 ask the usb device for a report on endpoint 1
2026-09-21 add a usb host and the board's side of the device
2026-09-21 run a scenario on the top and record every pin
2026-09-21 print a trace one line per run of identical cycles
2026-09-21 add the pin traces
2026-09-21 write the traces from dune and fail when one is stale
2026-09-21 replay the pin traces in cocotb
2026-09-21 leave a word in the rx fifo so no trace depends on unwritten ram
2026-09-21 print the instruction forms no firmware or random program issues
2026-09-21 describe a host frame, whole or cut short
2026-09-21 show how fast the spi clock can go before reads slip
2026-09-21 record the pin traces again for the deeper fifos
2026-09-21 use the cad suite's own cocotb for the fpga step and replay the pin traces in ci
2026-09-21 reset the usb bus: the board sees it on the wire and reloads address 0
2026-09-21 run the board's half of the usb device in python, through the rtl
2026-09-21 replay the pin traces on the gate level in ci
2026-09-21 add eight wires inside the chip to the pin space
2026-09-21 skip the antenna repair step that crashes the router
2026-09-22 cut the analyser report down to edges, samples and misses
2026-09-22 read the rom of a 1-wire slave from firmware
2026-09-22 refuse to assemble firmware that can miss a deadline
2026-09-22 hold the usb device to its analysis over a whole enumeration
2026-09-22 free every config field in the issue timing proof and give it teeth
    [issue_timing.sv]
2026-09-22 describe the firmware, the proofs and the assembler's check in the readme and datasheet
2026-09-22 time one engine's uart edges from the other and print them beside the prediction
2026-09-22 time one engine's uart from the other over spi in cocotb
2026-09-22 print a listing from the assembler for a debugger to show
2026-09-22 build udp frames on the host in python and send one through the verilog
2026-09-22 measure every pin edge from the one before, so a loop with no deadline is certified too
2026-09-22 give the board the ethernet firmware and a script that sends a datagram a second
2026-09-23 register the pin a wait watches beside the word, off the slowest path to the memory
2026-09-26 lead the readme with the chain, the certified table and the die
2026-09-26 report the kernel's verdict when assembling
2026-09-26 expect the kernel's verdict in the assembler's output
2026-09-26 bound mov t, capture only once a wait has seen the edge since the arm
2026-09-26 count only the first wait after the arm as seeing the captured edge
2026-09-26 add a uart transmitter state machine in the hobby boards style
2026-09-26 prove a late host word can make time-triggered firmware fault but never move a pin
2026-09-26 add a streaming uart tx that never waits on the host
2026-09-26 add a streaming spi master that never waits on the host
2026-09-26 feed the streaming spi master to its schedule, reading every reply at once
2026-09-26 add a uart that stamps each frame with the cycle its start bit shows
2026-09-26 prove by induction that each stamped frame carries the cycle its start bit shows
2026-09-26 give the kernel the single edge assumption when assembling
2026-09-27 print a bound on the edge jitter of each firmware the kernel accepts
2026-09-27 prove a pin outside an engine's footprint never moves
2026-09-27 give each firmware the footprint the frame lemma proves and check pairs for overlap
2026-09-27 lint every compare of timer values in the core and the kernel's step
2026-09-27 refuse to assemble firmware whose rows the kernel does not accept
2026-09-27 watch the capture premise in the tests and arm uart rx only while the line is high
2026-09-27 certify i2c master at the smallest quarter whose pins keep to fast-mode plus at 50 mhz
2026-09-28 carry the frame lemma to the two-engine chip
2026-09-28 make the comments shorter
    [check_metrics.py, chip_frame.sv, demo_ethernet.py, demo_usb.py, edge_step.sv, ethernet.py, fifo_order.sv, frame_step.sv]
2026-09-28 prove the hardened netlist equal to the rtl with the sram macros cut
2026-09-28 certify which bits of the host word the pins carry for the uart_tx family, spi_master and jtag
2026-09-28 vendor the uart from hardcaml_hobby_boards
2026-09-28 compile the unmodified hobby boards uart tx
2026-09-28 prove the compiled hobby uart tx equal to the circuit by induction
2026-09-28 print only that the osr tooth has a counterexample, not z3's model
2026-09-28 prove in one run that no deadline is missed for any program and any table of intervals the kernel accepts
    [phase_step.sv]
2026-09-28 prove by induction that a uart between two engines delivers every byte
2026-09-28 prove the uart link and its teeth in ci
2026-09-28 bound the reaction to a captured edge beside the jitter bound
2026-09-28 check the deadline, pins and footprint qeds with cake_lpr
2026-09-29 certify uart_tx_host_rate, one_wire and ps2 for every host period from a floor
2026-09-29 prove on that lemma that no deadline is missed for any table with slopes and offsets the kernel accepts
    [phase_step.sv]
2026-09-29 run each weakened step lemma through the witness flow, which has to fail
2026-09-29 fail the witness flow if certifaiger writes other checks than the ones it verifies
2026-09-29 load the chip from a bare pico over its hardware spi
2026-09-29 print the chip's two uarts from a second pico
2026-09-29 pin the chip to the icepi zero's header and usb port on every board revision
2026-09-29 run the cocotb tests and pin traces on the icepi zero's netlist
2026-09-29 load zeros after the program, which the kernel reads there and the sram does not power up with
2026-09-29 check one clock and a two-flop synchroniser on every pin of the rtl and the netlist
2026-09-29 refute a second sampler, a first-stage reader, a latch, a loop and a derived clock
2026-09-29 print the analyser's rows from assemble with -rows
2026-09-29 sample the uart_tx pin trace as the analyser would, for a capture before the board
2026-09-29 capture a micropython bit-banged uart from a pico to compare against
2026-09-29 add an i2c master that copies each scl release onto a wire, and a meter that times the pad's rise from it
2026-09-29 blame a slow scl rise on the board: per-release verdicts on the pico and in cocotb
2026-09-29 check a firmware's frames against its certificate from a second engine
2026-09-29 assemble the checker and print a frame's rows for the cocotb tests
2026-09-29 check engine 0's uart frames on the chip from engine 1 in cocotb
2026-09-29 compile the assembler, analyser and kernel to javascript behind PLAYGROUND=yes
2026-09-29 add an edge logger that echoes the wire it stamps on out0
2026-09-29 time one engine with the other from the host pico, quiet and under an spi flood
2026-09-29 serve the keyboard from the icepi's host pico, typing once addressed and keeping a report across a reset
    [demo_usb.py, usb_board.py]
2026-09-29 widen the kernel's count since the arm by two bits, so the timer lint sees that it cannot wrap
2026-09-29 take a cycle off the capture's age after mov t, capture, since the arm takes effect a cycle late
2026-09-29 check i2c_master's pins against fast-mode plus to the cycle, and refuse a short scl low
2026-09-29 let the assembler and the analyser's check take a floor on p, the kernel checked at both ends
2026-09-29 certify the self-check checker at every load from min_gap and assemble it with the timing check
2026-09-29 label the pico's fixed call delay apart from its data edges' spread, with the worst edge
    [overlay.py]
2026-09-29 make the core's timer width a functor parameter, isa's on the chip
2026-09-29 prove the edge, frame and value lemmas on a core with a 7-bit timer
2026-09-29 size the kernel by the timer's width too, isa's on the chip
2026-09-30 prove the step lemma on the narrow core, where a timer that saturates fails it
    [phase_step.sv]
2026-09-30 prove the narrow-timer lemmas and the wrap's tooth in ci
2026-09-30 log each key the laptop takes from engine 1's uart while engine 0 types
2026-09-30 let the listener pico print the uarts as text
2026-09-30 drop the acks a reload flushes from the board's queue and put back a flushed report
2026-09-30 refuse in the kernel each row of the library's tables moved a cycle, and each capture or arm age
2026-09-30 print a kernel refusal as a waveform of the core, with the accepted fix beside it
2026-09-30 check uart_tx_host_rate's bits against midi's baud tolerance to the cycle, and refuse a bit a cycle short
2026-09-30 check one_wire's slots against the ds18b20's write-1 low and recovery to the cycle, and refuse a unit a cycle short
2026-09-30 refuse a uart stop bit cut short under midi's bit spacing
2026-09-30 compile pin predicates to firmware whose verdict latency the kernel certifies, refused when the code cannot meet it
2026-09-30 watch for i2c starts on the chip in cocotb, each verdict the certified latency after the sda fall
2026-09-30 prove on the rtl that a pin wait releases in the cycle that samples its event, which the verdict latency rests on
2026-09-30 compile a pin that stops moving to a poll per level, its verdict window certified with the polls' jitter
2026-09-30 read predicates from text and compile them from the command line, which writes the i2c watch cocotb runs
2026-09-30 watch a pin stop moving on the chip in cocotb, each verdict inside the certified window
2026-09-30 take a budget too long for set from the host, and space a quiet pin's polls out to reach a thousand cycles
2026-09-30 start the quiet samples with a run as short as any, not twice the window
2026-09-30 prove a jump on the pin goes by its own cycle's sample, which a quiet pin's polls and a guard rest on
2026-09-30 enter a quiet pin's low half by falling through the prologue's poll and the wrap, so every way into an anchor is two cycles after a sample
2026-09-30 refuse a bidirectional verdict pin, whose direction the firmware never sets
2026-09-30 check the i2c and quiet watch words are current with the rest
2026-09-30 cover a level wait's release, a held wait's reissue and a not-taken and a !pin jump in the event lemma
2026-09-30 check every way into a quiet anchor samples the watched pin at its half's level
2026-09-30 give the event lemma's held wait a tooth, and cover a held edge wait, a not-taken !pin and a not-taken jump at the wrap
2026-09-30 print the anchors and verdicts a budget from the host certifies
2026-09-30 watch a quiet pin at a latency the host sends the budget for, its period read from the settings
2026-09-30 shorten the readme to the chain, one example and the proofs
2026-09-30 render the die from gds run 36615334436
2026-09-30 say the uart link between the two engines is proved for all time
2026-09-30 attach the assembler, the firmware and the chip to a release on every v tag
2026-09-30 add dshot600 and dshot1200 transmitters the kernel accepted as first written, and the decoder that caught their short gap between frames
2026-09-30 leave cec's seven bit periods free before the same initiator's next frame, and time the free per case in both followers
2026-09-30 wait out sent's 12-tick pause before a late frame, so a word that lands in it cannot cut the pause short
    [certified_firmware.py]
2026-09-30 ask a new cec initiator for 5 bit periods free, and allow 3 only for a retry of the same frame
2026-09-30 time a cec ack slot's low as a one or a zero whoever pulls it, so a long ack fails and another follower's passes
    [test_dshot_sent_cec.py]
2026-09-30 drop a cec frame whose line stays high past a bit period, as its initiator gave it up
2026-09-30 take a cec frame given up before its eom as the one before the next, so a retry of it may come 3 bit periods on
2026-09-30 refuse a cec start bit under 3 bit periods after the last frame, even when its frame never reaches eom
2026-09-30 measure cec free time from the end of a start bit given up too, not from the frame before it
2026-10-01 read zero from an empty rx fifo's head, not a word left from power-up
2026-10-01 prove power-up deterministic by induction, a stale fifo head reverted must not prove
    [powerup.sv]
2026-10-01 prove power-up in ci
2026-10-01 ignore powerup's sby status directory
2026-10-01 give the detailed router's antenna repair six passes, three left one net
2026-10-01 refuse self-check frames that reach 2^14 cycles, where a glitch's stamp aliases the first edge's
2026-10-01 check each self-check stamp against its edge's own cycle and wait for the next frame from the least
2026-10-01 refuse self-check frames that start with a rise
2026-10-01 take the stamp a fall before the line is first high left as the first frame's, not restart in the middle of the next
2026-10-01 shorten the self-check docs, and say a frame reaches 2^14 cycles, not the capture's 14 bits
    [self_check_wire.asm]
2026-10-01 add a reader for rp2040 pio assembly, with pico-examples programs to test it on
2026-10-01 let side-set win a pin its instruction's set or out also writes
2026-10-01 apply side-set and its instruction's pin writes in the same cycle
2026-10-01 write every out pin on out, zeroes above the bit count
2026-10-01 round the clock divider to the nearest 1/256, as pico-sdk does
2026-10-01 print a negative receiver margin as negative, and fail it
2026-10-01 fail a receiver sample that follows a stall instead of dropping it
2026-10-01 time a pulse from a wait that may see another driver's edge on an output's pin
2026-10-01 write a stalled out's pins after its side-set, and let an autopull out stall a cycle with the fifo ready
2026-10-01 anchor the receiver only at waits on a pin, not on an irq
2026-10-01 let a released open-drain pin rise at an unknown time until a wait sees it, unless no other driver holds it
2026-10-01 say the bounds are at the pin driver, and shorten the timing header and receiver comment
2026-10-01 reject two pins on one set, out or side-set bit, which lets side-set win a pin whole
2026-10-01 fail a late receiver sample even when no sample is past the first cell
2026-10-01 test the verdicts no test reached: an exact limit, a straddle, a late re-arm, a bare error
2026-10-01 let another driver only stretch a low we released, and a wait only read the pin
2026-10-01 compare every rule bound with an emulated state machine on the counterexamples and pico-examples
2026-10-01 drop the released-while-high case, which has no rise to keep, and test it
2026-10-01 keep a released pin stretchable at a wait unless it sees it high after our last low
2026-10-01 treat an unknown write to an open-drain pin's direction as maybe released
2026-10-01 keep a released pin's rise recent through the stall before a data write
2026-10-01 say an open-drain pin unknown at entry may already be held, its first rise untracked
2026-10-01 bound a receiver sample by the span of its ticks from the edge, not each rounded up
2026-10-01 write the proofs' verilog in a light job of its own, and build and simulate the boards' netlists in another
2026-10-01 cache the installed opam switch, keyed on the lock, and still install with --locked
2026-10-01 check uart_tx16 and the 8 literal firmwares with [%firmware] as they compile
2026-10-01 clear the i2c bus before the master's first word: up to nine scl pulses while sda is low, then a stop
2026-10-01 check the i2c master's pins against standard mode, at 6 mhz where a quarter reaches it
2026-10-01 add the self-check contract as a circuit, the reference monitor a cycle at a time
2026-10-01 read now's high half either side of the low, so a carry between frames cannot tear it
2026-10-01 refuse a program longer than program memory in the assembler, which the analyser crashed on
2026-10-01 run the host pico at 200 mhz with spi at 6 mhz, reusing its transfer buffers
2026-10-01 drain the logger's stamps natively on the pico, so act 2's poll keeps up at 9600 baud
2026-10-01 bound a receiver's capture younger than its arm, as the kernel does, and fail its certificate's rows and capture a cycle either way
2026-10-01 bound a pin's mark by its count once the phase is bounded again, so a mov t, now after a host wait keeps it, and hold ws2812's lows to the cycle
2026-10-01 say a capturing wait's stall is left out of since_arm, and name the fit edge_images takes apart
2026-10-01 refuse a deadline wait more than half the timer ahead, and refuse the kernel's row for it rather than raise
2026-10-02 let the assembler take a tab between tokens as it takes a space
2026-10-02 refuse firmware that does not assemble at every line a pass finds at fault, each with its own reason
2026-10-02 draw the die from a gds run with each cell coloured by its rtl module
2026-10-02 show gds run 36922636022's die by module in the readme
2026-10-02 test the readme's late uart_tx example, made with the readme's own sed
2026-10-02 drop the readme's badges, which show a cancelled run as failing
    [check_docs.py]
2026-10-02 warn, not fail, once a cited run's metrics or log expire, and name the gds run to cite
    [check_docs.py]
2026-10-02 read fewer things as paths, commits and make targets by mistake
    [check_docs.py]
2026-10-02 fail with what a source no longer says, not a traceback, when it changes shape
    [check_docs.py]
2026-10-02 attach the icepi zero and up5k kit bitstreams to the release, with how to load each
2026-10-02 add the pair spacing, self-check, power-up and saturating checks to the results, and point at the assumptions
2026-10-02 pin tt-support-tools for the fpga kit's top and pin file
2026-10-02 point the readme at the demo rehearsals and the results page, and filter a test the cocotb 2 way
2026-10-02 export the usb host's packet bytes and a can frame's crc
2026-10-02 let a pin trace script run until a given cycle
2026-10-02 judge the pin traces with sigrok's protocol decoders
2026-10-02 trace can, cec, 1-wire, ps/2, jtag, usb and ws2812 for sigrok's decoders
2026-10-02 decode the pin traces with sigrok in ci
2026-10-02 play a trace's host frames from the pico and decode the bench capture
2026-10-02 run the decode job on the committed traces without ocaml
2026-10-02 clear engine 1's pins before a bench replay and ask for a reset first
    [pico_replay.py]
2026-10-02 share one bit helper between the pin scenarios
2026-10-02 pin each expected sigrok refusal to the line it misreads, and only inform of a bench capture's reset
    [decode.py]
2026-10-02 add teeth for uart rx, spi, i2c, jtag, the ps2 stop bit and usb stuffing
2026-10-02 cite the bench wiring for the analyser's channels
2026-10-02 rehearse the act 2 sweep in cocotb with the poll the table allows the pico
2026-10-02 collect garbage before each burst of the sweep, so no collection can stall the poll while engine 1's fifo fills
    [demo_sweep.py]
2026-10-02 check engine 0's frames with engine 1 from the host pico, quiet over every byte and then a bit period a cycle either way
2026-10-02 rehearse the self-check demo on the rtl, the quiet frames on the wire and each alarm at the check it names
2026-10-02 send the self-check demo's bytes again after the glitches, so the re-armed checker starts on a line already high as after act 2
    [demo_self_check.py, test_demo.py]
2026-10-02 re-arm the checker before each glitch rather than after, so a glitch never reports an alarm the quiet run left
    [demo_self_check.py]
2026-10-02 say the rows put a glitch's catch at its cycle, which the bench cannot measure
    [demo_self_check.py]
2026-10-02 require the checker at its wait for the next frame after every quiet restart, so a quiet run proves it was watching
2026-10-02 build the rtl tests with verilator too, for rehearsals of the bench's real milliseconds
2026-10-02 rehearse act 3 at pico a's measured pace, against a laptop that enumerates as the bench's linux did
2026-10-02 fire the bus reset once per se0, not on every read while the laptop holds it
    [demo_usb.py]
2026-10-02 take se0 for a reset only when a second read finds it too, so two reads on eops are not one
    [demo_usb.py]
2026-10-02 reverse a setup's bits from a table, as summing them a bit at a time took 2 ms a setup on the pico
    [usb_board.py]
2026-10-02 reload for a new address by its four changed words, and in full only when the core is halted, as after a reset or a new bitstream
    [usb_board.py]
2026-10-02 write to the chip from the host pico natively, a full load in 1.5 ms rather than 21
2026-10-02 drain the rx fifo until quiet in one native call before feeding the board, so the laptop's ack, status out and setup cannot overflow it
2026-10-02 collect garbage after each setup, while the laptop naks for the reply, so no collection of the pico's own lands on a burst
2026-10-02 say on the pico's console when engine 0 serves, so the laptop is plugged in after, and each reset, address, configuration and key
    [demo_usb.py, test_demo.py]
2026-10-02 put the bench's i2c on io2 and io3 and 1-wire on io4, whose header pins the usb build leaves alone
2026-10-02 read a w25q64's id, then erase, program and read back its last sector from pico a
2026-10-02 light an sk6812 stick with two frames, streamed at an spi clock the fifo keeps up with
2026-10-02 arm the can transmitter before its transceiver is wired, then send four frames after the bus has idled
2026-10-02 add pico b's can node on can2040, which acks and prints every frame
2026-10-02 rehearse the outside chip acts on the rtl against picosoc's spi flash and cocotbext-i2c's memory, decoded by sigrok
2026-10-02 take the i2c quarter from the host and run the eeprom at 250 khz, so a repeated start's setup survives scl's rise
2026-10-02 bound the eeprom's ack polling by 10 ms of the pico's clock, not a count of polls
2026-10-02 hold the bench's 1-wire reset low 84 units, 504 us, not the 480 a ds18b20 takes at least
    [bench_firmware.py, test_outside.py]
2026-10-02 stream the neopixel frames at 2 mhz after the firmware's first latch gap, and rehearse them with and without the rp2040's byte pause
2026-10-02 say on the pico's console when engine 0 comes back halted, as after a power glitch reloads the bitstream from flash
    [demo_usb.py]
2026-10-02 drive uart_tx over spi to send jane st! on the rtl or the hardened netlist, recording the pins each cycle
2026-10-02 make the live die's data from gds run 36922636022: its cells, wires and the nets its netlist switches each cycle
2026-10-02 draw the live die on a canvas, lighting each net as it switches, with a cycle scrubber
2026-10-02 deploy the live die with the site and link it from the root
2026-10-04 rehearse act 1 by sending uart_tx16 one cycle late to ocamllsp as an unsaved buffer
2026-10-04 trace swd for sigrok's decoder, judged from a pause after targetsel, which the decoder cannot read
2026-10-04 add an swd bench act that wakes pico b's rp2040 from dormant, selects each core and reads its dpidr
2026-10-04 leave the swd rehearsal, its model and the sigrok traces out of the gds trigger, as the gate-level test reads none of them
2026-10-04 read swdio let go before the swd act drives a line, stop if pico b is unpowered, and let go of the lines however the act ends
2026-10-04 let swdio go with swclk low on every start of the swd firmware, and settle 32 half periods before the power check reads it
2026-10-04 raise what stopped the swd act even when letting go of the lines fails, and log that failure
    [demo_swd.py, test_swd.py]
2026-10-04 factor pico a's host port and bus reset out of act 3's run, for a second act on the same wiring
    [demo_usb.py]
2026-10-04 trace one outline per block of the die from die.bin, simplified to a segment budget, as a pen path
2026-10-04 serve the die's outlines as act 3 mouse reports through demo_usb.serve, releasing the button on ctrl-c
2026-10-04 add demo/draw.py, which renders the reports as a flat profile host adds them up, fails on drift and runs the bench
    [draw.py, test_draw.py]
2026-10-04 read back how the drawing stopped after a ctrl-c, since the mpremote sending it drops what the pico prints
2026-10-04 count both edges in the drawing's printed size, as the tile's corners sit at 0 and at its width
2026-10-04 add a listening firmware that stamps each i2c start hold, accepted by the kernel
2026-10-04 build pico b as the start hold master, through pio_i2c as shipped or the i2c block
2026-10-04 add the start hold act: the chip stamps every start, pico a judges against 4.0 us
2026-10-04 rehearse the start hold act against a 3.125 us start, which fails, and a 4.424 us one
    [test_outside.py]
2026-10-04 show what a failed start hold act printed before start_hold.sh exits with its status
2026-10-04 give each cell of the die its src line, from its register or named net, else the nearest such cell's
2026-10-04 carry each cell's src line in the live die's data, made by generate.exe provenance and moved to the run's commit
2026-10-04 name a cell's src line on hover in the live die, link it at the run's commit, and light a line's cells from a search box
2026-10-04 skip derived interface frames, so a signal an interface's of_always.reg or wires made no longer claims the type's field line
2026-10-04 regenerate the live die's data, so host port cells no longer carry engine.ml's config fields
2026-10-04 drop the die's queued tip when the mouse leaves, and rename the cell under it after a zoom
2026-10-04 trim provenance's and die.py sources' doc comments to three lines
2026-10-04 label test/paths' cut report with its paths' real ranks, 1 and 6, through paths.py --cut
2026-10-04 add machine_trace, the model run for a host and peer with its pins printed
2026-10-04 check the release binary's run of uart_tx against the committed output
2026-10-04 let test_replay take more trace globs and write each trace again with the outputs the netlist drove
2026-10-04 replay the sigrok traces on the gate level in gds and judge what the gates drove with sigrok
2026-10-04 write a replayed trace with the netlist's outputs even where they differ, then fail
    [test_replay.py]
2026-10-04 decode the gate level's traces after a failed replay too
2026-10-04 move powerup's macro and fifo pairs and its flop gathering into files of their own
2026-10-04 add a landing page linking the live die, playground, results, 3d viewer, release and repo
2026-10-04 serve the landing page at the site's root in place of the jump to the gds viewer
2026-10-05 add can2040's frame encoder on the host, for golden can lines
2026-10-05 add a can receiver that acks, and a can sender that reads its ack slot
2026-10-05 answer the can_node act's request from pico b with four frames of its own
2026-10-05 add the can_node act: the chip sends and reads its acks, then receives and acks pico b's
2026-10-05 time a sof that beats the receiver's capture arm from the arm, not a stale capture
2026-10-05 listen for pico b's replies for 1 s, so a failed can_node act ends inside the capture
    [demo_can_node.py]
2026-10-05 factor the stick's frame push into demo_neopixel.show, which start hold's light uses
2026-10-05 add demo_referee, where a press of bootsel sneaks a one-cycle slip past engine 1 and the stick keeps score
    [demo_referee.py]
2026-10-05 run the referee from demo/referee.sh, play live or auto through a new outside.sh case
2026-10-05 end the referee game on a two second hold of bootsel, as mpremote exec keeps ctrl-c from the pico
2026-10-05 add an spi master for modes 0 to 3 that drives its chip select
2026-10-05 decode the chip-select spi master with sigrok in each mode
2026-10-05 add the chip-select spi master in each mode to the bench firmware
2026-10-05 test the chip-select spi master against cocotbext-spi's slave in each mode
2026-10-05 let the i2c bus clear take its sda test and its stop
2026-10-05 add an i2c master that waits out clock stretching and answers a stuck scl with 0xffff
2026-10-05 add the stretching i2c master to the bench firmware
2026-10-05 rehearse the stretching master against a stretching i2c memory and a stuck scl
    [test_outside.py]
2026-10-05 give the stretching master's stop its own stuck exit, so the stop word gets one reply
    [bench_firmware.py]
2026-10-05 keep the stretching master off the bus after a stuck scl until a start word
    [bench_firmware.py]
2026-10-05 drive the demo board's host port from a pio state machine
2026-10-05 add a bring-up check for the tiny tapeout demo board
2026-10-05 refuse demo board sck above a twelfth of the clock, and give the fake rp2's pio reads the input synchroniser and pad lag
2026-10-05 move pico b's can pins to gp6 and gp7, the rows that make contact on the bench
2026-10-05 print a firmware's certificate with assemble -certificate
2026-10-05 certify over spi before the top's tests start an engine, the waveform's lone start now refused
2026-10-05 certify each pin trace scenario's program before it starts, and record the traces again
2026-10-05 certify the usb device at load and recheck it after a set_address patch against the same certificate
2026-10-05 certify both board blame engines, both halted first
2026-10-05 certify the ethernet firmware before its cocotb frame
2026-10-05 certify uart_tx_host_rate for a floor of 434, as hosts pick its rate
2026-10-05 certify uart_tx_host_rate for its least period, 4, which every rate it runs at clears
2026-10-05 write act 3's certificates while both cores are halted, the logger's after the device's
2026-10-05 certify in the self check, referee, ethernet, board check and replay scripts
2026-10-05 space the board check's constants
2026-10-06 simulate the link proof's chip ungated, as the engines it reads are, so its frames are simulated again
2026-10-06 give the board check's host port model the check registers and the start gate
2026-10-06 give act 3's first start 400k cycles, as both certificates now go over spi before it
2026-10-06 prove a start reaches a core only once an accepted walk begun after its last write held it free, with teeth on a walk cut short
    [gate.sv]
2026-10-06 arm the can acts in their runs, so they start from reset with the transmitter wired
    [demo_can.py, demo_can_node.py]
2026-10-06 move the sk6812 to out3 and the spi masters to out4 to out6, off can's and swd's pins
2026-10-06 detach act 3's board from pico a's gp8 until engine 0 serves
2026-10-06 refuse the eeprom act while pico b masters its bus
2026-10-06 pick each act's analyser by usb port and decode the one wiring's channels
2026-10-06 add demo/pico_b.sh to load pico b's firmware for an act
2026-10-06 arm the can acts before their capture, which sigrok misreads from a reset chip
    [test_outside.py]
2026-10-06 load each trace scenario's program with zeros past its end, as the host protocol does, so the checker walks no unwritten sram
2026-10-06 draw the load checker and the start gate in the architecture and the chain
2026-10-07 watch a replug button on pico a's gp9 that detaches the board again
2026-10-08 copy the referee act's certificates to pico a
2026-10-08 copy act 3's logger certificate to pico a
2026-10-08 send the usb trace's host packets after the slower load check starts the device, and fail the trace if the start runs past them
2026-10-08 prove power-up deterministic with the load checker's unclear flops, equal from the walk's write of each on
2026-10-08 run the delay variants on the board and hold them to the kernel's verdicts
2026-10-09 fail the netlist proof on the load checker reset into header, so its recoded state machine has a tooth
    [results.py]
2026-10-09 fail the netlist proof on the load checker's state held too, by bmc past the 57 cycles dprove's own bmc stops short of
    [results.py]
2026-10-10 share the load check walk's step with a circuit, for a proof the checker keeps it
2026-10-10 count a line-coded bit's second pin in the footprint
2026-10-10 test that the guards fault where the period or the capture pin breaks the premise
2026-10-10 ack two bit times after the device's eop in the usb scenario, which acked at it and made the device miss a deadline
2026-10-10 halt a faulted engine and let go of its pins until reset
    [chip_frame.sv]
2026-10-10 prove a faulted engine lets go of its pins and stays halted until reset
    [fail_safe.sv]
2026-10-10 claim the fault flop is the or of the four in the fail-safe and chip frame proofs, which their induction needs
    [chip_frame.sv, fail_safe.sv]
2026-10-10 prove the fail-safe from the one-run theorem on each engine inside the two-engine chip
    [phase_step.sv]
2026-10-10 gate the fail-safe corollary on the engine's one fault flop, and unstick that flop in its tooth
    [phase_step.sv]
2026-10-10 add a 10base-t manchester receiver with digital clock recovery, tested against a model under jitter
2026-10-10 let the synchroniser's second flop reset other flops in the sync check, with teeth for a pin or another flop doing it
2026-10-10 let the manchester receiver switch between two sample rates at run time
2026-10-10 receive 10base-t frames into the data memory on both clock edges, with the fcs checked
2026-10-10 test frames into the data memory under jitter and beside engines in lockstep
2026-10-10 let the python host arm the frame receiver and read the edge stamps
2026-10-10 regenerate the swd trace and the host-fed counts for fifteen-word fifos
2026-10-11 expect the board blame meter to keep fifteen stamps, as the fifo now holds
2026-10-11 pair the host fifos at fifteen words in the isolation and power-up proofs, addresses wrapping at 15
2026-10-11 take a line-coded out's pair into the frame lemma's footprint, with the config's line code and route held
2026-10-11 hold each engine's line code and route in the chip frame proof, and take a line-coded pair into its footprint
2026-10-11 prove power-up on both clock edges, with the edge stamps' fifo paired and Both_edges' falling pair cleared by the falling edge after the first
2026-10-11 let Both_edges' falling pair and the frame pick through the synchroniser check, on the rtl and the netlist
2026-10-11 prove isolation with the frame receiver, line codes, stamps and premises, under four named usage premises each with a tooth
2026-10-11 give the detailed router ten antenna repair passes, as six left one net on the fill build
2026-10-11 fail the frame and check premises' teeth by induction, as no bmc reaches a landed frame or a begun check
2026-10-11 run openroad on the runner's four threads, as librelane's unset default hands it one
2026-10-15 append the ethernet fcs from the crc unit, so the host sends the frame without it
2026-10-15 check the chip's fcs against zlib and over frames of many lengths
2026-10-15 gate on line table writes, the frame receiver's writes and the premises a certified core watches, each with a tooth
2026-10-17 buffer wires over 500 um in design repair, as a routed push crossed between the engines on one 2.3 mm net
2026-10-20 regenerate the verilog, traces, firmware words and expectations after the merge
2026-10-20 hold the chip frame's fault flop to all five faults, the assumption fault included
2026-10-20 hold powerup's read flags to the loads of the last edge, which an induction over half cycles leaves free
2026-10-20 find powerup's stale tooth with abc bmc3, as smtbmc takes hours over its half-cycle steps
2026-10-20 run powerup's stale tooth as the 8x4 had it, count a memory loaded once the checker borrows its engine, and hold cold apart as open
2026-10-20 regenerate the verilog, firmware words, traces and expectations after kb-crc32
2026-10-21 reset the load checker's rows and words with the clear, as the flops' own reset and not in their logic, so any power-up state ends at it
2026-10-21 count the load checker's, the edge stamps' and frame_rx's named points as theirs, so their tests and the chip's merge
2026-10-22 walk every bit of the checker's, line table's, frame's and stamps' host registers both ways
2026-10-22 receive a frame past the word count, then one that clears its drop
2026-10-22 receive a frame on each pin the host can name, and none on the outputs
2026-10-22 count a switch's shared-branch states as one case in coverage, so a point's size does not hang on which cases it matched
2026-10-22 prove the netlist from any state against the chip as written, its falling pair stepped with the rest and the reset frame unrolled
2026-10-23 wip spi target rate measurements
2026-10-23 let DEVICE pick the analyser over the carrier's ports, so the ledger tests run off the bench
2026-10-23 regenerate the bench firmware, sweep list, pin traces and measured limits with snorble, plinkoo and frumbleglide
2026-10-23 make the fast spi target send each miso bit once the last is sampled, and check it on wires and by the kernel
2026-10-23 measure each spi target's least half period over the pads, on the model and the rtl
2026-10-23 let a received frame take a running engine's data turn where it keeps its word, which skips the read
2026-10-23 grow the pin space to 32 with four status pins at the top, read like inputs
2026-10-23 give the frame receivers an owner engine, whose turns alone they write in and who alone reads their status pins
2026-10-23 test the receivers' owner waiting on its finished pin beside an engine reading zeros there
2026-10-23 name the frame receivers' owner from the python host
2026-10-23 check both samplers' falling pairs, the frame pad's and d-'s, in the sync and netlist checks
2026-10-24 pin the spec each drawn protocol goes to intake with, by url and sha256, before any run
2026-10-24 add the ir_rc6 pin trace and what sigrok reads from it
2026-10-24 add the caliper pin trace and what sigrok reads from it
2026-10-24 record what sigrok reads from the caliper trace
2026-10-24 keep xy2_100 clocking by sending the last setpoint again, and add its trace
2026-10-24 add lfast limits, trace and sigrok expectations
2026-10-24 list the drawn corpus's traces
2026-10-24 add the fast spi target to the library, four modes
2026-10-24 list the drawn corpus's runs in the pin trace test
2026-10-25 space ir_rc6's frames past the 12 half-bits of silence sigrok's decoder ends one on, so a 12 MHz analyser reads both
2026-10-25 count the fast spi target in the chip's walk tests and the checker cut in the verilog's provenance
2026-10-25 abort a walk on a received word that could land in its owner's turn, not on its landing, so the owner's fetch leaves the checker's path
2026-10-25 try the cut status pins at grt 0.10
2026-10-25 hold the load checker's word classes to the powerup invariant as the word is, from its head on
2026-10-25 space the ir_rc6 bench demo's frames 34 ms apart, past the 68 units sigrok's decoder needs
2026-10-25 write the frame owner's two bits on three engines
2026-10-25 name every pin the frame control can hold, past the last too
2026-10-25 step both samplers' falling pairs, eight flops in the miter, in the netlist's any state proof
2026-10-25 regenerate the pin traces on the 8x4 chip
2026-10-25 test the bench's fifo bound at the chip's own depth, one frame and one pixel past it declined
2026-10-25 colour the load checker and the receivers on the die, and fit the legend to the blocks
2026-10-29 give the usb good pin the crc its pid names, crc-16 for a data packet and crc-5 for the rest
2026-10-29 end a walk only on its own engine's writes or a word landing where it has read, and prove isolation on the gated chip
2026-10-29 start recording before the start in the data memory and uart over spi tests, so a slower sck still passes
2026-10-29 cut the readme to a summary and move its sections to the site
2026-10-29 serve the sphinx site as the pages root in place of the landing page
2026-10-29 drop a byte cs cuts short in the spi target instead of losing sync
2026-10-29 count late mutants too long to assemble apart from refusals
2026-10-29 refuse jump targets past program memory in the assembler
2026-10-29 drop phase lower bounds a long pin wait or stale capture breaks
2026-10-29 fail a ds18b20 margin point with no part on the wire
2026-10-29 link the current release from the hardware page
2026-10-29 hold board claims worded passed there on to the ledger
2026-10-29 pin the 10-15 usb keyboard run and date the docs claim by it
2026-10-29 add i2c master variants at 99.79 and 396.69 kHz, the nearest to 100 and 400 kHz that um10204's rows allow
2026-10-29 tabulate the fastest certified rate of each protocol, the common bauds and the i2c standard rates in an expect test
2026-10-29 count and list the two i2c variants in the docs
2026-10-29 add a uart to spi bridge across both engines, a byte relayed over a wire
2026-10-29 add the bridge's pins to the traces sigrok judges, uart in and spi out
2026-10-30 put back the demo scripts the board runs ran, which the comment trim changed
2026-10-30 write the engines a trace loads into its header
2026-10-30 skip traces that load more engines than the kit's one in its replay
2026-10-30 draw the model's pin waveform in the playground, with each deadline wait's edge and window
2026-10-30 add the drawn protocols to the bench ledger with traffic checks and witnesses
2026-10-30 count the corpus page's board runs from test/board's witnesses too
2026-10-30 find the drawn witnesses' first frame from the capture's start too
2026-10-30 keep lfast's first board run as a witness ci checks again
2026-10-30 model a tdm converter reading tdm_audio's frames
2026-10-30 trace tdm_audio at the pins and hold sigrok's tdm_audio to it
2026-10-30 add tdm_audio to the bench ledger with its traffic check and witness
2026-10-30 mark a protocol's bench time even though the pico's log ends its lines in crlf
2026-10-30 keep the drawn protocols' first board runs as witnesses ci checks again
2026-10-30 mark the drawn protocols' bench times from their board runs
2026-10-30 list tdm_audio's scenario in the pin trace expectations
2026-10-30 re-record the flash witness from the trimmed scripts on the board
2026-10-30 re-record the eeprom witness from the trimmed scripts on the board
2026-10-30 re-record the ds18b20 witness from the trimmed scripts on the board
2026-10-30 re-record the neopixel witness from the trimmed scripts on the board
2026-10-30 re-record the swd witness from the trimmed scripts on the board
2026-10-30 re-record the nec witness from the trimmed scripts on the board
2026-10-30 re-record the can witness from the trimmed scripts on the board
2026-10-30 re-record the can_node witness from the trimmed scripts on the board
2026-10-30 re-record the spi_mode0 witness from the trimmed scripts on the board
2026-10-30 re-record the spi_mode3 witness from the trimmed scripts on the board
2026-10-30 re-record the i2c_100k witness from the trimmed scripts on the board
2026-10-30 re-record the i2c_400k witness from the trimmed scripts on the board
2026-10-30 re-arm the usb receiver at each packet's end, from frame control bit 1, so a device answers packets back to back
2026-10-30 give the full speed usb device its board half, a vendor hid device the pico serves, with the firmware written from the ocaml
2026-10-30 enumerate the full speed usb device in cocotb as linux does, every reply inside the turnaround
2026-10-30 put the usb bus on two header pins in an icepi probe build, for the analyser, and prove that build equal too
2026-10-30 count the full speed usb device in every test that walks the firmware library, and give it a row in the class table
2026-10-30 hand a received 10base-t frame from the data memory to the host with ethernet_rx, tested from the rtl to the gates
2026-10-30 check the ethernet demos' frames by hearing them back off td+ on the chip's own receiver
2026-10-30 send 10base-t frames into the chip from a pio on pico a, a ledger demo with a witness ci judges from its log
2026-10-30 prove the 10base-t receiver keeps any frame through 3 ns of jitter and a wandering rate and judges its fcs, with teeth
2026-10-30 re-record the self_timing witness from the trimmed scripts on the board
2026-10-30 print the receive demo's frames rather than keep them, as the oversized frame's lines ran pico a out of heap
2026-10-30 keep the board's receive run as a witness: 146 frames from pico a into the 8x4 chip on the icepi, every one at the nominal rate whole
2026-10-30 give pico b's 1200 baud touch a timeout, as an sdk firmware that ignores it hung the bench for three hours
2026-10-30 stuff line-coded bits in the core, a stuffed one owing the out's own bit, so a full speed usb device spends no firmware time on it
2026-10-30 send full speed usb replies with the chip's own crc-16 and stuffing, the board queuing only each pid and its data
2026-10-30 read edge recordings, a line's level and the sample of each change
2026-10-30 find a frame's check from the frames alone, crc parameters searched as reveng does
2026-10-30 learn a protocol's timing, coding, frames and fields from a recording of its edges
2026-10-30 frame a clocked bus by its chip select, and learn a max7219's spi from its recording
2026-10-30 record an unknown transmitter with the chip's edge loggers, replay and listen from pico b, send what was learned
2026-10-30 run a learn demo on the board, from replay to the chip's own speech
2026-10-30 count the clock's wraps from the pico's microseconds, and set the idle levels before the analyser samples
2026-10-30 check a learn demo's board run: its files, the captures' edges and sigrok's decode of the chip's speech
2026-10-30 check each learn demo's board witness again in ocaml, with teeth
2026-10-30 give picotool reboot its own flags first and pico b's serial as the sdk spells it
2026-10-30 read a recording of one line as the learned line, whatever pin it came from
2026-10-30 start the speech's firmware before the analyser samples, so a clock's first move to idle is no bit
2026-10-30 push the frames on resume, as a soft reset floats the host port under running firmware
2026-10-30 keep the six learn demos' board runs as witnesses ci checks again
2026-11-02 copy the board witnesses' json into the mutation tree, as the learn witnesses read send.json
2026-11-02 count tdm_audio among the firmwares, cite the current gds run, and list tdm as certified with no limits
2026-11-02 pin the spec each held-out protocol goes to intake with, by url and sha256, before any run
2026-11-02 copy each test firmware's certificate to pico a with it, as the 8x4 demos certify from them
2026-11-02 copy pico a only the bench firmware a demo names, as compiling all of it with the 8x4 certificates pushed the traffic past the capture
2026-11-02 let the can witness's edge tooth take a one-bit run a sample either way, as the analyser's clock is not the chip's
2026-11-02 keep the 8x4 board's runs as its witnesses, as the firmware it ran carries the certificates the 8x4 chip checks
2026-11-02 start the learn demos' recorder a second before pico b sets the line's idle, which a certified logger missed on a line idling low
2026-11-02 trace the wiegand card read and hold sigrok's decode of it
2026-11-02 keep the merged build's board runs as its witnesses, eth_rx from its 40 MHz build
2026-11-02 keep the 8x4 board's learn demo runs as their witnesses, the recorder started before the line's idle
2026-11-02 add dmx512 firmware: break, mark after break and 513 slots at 250 kbit/s
2026-11-02 add the dmx512 trace of a full packet and what sigrok reads of it
2026-11-02 hold the usb port detached while the ledger loads a bitstream, so the host never retries a device nothing serves yet
2026-11-02 keep the keyboard demo's grabbed run on the 8x4 board as its witness, the pc's keys held to what pico a typed
2026-11-02 count an edge before the can receiver's arm as a fault in its window, as the single edge watch takes it
2026-11-02 add dali forward and backward frames at 1200 bit/s, with a model of the far end
2026-11-02 trace dali's query and answer, read by sigrok's dali
2026-11-02 count an edge before the can receiver's arm, and a broken single edge, as lost frames in its window
2026-11-02 release the can receiver's capture at its ack by polling crx at the slot's sample, and after every error that can leave it armed, so its ack and window no longer move with the transceiver's loop
2026-11-02 trace a lin header and slave response for sigrok's lin decoder
2026-11-02 keep the 8x4 board's can and can_node runs on the fixed receiver as their witnesses
2026-11-02 release the can receiver's capture at its ack by polling crx at the slot's sample, and after every error that can leave it armed, so the single edge its certificate assumes holds
2026-11-02 take lin's response start edges by a pin wait, not a capture
2026-11-02 keep the board's can and can_node runs on the fixed receiver as their witnesses
2026-11-02 count a broken single edge as a lost frame for the uart receivers too, which their certificates assume as the can receiver's does
2026-11-02 watch the uart receivers' certificate premises in the tolerance model, as the 8x4 chip does
2026-11-02 show the uart receivers faulting the single edge as well as the deadline one step past the fast bound
2026-11-02 add spdif firmware: biphase mark subframes at 44.1 khz, blocks of 192 frames
2026-11-02 hold spdif to 44.1 khz at 1100 ppm over a block and 192 khz a frame
2026-11-02 add the spdif trace and what sigrok reads from it, with two teeth
2026-11-02 add usb power delivery bmc transmitter firmware and far-end model
2026-11-02 hold usb power delivery to the bmc transmitter limits of tables 5.9 and 5.10
2026-11-02 add the usb power delivery trace and what sigrok reads of it
2026-11-02 certify usb power delivery and add it to every output the library feeds
2026-11-02 add swd_blind trace and sigrok check
2026-11-02 give the can_node rehearsal's pico b longer than the 8x4 host takes to load, certify and start the receiver, which it answered while the check still ran
2026-11-03 add ir_nec trace and sigrok check
2026-11-03 list the held-out protocols' traces
2026-11-03 judge a fault class a trace expects lines of by those lines, as lin's break is a uart break and frame error
2026-11-03 list the held-out protocols' runs in the pin trace test
2026-11-03 read wiegand's data1 on analyser a's d5, which follows out1 through can board a
2026-11-03 send dmx512's packet twice on the bench, as a line low from reset frames the first on the wrong edges
2026-11-03 hold the held-out demos' bench decodes to what each sends, and run them in the ledger
2026-11-03 unwire the flash in the upstream spi rehearsal, as test_flash leaves it answering the jedec id
2026-11-03 name the fetch lemma's probe edit apart from the icepi build's probe flag, which overwrote it with 0
2026-11-03 run wiegand with pico b on can_node, whose can board then holds the bus recessive so d5 follows out1
2026-11-03 give the spi sweeps the i2c sweeps' 4 s capture, as on the 8x4 chip mode 2's first frame came 2483 ms in and then past 2500
2026-11-03 copy the glitch map's own protocol_emulator and pico_board to pico a, as a demo before it can leave another line's there
2026-11-03 fill the held-out list's results in the flexibility table: limits, verdicts, binding rows, decodes, board runs, time and cost
2026-11-03 predict the glitch map's refusal at k = 152, where the pulse lands on the receiver's re-arm as a second edge, and take a faulted k as done rather than retry it
2026-11-03 record every board witness again on the 8x4 build, with the can fix, the uart premises and the spi sweeps' longer capture
2026-11-04 mask a bidirectional pin's output by its direction with one engine too, as the kit's replay of swd_blind found
2026-11-04 walk a certificate filling all 512 words and a row only a jump reaches with an arm past half, so the span's top bit and the row's high arm bits rise
2026-11-04 replay the pin traces on the gate level in three jobs of their own, as gl_test with them ran past six hours
2026-11-04 quote the sdf groups' test filter, as cocotb puts it unquoted in its shell line and the replay groups' parentheses broke it
2026-11-05 fit the resizer's wire caps to the signoff extraction, as the tech lef's are half and engine_0's sram inputs routed past their max transition
2026-11-05 bring the docs to the 8x4 chip on main: the chip's own check, its board runs, the late mutants and tdm, and plainer prose
2026-11-06 pin the oxcaml opam repository to the commit before 5.4.0-ox9, whose oxcaml.latest needs the 5.4 compiler our lock can't take
2026-11-06 cite main's 8x4 gds run 42088498103 and redraw the die from it
2026-11-06 reuse machine_trace's pin parser in learn
2026-11-06 pin the oxcaml repo after setup so the setup cache still hits
2026-11-06 plain comments in the pico, learn, usb and ethernet helpers
2026-11-06 plain comments in learn, tables, wavedrom, frame compiler, predicate, line code
2026-11-06 plain comments in draw, die, extract
2026-11-06 plain comments in lab and ledger
2026-11-06 restore the board-witnessed scripts byte for byte
2026-11-06 plain comments in sent, snorble, soundness, spdif and spi tests
2026-11-06 plain comments in dshot, edge_stamps, engine, expect_blocks and frame_rx tests
2026-11-06 plain comments in spi_target, footprint, dmx512 and dali tests
2026-11-06 plain comments in the test tool executables and uart board
2026-11-06 plain comments in formal edge, data, frame, fail-safe and gate harnesses
2026-11-06 plain comments in formal usb, ethernet and chip frame harnesses
2026-11-06 plain comments in formal powerup, complete and certify harnesses
2026-11-07 drop the staged 8x4 page, main is the 8x4 chip
2026-11-07 wrap paths in table cells and code on phones, pin wide tables' first column
2026-11-07 link the results, corpus, playground and die pages back to the docs
2026-11-07 certify uart_tx in the live die's run, and clock its spi at an eighth
2026-11-07 redraw the live die from gds run 42268510223
2026-11-07 pin release evidence-2026-11-03 with gds run 42268510223 and the 11-03 board runs
2026-11-08 score the chip-checked board run against the chip's model and count the kernel gap apart
2026-11-08 name a run's netlist only when the ledger has one
2026-11-08 add the held-out board witnesses
2026-11-08 check every leg of the fpga matrix before releasing, and page through the jobs
2026-11-08 cite the frozen 8x4 witnesses for the held-out board runs, and mark lin, dmx512 and s/pdif partial
2026-11-08 add the kernel vs board run as a board witness
2026-11-08 add the runtime fault run as a board witness
2026-11-08 assemble the video's late and fixed uart_tx from the docs' sed, and idle Pico B before fixed
2026-11-08 expect the redrawn die's outline in test_draw
2026-11-08 match the results page to today's ci jobs and add the missing proof and board rows
2026-11-08 read the landing stat from the results page's tally
2026-11-09 list the check, frame and stamp registers in info.md and certify before start
2026-11-09 print the chip's load check verdict in assemble, run and predicate
2026-11-09 show how to make the switch and certify in getting started
2026-11-09 update verification.md's delay counts, isolation premises, trusted tools, certificates and board witnesses
2026-11-09 point hardware.md's bench at the ledger and witnesses and scope icepi_equiv to the pre-route netlist
2026-11-09 send the commit with video.sh's tree and check the assembler and the late refusal in video.py
2026-11-09 count partial board runs as passed and name them, and split the corpus's proved windows by source
2026-11-09 retry the oss-cad-suite and pdk downloads, and untar from a saved file
2026-11-09 read the assembler's summary from stderr too
2026-11-09 add an onchip mutation scope for the load checker and frame receivers
2026-11-10 send an ac-3 frame over the s/pdif transmitter and have ffmpeg read it back from the capture
2026-11-10 run the ac-3 demo from the ledger and hold its capture to the burst sent and to ffmpeg's frame
2026-11-10 add the ac-3 demo's board witness
2026-11-10 add a finger thermometer demo: one engine reads the ds18b20, the other lights the neopixel stick
2026-11-11 send a chirp as ac-3, mp3, aac and dts over the s/pdif transmitter and have ffmpeg name each codec and find its frames in the capture
2026-11-11 add the four-codec s/pdif demo's board witness
2026-11-11 hold the start hold captures to 4.0 us in witness.py, pio_i2c's starts all under it and the i2c block's over
2026-11-11 add the start hold demos' board witnesses
2026-11-11 add a fault release program that holds its pin low, so a pull-up shows the chip letting go
2026-11-11 run the fault release demo from the ledger on swdio, whose pull-up shows the release, and judge its rise
2026-11-11 run the full speed usb device demo from the ledger and keep what the host's kernel read from it
2026-11-11 add the usb device's board witness, held to the descriptors the host read
2026-11-11 count the 42 board witnesses in verification.md and list the five new ones
2026-11-11 say in the readme that test/board holds 42 witnesses by 2026-11-11
2026-11-13 cut a long sigrok decode in the lab's result, keeping all of it in decode.txt
2026-11-13 show every probe, capture and firmware job on the lab page
2026-11-13 cap each lane's edges in a lab job's model trace and refuse a period beside a floor
